myriadrf/LimePSB-RPCM/README.md

# LimePSB RPCM

Lime Planar System Board + Raspberry Pi Compute Module
