myriadrf/LimePSB-RPCM/hardware/1v4/LimePSB-RPCM_1v4_ChangeList.txt

Changes:
LimePSB-RPCM_1v4(_DB)_DFMr2:
 - Schematic changes:
	> BOM version changed from 0 to 1
	> Changed L2, L3 part number (wrong tolerance)
	> R153, R154 NF (disconnected USB hub SMBus from RPI_I2C0)
	> J3 - added additional info parameter and its value
	> Fixed DC barrel J50 part fields
 - PCB changes:
	> GND thermal pad added under miniPCIe on top soldermask and silkscreen
	> LED light pipe mounting hole radius reduced from 1.3 mm to 1 mm
 - DFM:
	> Schematic pdf generated
	> Gerber files and Drill files generated
	> BOM renamed to r2, skipping r1 name to match database
	> BOM updated - L2, L3 position P/N and info, removed R153, R154, J3 - added additional info parameter and its value
	> Pick and place files generated

LimePSB-RPCM_1v4(_DB)_DFMr1:
 - schematic page 5 - mechanical spacers changed to parts with footprints
 - M.2 connector (J3) footprint changed to MiniPCIe_connector_XTRX_v2, which doesn't include mounting holes
 - DFM files refreshed: Top paste gerber layer, Assembly drawings PDF, Pick and Place files, schematic PDF

LimePSB-RPCM_1v4(_DB)_DFMr0:
 - Initial version as an update for LimePSB-RPCM_1v3

LimePSB-RPCM_1v3(_DB)_DFMr2:
 - Created from LimePSB-RPCM_1v3(_DB)_DFMr1;
 - HD01-19-RA-TH changed to 2007435-3
 - Cosmetic schematic changes
 - New DFM files generated;

LimePSB-RPCM_1v3(_DB)_DFMr1:
 - Created from LimePSB-RPCM_1v3(_DB)_DFMr0;
 - Rakon TCXO thermal case hole size increased from 0.9mm to 1.5mm
 - New DFM files generated;

LimePSB-RPCM_1v3(_DB)_DFMr0:
 - Created from LimePSB-RPCM_1v2(_DB)_DFMr0;
 - FPGA added;
 - Reference clock with crystal and configuration headers added;
 - GPS added;
 - USB2 header changed to USB3 header;
 - New DFM files generated;

LimePSB-RPCM_1v2(_DB)_DFMr0:
 - Project name changed from LimeKEY-RPCM to LimePSB-RPCM. Version and revision follow the previous name;
 - Added support for Raspberry Pi CM5 module along with the old CM4. Most changes are related to provide support for both CM4 and CM5;
 - TX PA SBB-5089 changed to TQP3M9018 due to EOL;
 - Dual USB2 connector changed to dual USB3 with;
 - ADC/DAC voltage reference configuration changed (topology is the same);
 - 4-bit switch added for reconfiguring board setup;
 - PCB updated;
 - New DFM files generated.
 
LimeKEY-RPCM_1v1(_DB)_DFMr2:
 - PCB silkscreen updated;
 - BOM comparison to version LimeKEY-RPCM_1v0 added;
 - 0R added at J48 (ISNK_COARSE);
 - C193, C195, C216, C220, C228 changed to GRM21BR61E106KA73K;
 - JMP1, JMP7 made FIT;
 - New DFM files generated;
 
LimeKEY-RPCM_1v1(_DB)_DFMr1:
 - J1 connector P and N signals in diff. pairs swapped pins 9<->11 and 10<->12;
 - IC16A RTC with TSSOP8 package added as an alternative (NF default);
 - R255 for XO VC DAC voltage divider added (NF default);
 - 11 page POE_VDDL net C200 capacitor package changed from 0402 to 0603;
 - PCB updated;
 - New DFM files generated;
 
LimeKEY-RPCM_1v1(_DB)_DFMr0:
 - Initial version
