myriadrf/LimePSB-RPCM/hardware/1v5/PCB/LimePSB-RPCM_1v5.PcbDoc.htm

Reporting Options

# File in Newer Format

Date | : | 2024-10-09
Time | : | 10:48:03
Filename | : | d:\LimePCBs\LimeKEY_RPCM\GIT\hardware\1v3\PCB\LimePSB-RPCM_1v3.PcbDoc

Version | Warning
Release 17.0 | CAUTION - Component parameters added.
Release 17.0 | CAUTION - Support of backdrilling
Release 17.1 | CAUTION - Support of waived violations
Release 17.1 | CAUTION - Support of object specific keepouts

This file was generated by a later version of the software
