myriadrf/LimePSB-RPCM/hardware/1v1/PCB/LimeKEY-RPCM_1v1.PcbDoc.htm

Reporting Options

# File in Newer Format

Date | : | 2023-03-09
Time | : | 14:15:56
Filename | : | E:\Saniok\Lime Micro\Lime PCBs\LimeKEY_RPCM_1v1\Altium Designer design files\PCB\LimeKEY-RPCM_1v1.PcbDoc

Version | Warning
Release 17.0 | CAUTION - Component parameters added.
Release 17.0 | CAUTION - Support of backdrilling
Release 17.1 | CAUTION - Support of waived violations
Release 17.1 | CAUTION - Support of object specific keepouts

This file was generated by a later version of the software
