myriadrf/LimePSB-RPCM/hardware/1v5/Project Outputs for LimePSB-RPCM_1v5/DRC/LimePSB-RPCM_1v5.html

Altium

# Design Rule Verification Report

Date: | | 2026-06-23
Time: | | 15:41:12
Elapsed Time: | | 00:00:39
Filename: | | d:\LimePCBs\LimeKEY_RPCM\GIT\hardware\1v5\PCB\LimePSB-RPCM_1v5.PcbDoc

Warnings: | | 4
Rule Violations: | | 0

## Summary

Warnings | Count
Unplated multi-layer pad(s) detected | 4
Total | 4

Rule Violations | Count
Clearance Constraint (Gap=0mm) (Keepout),(InComponent('J3') or (isvia)) | 0
Clearance Constraint (Gap=0.1mm) (All),(All) | 0
Short-Circuit Constraint (Allowed=No) (All),(All) | 0
Un-Routed Net Constraint ( (All) ) | 0
Modified Polygon (Allow modified: No), (Allow shelved: No) | 0
Width Constraint (Min=0.1mm) (Max=5mm) (Preferred=0.2mm) (All) | 0
Width Constraint (Min=0.1mm) (Max=7mm) (Preferred=0.2mm) (All) | 0
Routing Layers(All) | 0
Routing Via (MinHoleWidth=0.2mm) (MaxHoleWidth=4.5mm) (PreferredHoleWidth=0.2mm) (MinWidth=0.31mm) (MaxWidth=5mm) (PreferedWidth=0.4mm) (All) | 0
Differential Pairs Uncoupled Length using the Gap Constraints (Min=0.1mm) (Max=0.3mm) (Prefered=0.1mm) and Width Constraints (Min=0.1mm) (Max=1mm) (Prefered=0.2mm) (All) | 0
Differential Pairs Uncoupled Length using the Gap Constraints (Min=0.1mm) (Max=0.3mm) (Prefered=0.14mm) and Width Constraints (Min=0.1mm) (Max=1mm) (Prefered=0.2mm) (InNetClass('ETH')) | 0
Power Plane Connect Rule(Relief Connect )(Expansion=0.508mm) (Conductor Width=0.254mm) (Air Gap=0.254mm) (Entries=4) (All) | 0
Hole Size Constraint (Min=0.2mm) (Max=10mm) (All) | 0
Pads and Vias to follow the Drill pairs settings | 0
Hole To Hole Clearance (Gap=0.15mm) (All),(All) | 0
Minimum Solder Mask Sliver (Gap=0.099mm) (All),(All) | 0
Net Antennae (Tolerance=0mm) (All) | 0
Matched Lengths(Tolerance=1.6mm) (InNetClass('HDMI0')) | 0
Matched Lengths(Tolerance=1.6mm) (InNetClass('DSI1')) | 0
Matched Lengths(Tolerance=1.6mm) (InNetClass('uSD_CARD')) | 0
Matched Lengths(Tolerance=1.6mm) (InNetClass('ETH')) | 0
Matched Lengths(Tolerance=1.6mm) (InNetClass('HDMI1')) | 0
Component Clearance Constraint ( Horizontal Gap = -10mm, Vertical Gap = Infinite ) (HasFootprint('MINIPCIE_CONNECTOR_XTRX_v2') or isfree or (((ObjectKind = '3D Body') And (Layer = 'Mechanical13') And (ModelType = 'Generic Model') And (Identifier = '622162x5')) or ((ObjectKind = '3D Body') And (Layer = 'Mechanical13') And (ModelType = 'Generic Model') And (Identifier = 'CM5R5-3dsteps')) or HasFootprint('9774015243R_SMT_M2_STANDOFF_SPACER') )),(HasFootprint('9774015243R_SMT_M2_STANDOFF_SPACER')) | 0
Component Clearance Constraint ( Horizontal Gap = -1mm, Vertical Gap = Infinite ) (HasFootprint('RF_SHIELD_COVER_16Px916P9_2118715-2')),(HasFootprint('RF_SHIELD_FRAME_16P5x16P5_2118716-2_v1')) | 0
Component Clearance Constraint ( Horizontal Gap = -1mm, Vertical Gap = Infinite ) (InComponent('IC8')),(InComponent('IC9')) | 0
Component Clearance Constraint ( Horizontal Gap = -1mm, Vertical Gap = Infinite ) (InComponent('IC10')),(InComponent('IC11')) | 0
Component Clearance Constraint ( Horizontal Gap = -10mm, Vertical Gap = Infinite ) (HasFootprint('LIGHT_PIPE_RIGHT_ANGLE_SLP3-200-100-F')),(((ObjectKind = '3D Body') And (Layer = 'Mechanical13') And (ModelType = 'Generic Model') And (Identifier = 'BIVAR__INC_SLP3-150-100-F'))) | 0
Component Clearance Constraint ( Horizontal Gap = -1mm, Vertical Gap = Infinite ) (InComponent('R62') or InComponent('R69') or InComponent('R70') or InComponent('R248')),(InComponent('R62') or InComponent('R69') or InComponent('R70') or InComponent('R248')) | 0
Component Clearance Constraint ( Horizontal Gap = -10mm, Vertical Gap = Infinite ) (HasFootprint('Header5x2_TH')),(((ObjectKind = '3D Body') And (Layer = 'Mechanical13') And (ModelType = 'Generic Model') And (Identifier = 'TSW-105-07-G-D-009'))) | 0
Component Clearance Constraint ( Horizontal Gap = -10mm, Vertical Gap = Infinite ) (HasFootprint('FP-DF40C-100DS-0.4V(51)') or ((ObjectKind = '3D Body') And (Layer = 'Mechanical13') And (ModelType = 'Generic Model') And (Identifier = '622162x5')) or ((ObjectKind = '3D Body') And (Layer = 'Mechanical13') And (ModelType = 'Generic Model') And (Identifier = 'CM5R5-3dsteps')) or ((ObjectKind = '3D Body') And (Layer = 'Mechanical13') And (ModelType = 'Generic Model') And (Identifier = 'CM5R5-3dsteps'))),(HasFootprint('9774015243R_SMT_M2_STANDOFF_SPACER')) | 0
Component Clearance Constraint ( Horizontal Gap = -1mm, Vertical Gap = Infinite ) (InComponent('R52') or InComponent('R55')),(InComponent('R52') or InComponent('R55')) | 0
Component Clearance Constraint ( Horizontal Gap = -1mm, Vertical Gap = Infinite ) (InComponent('R181') or InComponent('R184') or InComponent('R189')),(InComponent('R181') or InComponent('R184') or InComponent('R189')) | 0
Component Clearance Constraint ( Horizontal Gap = -10mm, Vertical Gap = Infinite ) (HasFootprint('Header10x2_TH_2MM')),(((ObjectKind = '3D Body') And (Layer = 'Mechanical13') And (ModelType = 'Generic Model') And (Identifier = 'g823j201xx0bhr'))) | 0
Component Clearance Constraint ( Horizontal Gap = -1mm, Vertical Gap = 0.254mm ) (HasFootprint('MINIPCIE_CONNECTOR_XTRX_v2')),(All) | 0
Component Clearance Constraint ( Horizontal Gap = 0.01mm, Vertical Gap = 0.254mm ) (All),(All) | 0
Component Clearance Constraint ( Horizontal Gap = -1mm, Vertical Gap = Infinite ) (InComponent('R226') or InComponent('R217')),(InComponent('R226') or InComponent('R217')) | 0

Component Clearance Constraint ( Horizontal Gap = -10mm, Vertical Gap = Infinite ) (HasFootprint('FP-DF40C-100DS-0.4V(51)') or ((ObjectKind = '3D Body') And (ModelType = 'Generic Model') And (Identifier = 'CM4')) or ((ObjectKind = '3D Body') And (Layer = 'Mechanical13') And (ModelType = 'Generic Model') And (Identifier = '9774015243')) or HasFootprint('9774015243R_SMT_M2_STANDOFF_SPACER') or ((ObjectKind = '3D Body') And (Layer = 'Mechanical13') And (ModelType = 'Generic Model') And (Identifier = 'CM5R5-3dsteps'))),(((ObjectKind = '3D Body') And (Layer = 'Mechanical13') And (ModelType = 'Generic Model') And (Identifier = '622162x5')) or ((ObjectKind = '3D Body') And (Layer = 'Mechanical13') And (ModelType = 'Generic Model') And (Identifier = 'CM5R5-3dsteps')) or HasFootprint('9774015243R_SMT_M2_STANDOFF_SPACER'))

0
Component Clearance Constraint ( Horizontal Gap = -10mm, Vertical Gap = Infinite ) (HasFootprint('SW_TACTILE_RIGHT_EDGE')),(((ObjectKind = '3D Body') And (Layer = 'Mechanical13') And (ModelType = 'Generic Model') And (Identifier = 'c-1-1825027-6-g1-3d'))) | 0
Height Constraint (Min=0mm) (Max=40mm) (Prefered=12.7mm) (All) | 0
Total | 0

## Warnings

Unplated multi-layer pad(s) detected

Pad MECH6-MH1(56.125mm,72.475mm) on MultiLayer on Net GND

Pad MECH8-MH1(89.125mm,72.475mm) on MultiLayer on Net GND

Pad MECH10-MH1(89.125mm,24.475mm) on MultiLayer on Net GND

Pad MECH12-MH1(56.125mm,24.475mm) on MultiLayer on Net GND

Back to top
