myriadrf/LimePSB-RPCM/hardware/1v2/LimePSB-RPCM_1v2_DB_DFMr0/DRC/LimePSB-RPCM_1v2.html

Altium

# Design Rule Verification Report

Date: | | 2024-04-18
Time: | | 15:44:20
Elapsed Time: | | 00:00:47
Filename: | | d:\LimePCBs\LimeKEY_RPCM\GIT\hardware\1v2\PCB\LimePSB-RPCM_1v2.PcbDoc

Warnings: | | 4
Rule Violations: | | 0

## Summary

Warnings | Count
Unplated multi-layer pad(s) detected | 4
Total | 4

Rule Violations | Count
Clearance Constraint (Gap=0mm) (Keepout),(InComponent('J3') or (isvia)) | 0
Clearance Constraint (Gap=0.1mm) (All),(All) | 0
Short-Circuit Constraint (Allowed=No) (All),(All) | 0
Un-Routed Net Constraint ( (All) ) | 0
Modified Polygon (Allow modified: No), (Allow shelved: No) | 0
Width Constraint (Min=0.1mm) (Max=5mm) (Preferred=0.2mm) (All) | 0
Width Constraint (Min=0.1mm) (Max=7mm) (Preferred=0.2mm) (All) | 0
Routing Layers(All) | 0
Routing Via (MinHoleWidth=0.2mm) (MaxHoleWidth=4.5mm) (PreferredHoleWidth=0.2mm) (MinWidth=0.31mm) (MaxWidth=5mm) (PreferedWidth=0.4mm) (All) | 0
Differential Pairs Uncoupled Length using the Gap Constraints (Min=0.1mm) (Max=0.3mm) (Prefered=0.14mm) and Width Constraints (Min=0.1mm) (Max=1mm) (Prefered=0.2mm) (InNetClass('ETH')) | 0
Differential Pairs Uncoupled Length using the Gap Constraints (Min=0.1mm) (Max=0.3mm) (Prefered=0.1mm) and Width Constraints (Min=0.1mm) (Max=1mm) (Prefered=0.2mm) (All) | 0
Power Plane Connect Rule(Relief Connect )(Expansion=0.508mm) (Conductor Width=0.254mm) (Air Gap=0.254mm) (Entries=4) (All) | 0
Hole Size Constraint (Min=0.2mm) (Max=10mm) (All) | 0
Pads and Vias to follow the Drill pairs settings | 0
Hole To Hole Clearance (Gap=0.15mm) (All),(All) | 0
Minimum Solder Mask Sliver (Gap=0.099mm) (All),(All) | 0
Net Antennae (Tolerance=0mm) (All) | 0
Matched Lengths(Tolerance=1.6mm) (InNetClass('DSI1')) | 0
Matched Lengths(Tolerance=1.6mm) (InNetClass('HDMI0')) | 0
Matched Lengths(Tolerance=1.6mm) (InNetClass('ETH')) | 0
Matched Lengths(Tolerance=1.6mm) (InNetClass('uSD_CARD')) | 0
Matched Lengths(Tolerance=1.6mm) (InNetClass('HDMI1')) | 0
Component Clearance Constraint ( Horizontal Gap = -10mm, Vertical Gap = Infinite ) (HasFootprint('Header5x2_TH')),(((ObjectKind = '3D Body') And (Layer = 'Mechanical13') And (ModelType = 'Generic Model') And (Identifier = 'TSW-105-07-G-D-009'))) | 0
Component Clearance Constraint ( Horizontal Gap = -1mm, Vertical Gap = Infinite ) (InComponent('R151') or InComponent('R155') or InComponent('R158')),(InComponent('R151') or InComponent('R155') or InComponent('R158')) | 0
Component Clearance Constraint ( Horizontal Gap = -1mm, Vertical Gap = Infinite ) (InComponent('IC13')),(InComponent('IC14')) | 0
Component Clearance Constraint ( Horizontal Gap = -1mm, Vertical Gap = Infinite ) (InComponent('IC10')),(InComponent('IC11')) | 0
Component Clearance Constraint ( Horizontal Gap = -1mm, Vertical Gap = Infinite ) (InComponent('R52') or InComponent('R53')),(InComponent('R52') or InComponent('R53')) | 0
Component Clearance Constraint ( Horizontal Gap = -10mm, Vertical Gap = Infinite ) (HasFootprint('FP-DF40C-100DS-0.4V(51)')),(IsFree) | 0
Component Clearance Constraint ( Horizontal Gap = 0.01mm, Vertical Gap = 0.254mm ) (All),(All) | 0
Component Clearance Constraint ( Horizontal Gap = -1mm, Vertical Gap = Infinite ) (HasFootprint('RF_SHIELD_COVER_16Px916P9_2118715-2')),(HasFootprint('RF_SHIELD_FRAME_16P5x16P5_2118716-2_v1')) | 0
Component Clearance Constraint ( Horizontal Gap = -10mm, Vertical Gap = Infinite ) (HasFootprint('FP-DF40C-100DS-0.4V(51)') or ((ObjectKind = '3D Body') And (ModelType = 'Generic Model') And (Identifier = 'CM4')) or ((ObjectKind = '3D Body') And (Layer = 'Mechanical13') And (ModelType = 'Generic Model') And (Identifier = '9774015243'))),(((ObjectKind = '3D Body') And (Layer = 'Mechanical13') And (ModelType = 'Generic Model') And (Identifier = '622162x5')) or ((ObjectKind = '3D Body') And (Layer = 'Mechanical13') And (ModelType = 'Generic Model') And (Identifier = '9774015243'))) | 0
Component Clearance Constraint ( Horizontal Gap = -1mm, Vertical Gap = 0.254mm ) (HasFootprint('MINIPCIE_CONNECTOR_XTRX')),(All) | 0
Height Constraint (Min=0mm) (Max=40mm) (Prefered=12.7mm) (All) | 0
Total | 0

## Warnings

Unplated multi-layer pad(s) detected

Pad Free-1(56.125mm,24.475mm) on MultiLayer on Net GND

Pad Free-1(89.125mm,72.475mm) on MultiLayer on Net GND

Pad Free-1(56.125mm,72.475mm) on MultiLayer on Net GND

Pad Free-1(89.125mm,24.475mm) on MultiLayer on Net GND

Back to top
