myriadrf/LimePSB-RPCM/hardware/1v2/LimePSB-RPCM_1v2_DB_DFMr0/ERC/LimePSB-RPCM_1v2.html

Altium

# Electrical Rule Check Report

Date: | | 2024-04-18
Time: | | 15:45:10
Filename: | | d:\LimePCBs\LimeKEY_RPCM\GIT\hardware\1v2\Project Outputs for LimePSB-RPCM_1v2\ERC\LimePSB-RPCM_1v2.html

Class | Document | Message
Warning | 07_Misc_2.SchDoc | Net ADC_USR_DIV has no driving source (Pin C37-1,Pin IC8-8,Pin R47-2,Pin R51-1)
Warning | 10_Clock.SchDoc | Net ADF_MUXOUT has no driving source (Pin IC34-15,Pin J1-56,Pin R174-1)
Warning | 06_Misc_1.SchDoc | Net BUZZER has no driving source (Pin J1-34,Pin R28-1,Pin R31-1,Pin VT1-G)
Warning | 06_Misc_1.SchDoc | Net CAM1_CLK_N has no driving source (Pin J2-27,Pin J16-8)
Warning | 06_Misc_1.SchDoc | Net CAM1_CLK_P has no driving source (Pin J2-29,Pin J16-9)
Warning | 06_Misc_1.SchDoc | Net CAM1_D0_N has no driving source (Pin J2-15,Pin J16-2)
Warning | 06_Misc_1.SchDoc | Net CAM1_D0_P has no driving source (Pin J2-17,Pin J16-3)
Warning | 06_Misc_1.SchDoc | Net CAM1_D1_N has no driving source (Pin J2-21,Pin J16-5)
Warning | 06_Misc_1.SchDoc | Net CAM1_D1_P has no driving source (Pin J2-23,Pin J16-6)
Warning | 06_Misc_1.SchDoc | Net CAM1_GPIO0 has no driving source (Pin J1-97,Pin J16-11)
Warning | 06_Misc_1.SchDoc | Net DSI1_CLK_N has no driving source (Pin J2-87,Pin J15-5)
Warning | 06_Misc_1.SchDoc | Net DSI1_CLK_P has no driving source (Pin J2-89,Pin J15-6)
Warning | 06_Misc_1.SchDoc | Net DSI1_D0_N has no driving source (Pin J2-75,Pin J15-8)
Warning | 06_Misc_1.SchDoc | Net DSI1_D0_P has no driving source (Pin J2-77,Pin J15-9)
Warning | 06_Misc_1.SchDoc | Net DSI1_D1_N has no driving source (Pin J2-81,Pin J15-2)
Warning | 06_Misc_1.SchDoc | Net DSI1_D1_P has no driving source (Pin J2-83,Pin J15-3)
Warning | 09_USB_HDMI.SchDoc | Net EN_CM5_USB3 has no driving source (Pin IC1-6,Pin IC26-10,Pin IC27-10,Pin IC29-6,Pin IC30-6,Pin R131-1,Pin R132-1,Pin SW1-4)
Warning | 06_Misc_1.SchDoc | Net ETH_LED_G has no driving source (Pin J1-17,Pin R29-2)
Warning | 06_Misc_1.SchDoc | Net ETH_LED_Y has no driving source (Pin J1-15,Pin R30-2)
Warning | 06_Misc_1.SchDoc | Net ETH_TRD0_N has no driving source (Pin J1-10,Pin J9-2,Pin VD2-A)
Warning | 06_Misc_1.SchDoc | Net ETH_TRD0_P has no driving source (Pin J1-12,Pin J9-1,Pin VD1-A)
Warning | 06_Misc_1.SchDoc | Net ETH_TRD1_N has no driving source (Pin J1-6,Pin J9-6,Pin VD4-A)
Warning | 06_Misc_1.SchDoc | Net ETH_TRD1_P has no driving source (Pin J1-4,Pin J9-3,Pin VD3-A)
Warning | 06_Misc_1.SchDoc | Net ETH_TRD2_N has no driving source (Pin J1-9,Pin J9-8,Pin VD6-A)
Warning | 06_Misc_1.SchDoc | Net ETH_TRD2_P has no driving source (Pin J1-11,Pin J9-7,Pin VD5-A)
Warning | 05_RPi_mPCIe.SchDoc | Net ETH_TRD3_N has no driving source (Pin J1-5,Pin J9-10,Pin VD8-A)
Warning | 05_RPi_mPCIe.SchDoc | Net ETH_TRD3_P has no driving source (Pin J1-3,Pin J9-9,Pin VD7-A)
Warning | 09_USB_HDMI.SchDoc | Net HDMI0_HPD has no driving source (Pin ESD13-1,Pin J2-53,Pin J30-19)
Warning | 09_USB_HDMI.SchDoc | Net HDMI1_HPD has no driving source (Pin ESD25-1,Pin J2-43,Pin J31-19)
Warning | 07_Misc_2.SchDoc | Net NetC34_2 has no driving source (Pin C34-2,Pin C35-1,Pin IC8-15,Pin R45-1,Pin R48-2,Pin R49-1)
Warning | 07_Misc_2.SchDoc | Net NetC54_2 has no driving source (Pin C54-2,Pin IC19-2,Pin R91-1)
Warning | 08_USB_hub.SchDoc | Net NetC60_2 has no driving source (Pin C60-2,Pin IC20-61,Pin R107-1,Pin XT2-1)
Warning | 10_Clock.SchDoc | Net NetC111_2 has no driving source (Pin C111-2,Pin XO4-7)
Warning | 10_Clock.SchDoc | Net NetC118_2 has no driving source (Pin C118-2,Pin C120-2,Pin IC32-1,Pin IC32-3,Pin R157-2,Pin R159-2)
Warning | 11_RFFE.SchDoc | Net NetC160_1 has no driving source (Pin C160-1,Pin IC39-2)
Warning | 11_RFFE.SchDoc | Net NetC162_1 has no driving source (Pin C162-1,Pin IC40-2)
Warning | 12_PoE_USB_PD.SchDoc | Net NetC219_2 has no driving source (Pin C219-2,Pin IC49-20)
Warning | 13_Power.SchDoc | Net NetC251_2 has no driving source (Pin C251-2,Pin FR14-2,Pin IC54-5,Pin IC54-8)
Warning | 08_USB_hub.SchDoc | Net NetIC20_44 has no driving source (Pin IC20-44,Pin R101-2)
Warning | 08_USB_hub.SchDoc | Net NetIC20_63 has no driving source (Pin IC20-63,Pin R105-1)
Warning | 08_USB_hub.SchDoc | Net NetIC21_10 has no driving source (Pin IC21-10,Pin R115-1,Pin R119-2,Pin R120-1)
Warning | 08_USB_hub.SchDoc | Net NetIC24_3 has no driving source (Pin IC24-3,Pin R126-1,Pin R127-1)
Warning | 09_USB_HDMI.SchDoc | Net NetIC25_3 has no driving source (Pin IC25-3,Pin R134-1,Pin R135-1,Pin R137-1)
Warning | 09_USB_HDMI.SchDoc | Net NetIC28_3 has no driving source (Pin IC28-3,Pin R141-1)
Warning | 12_PoE_USB_PD.SchDoc | Net NetIC49_2 has no driving source (Pin IC49-2,Pin R213-2)
Warning | 12_PoE_USB_PD.SchDoc | Net NetIC49_3 has no driving source (Pin IC49-3,Pin R221-1,Pin R222-1,Pin R225-1)
Warning | 12_PoE_USB_PD.SchDoc | Net NetIC49_4 has no driving source (Pin IC49-4,Pin R216-2)
Warning | 12_PoE_USB_PD.SchDoc | Net NetIC49_5 has no driving source (Pin IC49-5,Pin R219-1)
Warning | 12_PoE_USB_PD.SchDoc | Net NetIC49_11 has no driving source (Pin IC49-11,Pin R230-2)
Warning | 12_PoE_USB_PD.SchDoc | Net NetIC49_12 has no driving source (Pin IC49-12,Pin R229-2)
Warning | 05_RPi_mPCIe.SchDoc | Net PCIE_LED_WLAN has no driving source (Pin J1-41,Pin J3-44)
Warning | 05_RPi_mPCIe.SchDoc | Net PCIE_LED_WPAN has no driving source (Pin J1-24,Pin J3-46)
Warning | 05_RPi_mPCIe.SchDoc | Net PCIE_LED_WWAN has no driving source (Pin J1-29,Pin J3-42)
Warning | 06_Misc_1.SchDoc | Net RPI_AIP0 has no driving source (Pin J1-96,Pin J12-5)
Warning | 06_Misc_1.SchDoc | Net RPI_AIP1 has no driving source (Pin J1-94,Pin J12-6)
Warning | 05_RPi_mPCIe.SchDoc | Net RPI_BT_nDISABLE has no driving source (Pin J1-91,Pin J6-3)
Warning | 06_Misc_1.SchDoc | Net RPI_BTN1 has no driving source (Pin BTN1-1,Pin C25-1,Pin J1-45,Pin R27-2)
Warning | 06_Misc_1.SchDoc | Net RPI_BTN2 has no driving source (Pin C12-1,Pin J1-47,Pin J8-5,Pin R13-2)
Warning | 06_Misc_1.SchDoc | Net RPI_EEPROM_nWP has no driving source (Pin J1-20,Pin J12-4,Pin R32-2)
Warning | 07_Misc_2.SchDoc | Net RPI_GLOBAL_EN has no driving source (Pin J1-99,Pin J5-1,Pin J12-14,Pin R93-1)
Warning | 06_Misc_1.SchDoc | Net RPI_GPIO2 has no driving source (Pin J1-58,Pin J10-15)
Warning | 06_Misc_1.SchDoc | Net RPI_GPIO4 has no driving source (Pin J1-54,Pin J10-16)
Warning | 06_Misc_1.SchDoc | Net RPI_GPIO22 has no driving source (Pin J1-46,Pin J10-3)
Warning | 06_Misc_1.SchDoc | Net RPI_GPIO27 has no driving source (Pin J1-48,Pin J10-5)
Warning | 06_Misc_1.SchDoc | Net RPI_ID_SC has no driving source (Pin J1-35,Pin J8-3,Pin J10-18,Pin R18-1)
Warning | 06_Misc_1.SchDoc | Net RPI_ID_SD has no driving source (Pin J1-36,Pin J8-4,Pin J10-17,Pin R14-1)
Warning | 06_Misc_1.SchDoc | Net RPI_LED_nPWR has no driving source (Pin IC3-2,Pin J1-95,Pin R12-2,Pin R15-2)
Warning | 08_USB_hub.SchDoc | Net RPI_nEXTRST has no driving source (Pin J1-100,Pin R104-2)
Warning | 06_Misc_1.SchDoc | Net RPI_nRPIBOOT has no driving source (Pin J1-93,Pin J12-2,Pin SW1-1)
Warning | 05_RPi_mPCIe.SchDoc | Net RPI_PCIE_CLK_N has no driving source (Pin C1-2,Pin J2-12)
Warning | 05_RPi_mPCIe.SchDoc | Net RPI_PCIE_CLK_nREQ has no driving source (Pin J2-2,Pin J3-7)
Warning | 05_RPi_mPCIe.SchDoc | Net RPI_PCIE_CLK_P has no driving source (Pin C2-2,Pin J2-10)
Warning | 05_RPi_mPCIe.SchDoc | Net RPI_PCIE_DET_nWAKE has no driving source (Pin J2-6,Pin R1-1)
Warning | 05_RPi_mPCIe.SchDoc | Net RPI_PCIE_nRST has no driving source (Pin J2-9,Pin J3-22)
Warning | 05_RPi_mPCIe.SchDoc | Net RPI_PCIE_RX_N has no driving source (Pin J2-18,Pin J3-23)
Warning | 05_RPi_mPCIe.SchDoc | Net RPI_PCIE_RX_P has no driving source (Pin J2-16,Pin J3-25)
Warning | 05_RPi_mPCIe.SchDoc | Net RPI_PCIE_TX_N has no driving source (Pin J2-24,Pin R5-2)
Warning | 05_RPi_mPCIe.SchDoc | Net RPI_PCIE_TX_P has no driving source (Pin J2-22,Pin R7-2)
Warning | 05_RPi_mPCIe.SchDoc | Net RPI_PIN11 has no driving source (Pin IC1-4,Pin J2-11,Pin J12-11)
Warning | 10_Clock.SchDoc | Net RPI_PIN16 has no driving source (Pin IC35-2,Pin J1-16,Pin R173-2)
Warning | 10_Clock.SchDoc | Net RPI_PIN18 has no driving source (Pin IC35-1,Pin J1-18,Pin R171-2)
Warning | 06_Misc_1.SchDoc | Net RPI_PWM0 has no driving source (Pin IC7-3,Pin J1-31)
Warning | 06_Misc_1.SchDoc | Net RPI_PWM1 has no driving source (Pin IC7-1,Pin J1-28)
Warning | 07_Misc_2.SchDoc | Net RPI_RF_SW_TDD has no driving source (Pin J1-30,Pin R40-2)
Warning | 06_Misc_1.SchDoc | Net RPI_RUN_PG has no driving source (Pin IC5-2,Pin J1-92,Pin J5-3,Pin J12-10,Pin R21-2)
Warning | 06_Misc_1.SchDoc | Net RPI_SD_CLK has no driving source (Pin J1-57,Pin J7-5)
Warning | 06_Misc_1.SchDoc | Net RPI_SD_CMD has no driving source (Pin J1-62,Pin J7-3)
Warning | 06_Misc_1.SchDoc | Net RPI_SD_D0 has no driving source (Pin J1-63,Pin J7-7)
Warning | 06_Misc_1.SchDoc | Net RPI_SD_D1 has no driving source (Pin J1-67,Pin J7-8)
Warning | 06_Misc_1.SchDoc | Net RPI_SD_D2 has no driving source (Pin J1-69,Pin J7-1)
Warning | 06_Misc_1.SchDoc | Net RPI_SD_D3 has no driving source (Pin J1-61,Pin J7-2)
Warning | 06_Misc_1.SchDoc | Net RPI_SD_PWR_ON has no driving source (Pin IC6-3,Pin J1-75,Pin R22-1)
Warning | 06_Misc_1.SchDoc | Net RPI_SPI0_MISO has no driving source (Pin J1-40,Pin J10-11)
Warning | 10_Clock.SchDoc | Net RPI_SPI0_MOSI_R has no driving source (Pin IC33-7,Pin IC36-3,Pin R186-1)
Warning | 10_Clock.SchDoc | Net RPI_SPI0_MOSI has no driving source (Pin J1-44,Pin J10-9,Pin R180-1,Pin R186-2)
Warning | 10_Clock.SchDoc | Net RPI_SPI0_SCLK_R has no driving source (Pin IC33-6,Pin IC36-2,Pin R185-1)
Warning | 10_Clock.SchDoc | Net RPI_SPI0_SCLK has no driving source (Pin J1-38,Pin J10-13,Pin R178-1,Pin R185-2)
Warning | 10_Clock.SchDoc | Net RPI_SPI0_SS0_R has no driving source (Pin IC33-5,Pin IC36-1,Pin R184-1)
Warning | 10_Clock.SchDoc | Net RPI_SPI0_SS0 has no driving source (Pin J1-39,Pin R184-2)
Warning | 10_Clock.SchDoc | Net RPI_SPI0_SS1 has no driving source (Pin J1-37,Pin R181-1)
Warning | 07_Misc_2.SchDoc | Net RPI_SPI1_MOSI has no driving source (Pin IC8-11,Pin IC15-14,Pin J1-27)
Warning | 07_Misc_2.SchDoc | Net RPI_SPI1_SCLK has no driving source (Pin IC8-13,Pin IC15-11,Pin IC17-11,Pin J1-25)
Warning | 07_Misc_2.SchDoc | Net RPI_SPI1_SS0 has no driving source (Pin IC8-10,Pin J1-49)
Warning | 07_Misc_2.SchDoc | Net RPI_SPI1_SS1 has no driving source (Pin IC15-12,Pin IC17-12,Pin J1-50)
Warning | 07_Misc_2.SchDoc | Net RPI_STATUS_LED_R has no driving source (Pin J1-21,Pin R89-1)
Warning | 06_Misc_1.SchDoc | Net RPI_UART0_RX has no driving source (Pin J1-51,Pin J10-10,Pin J11-3)
Warning | 06_Misc_1.SchDoc | Net RPI_UART0_TX has no driving source (Pin J1-55,Pin J10-8,Pin J11-2)
Warning | 09_USB_HDMI.SchDoc | Net RPI_USB3_D0_N has no driving source (Pin IC26-7,Pin J2-36)
Warning | 09_USB_HDMI.SchDoc | Net RPI_USB3_D0_P has no driving source (Pin IC26-6,Pin J2-34)
Warning | 09_USB_HDMI.SchDoc | Net RPI_USB3_D1_N has no driving source (Pin IC27-7,Pin J2-65)
Warning | 09_USB_HDMI.SchDoc | Net RPI_USB3_D1_P has no driving source (Pin IC27-6,Pin J2-63)
Warning | 08_USB_hub.SchDoc | Net RPI_USB_D_N has no driving source (Pin IC21-2,Pin J2-3,Pin R122-2)
Warning | 08_USB_hub.SchDoc | Net RPI_USB_D_P has no driving source (Pin IC21-1,Pin J2-5,Pin R121-2)
Warning | 08_USB_hub.SchDoc | Net RPI_USB_OTG_ID has no driving source (Pin J2-1,Pin R108-1,Pin R115-2)
Warning | 07_Misc_2.SchDoc | Net RPI_VBAT has no driving source (Pin J1-76,Pin R78-1)
Warning | 05_RPi_mPCIe.SchDoc | Net RPI_WL_nDISABLE has no driving source (Pin J1-89,Pin J6-1)
Warning | 07_Misc_2.SchDoc | Net RTC_nINT has no driving source (Pin C54-1,Pin IC16-3,Pin IC18-3,Pin R90-1)
Warning | 07_Misc_2.SchDoc | Net RTC_OSCI has no driving source (Pin IC16-1,Pin IC18-1,Pin XT1-1)
Warning | 07_Misc_2.SchDoc | Net RTC_OSCO contains multiple Output Pins (Pin IC18-2)
Warning | 07_Misc_2.SchDoc | Net SCAP_TEMP has no driving source (Pin C36-1,Pin IC8-7,Pin J52-4,Pin J53-4,Pin R46-2,Pin R50-1)
Warning | 07_Misc_2.SchDoc | Net SR_OE has no driving source (Pin IC15-13,Pin IC17-13,Pin R92-2,Pin R94-1,Pin R96-1)
Warning | 10_Clock.SchDoc | Net TCXO_DAC_VREF has no driving source (Pin C139-2,Pin C140-1,Pin IC33-2,Pin R165-1,Pin R166-1,Pin R172-1)
Warning | 05_RPi_mPCIe.SchDoc | Net UIM_CLK has no driving source (Pin J3-12,Pin J4-C3)
Warning | 05_RPi_mPCIe.SchDoc | Net UIM_RESET has no driving source (Pin J3-14,Pin J4-C2)
Warning | 08_USB_hub.SchDoc | Net USB_HUB_CFG_SEL2 has no driving source (Pin IC20-13,Pin R111-1,Pin R116-2)
Warning | 08_USB_hub.SchDoc | Net USB_HUB_RST has no driving source (Pin C56-2,Pin IC20-43,Pin R103-1,Pin R104-1)
Warning | 12_PoE_USB_PD.SchDoc | Net USB_PD_HPI_SLC has no driving source (Pin IC51-13,Pin R249-1,Pin R251-1)
Warning | 05_RPi_mPCIe.SchDoc | Net VCC1P8_RPI has no driving source (Pin C6-2,Pin J1-88,Pin J1-90)
Warning | 05_RPi_mPCIe.SchDoc | Net VCC3P3_RPI has no driving source (Pin C7-2,Pin J1-84,Pin J1-86,Pin R6-1)
Warning | 11_RFFE.SchDoc | Net VCC5P0_RFA has no driving source (Pin C158-1,Pin C179-1,Pin C188-1,Pin C189-1,Pin C196-2,Pin C197-2,Pin C198-2,Pin C200-1,Pin FR9-2,Pin IC38-1,Pin IC42-1,Pin IC47-1,Pin IC48-1,Pin R189-2,Pin R190-2,Pin R193-1,Pin R194-1,Pin R207-1,Pin R208-1)
Warning | 11_RFFE.SchDoc | Net VCC5P0_RFB has no driving source (Pin C156-1,Pin C178-1,Pin C186-1,Pin C187-1,Pin C194-2,Pin C195-2,Pin C199-2,Pin C201-1,Pin FR10-2,Pin IC37-1,Pin IC41-1,Pin IC45-1,Pin IC46-1,Pin R187-2,Pin R188-2,Pin R191-1,Pin R192-1,Pin R205-1,Pin R206-1)
Warning | 07_Misc_2.SchDoc | Net VCC12P0_POE_DIV has no driving source (Pin C43-1,Pin IC8-3,Pin R56-2,Pin R62-2)
Warning | 07_Misc_2.SchDoc | Net VCC_BARREL_DIV has no driving source (Pin C41-1,Pin IC8-1,Pin R54-2,Pin R60-2)
Warning | 07_Misc_2.SchDoc | Net VCC_EXT_DIV has no driving source (Pin C44-1,Pin IC8-4,Pin R57-2,Pin R63-2)
Warning | 07_Misc_2.SchDoc | Net VCC_INT_DIV has no driving source (Pin C45-1,Pin IC8-5,Pin R58-2,Pin R64-2)
Warning | 07_Misc_2.SchDoc | Net VCC_SCAP_DIV has no driving source (Pin C46-1,Pin IC8-6,Pin R59-2,Pin R65-2)
Warning | 07_Misc_2.SchDoc | Net VCC_USB_PD_DIV has no driving source (Pin C42-1,Pin IC8-2,Pin R55-2,Pin R61-2)
Warning | 10_Clock.SchDoc | Net XO_VC has no driving source (Pin R162-1,Pin R167-2,Pin XO1-1,Pin XO2-1,Pin XO3-1,Pin XO4-1,Pin XO5-1)

Back to top
