myriadrf/LimePSB-RPCM/hardware/1v1/Project Outputs for LimeKEY-RPCM_1v1/DRC/LimeKEY-RPCM_1v1.html

Altium

# Design Rule Verification Report

Date: | | 2023-03-10
Time: | | 11:05:46
Elapsed Time: | | 00:01:14
Filename: | | E:\Saniok\Lime Micro\Lime PCBs\LimeKEY_RPCM_1v1\Altium Designer design files\PCB\LimeKEY-RPCM_1v1.PcbDoc

Warnings: | | 0
Rule Violations: | | 0

## Summary

Warnings | Count
Total | 0

Rule Violations | Count
Clearance Constraint (Gap=0mm) (Keepout),(InComponent('J3') or (isvia)) | 0
Clearance Constraint (Gap=0.1mm) (All),(All) | 0
Short-Circuit Constraint (Allowed=No) (All),(All) | 0
Un-Routed Net Constraint ( (All) ) | 0
Modified Polygon (Allow modified: No), (Allow shelved: No) | 0
Width Constraint (Min=0.1mm) (Max=5mm) (Preferred=0.2mm) (All) | 0
Width Constraint (Min=0.1mm) (Max=7mm) (Preferred=0.2mm) (All) | 0
Routing Layers(All) | 0
Routing Via (MinHoleWidth=0.2mm) (MaxHoleWidth=4.5mm) (PreferredHoleWidth=0.2mm) (MinWidth=0.31mm) (MaxWidth=5mm) (PreferedWidth=0.4mm) (All) | 0
Differential Pairs Uncoupled Length using the Gap Constraints (Min=0.1mm) (Max=0.3mm) (Prefered=0.14mm) and Width Constraints (Min=0.1mm) (Max=1mm) (Prefered=0.2mm) (InNetClass('ETH')) | 0
Differential Pairs Uncoupled Length using the Gap Constraints (Min=0.1mm) (Max=0.3mm) (Prefered=0.1mm) and Width Constraints (Min=0.1mm) (Max=1mm) (Prefered=0.2mm) (All) | 0
Power Plane Connect Rule(Relief Connect )(Expansion=0.508mm) (Conductor Width=0.254mm) (Air Gap=0.254mm) (Entries=4) (All) | 0
Hole Size Constraint (Min=0.2mm) (Max=10mm) (All) | 0
Pads and Vias to follow the Drill pairs settings | 0
Hole To Hole Clearance (Gap=0.15mm) (All),(All) | 0
Minimum Solder Mask Sliver (Gap=0.099mm) (All),(All) | 0
Net Antennae (Tolerance=0mm) (All) | 0
Matched Lengths(Tolerance=1.6mm) (InNetClass('DSI1')) | 0
Matched Lengths(Tolerance=1.6mm) (InNetClass('HDMI0')) | 0
Matched Lengths(Tolerance=1.6mm) (InNetClass('ETH')) | 0
Matched Lengths(Tolerance=1.6mm) (InNetClass('uSD_CARD')) | 0
Matched Lengths(Tolerance=1.6mm) (InNetClass('HDMI1')) | 0
Component Clearance Constraint ( Horizontal Gap = -10mm, Vertical Gap = Infinite ) (HasFootprint('Header5x2_TH')),(((ObjectKind = '3D Body') And (Layer = 'Mechanical13') And (ModelType = 'Generic Model') And (Identifier = 'TSW-105-07-G-D-009'))) | 0
Component Clearance Constraint ( Horizontal Gap = -1mm, Vertical Gap = Infinite ) (InComponent('R142') or InComponent('R145') or InComponent('R138')),(InComponent('R142') or InComponent('R145') or InComponent('R138')) | 0
Component Clearance Constraint ( Horizontal Gap = -1mm, Vertical Gap = Infinite ) (InComponent('IC13')),(InComponent('IC14')) | 0
Component Clearance Constraint ( Horizontal Gap = -1mm, Vertical Gap = Infinite ) (InComponent('IC10')),(InComponent('IC11')) | 0
Component Clearance Constraint ( Horizontal Gap = -1mm, Vertical Gap = Infinite ) (InComponent('R53') or InComponent('R54')),(InComponent('R53') or InComponent('R54')) | 0
Component Clearance Constraint ( Horizontal Gap = -10mm, Vertical Gap = Infinite ) (HasFootprint('FP-DF40C-100DS-0.4V(51)')),(IsFree) | 0
Component Clearance Constraint ( Horizontal Gap = 0.01mm, Vertical Gap = 0.254mm ) (All),(All) | 0
Component Clearance Constraint ( Horizontal Gap = -1mm, Vertical Gap = Infinite ) (HasFootprint('RF_SHIELD_COVER_16Px916P9_2118715-2')),(HasFootprint('RF_SHIELD_FRAME_16P5x16P5_2118716-2_v1')) | 0
Component Clearance Constraint ( Horizontal Gap = -10mm, Vertical Gap = Infinite ) (HasFootprint('FP-DF40C-100DS-0.4V(51)') or ((ObjectKind = '3D Body') And (ModelType = 'Generic Model') And (Identifier = 'CM4')) or ((ObjectKind = '3D Body') And (Layer = 'Mechanical13') And (ModelType = 'Generic Model') And (Identifier = '9774015243'))),(((ObjectKind = '3D Body') And (Layer = 'Mechanical13') And (ModelType = 'Generic Model') And (Identifier = '622162x5')) or ((ObjectKind = '3D Body') And (Layer = 'Mechanical13') And (ModelType = 'Generic Model') And (Identifier = '9774015243'))) | 0
Component Clearance Constraint ( Horizontal Gap = -1mm, Vertical Gap = 0.254mm ) (HasFootprint('MINIPCIE_CONNECTOR_XTRX')),(All) | 0
Height Constraint (Min=0mm) (Max=40mm) (Prefered=12.7mm) (All) | 0
Total | 0
