myriadrf/LimePSB-RPCM/hardware/1v1/Project Outputs for LimeKEY-RPCM_1v1/ERC/LimeKEY-RPCM_1v1.html

Altium

# Electrical Rule Check Report

Date: | | 2023-03-10
Time: | | 11:07:11
Filename: | | E:\Saniok\Lime Micro\Lime PCBs\LimeKEY_RPCM_1v1\Altium Designer design files\Project Outputs for LimeKEY-RPCM_1v1\ERC\LimeKEY-RPCM_1v1.html

Class | Document | Message
Warning | 07_Misc_2.SchDoc | Net ADC_USR_DIV has no driving source (Pin C38-1,Pin IC8-8,Pin R48-2,Pin R52-1)
Warning | 09_Clock.SchDoc | Net ADF_MUXOUT has no driving source (Pin IC27-15,Pin J1-56,Pin R159-1)
Warning | 07_Misc_2.SchDoc | Net BUZZER has no driving source (Pin J1-34,Pin R82-1,Pin R85-1,Pin VT2-G)
Warning | 06_Misc_1.SchDoc | Net CAM1_CLK_N has no driving source (Pin J2-27,Pin J18-8)
Warning | 06_Misc_1.SchDoc | Net CAM1_CLK_P has no driving source (Pin J2-29,Pin J18-9)
Warning | 06_Misc_1.SchDoc | Net CAM1_D0_N has no driving source (Pin J2-15,Pin J18-2)
Warning | 06_Misc_1.SchDoc | Net CAM1_D0_P has no driving source (Pin J2-17,Pin J18-3)
Warning | 06_Misc_1.SchDoc | Net CAM1_D1_N has no driving source (Pin J2-21,Pin J18-5)
Warning | 06_Misc_1.SchDoc | Net CAM1_D1_P has no driving source (Pin J2-23,Pin J18-6)
Warning | 06_Misc_1.SchDoc | Net CAM1_GPIO0 has no driving source (Pin J1-97,Pin J18-11)
Warning | 06_Misc_1.SchDoc | Net DSI1_CLK_N has no driving source (Pin J2-87,Pin J17-5)
Warning | 06_Misc_1.SchDoc | Net DSI1_CLK_P has no driving source (Pin J2-89,Pin J17-6)
Warning | 06_Misc_1.SchDoc | Net DSI1_D0_N has no driving source (Pin J2-75,Pin J17-8)
Warning | 06_Misc_1.SchDoc | Net DSI1_D0_P has no driving source (Pin J2-77,Pin J17-9)
Warning | 06_Misc_1.SchDoc | Net DSI1_D1_N has no driving source (Pin J2-81,Pin J17-2)
Warning | 06_Misc_1.SchDoc | Net DSI1_D1_P has no driving source (Pin J2-83,Pin J17-3)
Warning | 06_Misc_1.SchDoc | Net ETH_LED_G has no driving source (Pin J1-17,Pin R26-2)
Warning | 06_Misc_1.SchDoc | Net ETH_LED_Y has no driving source (Pin J1-15,Pin R27-2)
Warning | 06_Misc_1.SchDoc | Net ETH_TRD0_N has no driving source (Pin J1-12,Pin J9-2,Pin VD2-A)
Warning | 06_Misc_1.SchDoc | Net ETH_TRD0_P has no driving source (Pin J1-10,Pin J9-1,Pin VD1-A)
Warning | 06_Misc_1.SchDoc | Net ETH_TRD1_N has no driving source (Pin J1-6,Pin J9-6,Pin VD4-A)
Warning | 06_Misc_1.SchDoc | Net ETH_TRD1_P has no driving source (Pin J1-4,Pin J9-3,Pin VD3-A)
Warning | 06_Misc_1.SchDoc | Net ETH_TRD2_N has no driving source (Pin J1-11,Pin J9-8,Pin VD6-A)
Warning | 06_Misc_1.SchDoc | Net ETH_TRD2_P has no driving source (Pin J1-9,Pin J9-7,Pin VD5-A)
Warning | 05_RPi_mPCIe.SchDoc | Net ETH_TRD3_N has no driving source (Pin J1-5,Pin J9-10,Pin VD8-A)
Warning | 05_RPi_mPCIe.SchDoc | Net ETH_TRD3_P has no driving source (Pin J1-3,Pin J9-9,Pin VD7-A)
Warning | 06_Misc_1.SchDoc | Net HDMI0_HOTPLUG has no driving source (Pin J2-53,Pin J12-19)
Warning | 06_Misc_1.SchDoc | Net HDMI1_HOTPLUG has no driving source (Pin J2-43,Pin J13-19)
Warning | 07_Misc_2.SchDoc | Net NetC35_2 has no driving source (Pin C35-2,Pin C36-1,Pin IC8-15,Pin R46-1,Pin R49-2,Pin R50-1)
Warning | 07_Misc_2.SchDoc | Net NetC54_2 has no driving source (Pin C54-2,Pin IC17-2,Pin R89-1)
Warning | 08_USB.SchDoc | Net NetC60_2 has no driving source (Pin C60-2,Pin IC18-61,Pin R102-1,Pin XT2-1)
Warning | 09_Clock.SchDoc | Net NetC98_2 has no driving source (Pin C98-2,Pin XO4-7)
Warning | 09_Clock.SchDoc | Net NetC105_2 has no driving source (Pin C105-2,Pin C107-2,Pin IC25-1,Pin IC25-3,Pin R144-2,Pin R146-2)
Warning | 11_PoE_USB_PD.SchDoc | Net NetC205_2 has no driving source (Pin C205-2,Pin IC41-20)
Warning | 12_Power.SchDoc | Net NetC237_2 has no driving source (Pin C237-2,Pin FR14-2,Pin IC46-5,Pin IC46-8)
Warning | 06_Misc_1.SchDoc | Net NetIC7_3 has no driving source (Pin IC7-3,Pin R36-1)
Warning | 07_Misc_2.SchDoc | Net NetIC16_1 has no driving source (Pin IC16-1,Pin XT1-1)
Warning | 08_USB.SchDoc | Net NetIC18_44 has no driving source (Pin IC18-44,Pin R96-2)
Warning | 08_USB.SchDoc | Net NetIC18_63 has no driving source (Pin IC18-63,Pin R100-1)
Warning | 08_USB.SchDoc | Net NetIC19_10 has no driving source (Pin IC19-10,Pin R110-1,Pin R114-2,Pin R115-1)
Warning | 08_USB.SchDoc | Net NetIC22_3 has no driving source (Pin IC22-3,Pin R121-1,Pin R122-1)
Warning | 08_USB.SchDoc | Net NetIC23_3 has no driving source (Pin IC23-3,Pin R127-1,Pin R128-1)
Warning | 11_PoE_USB_PD.SchDoc | Net NetIC41_2 has no driving source (Pin IC41-2,Pin R196-2)
Warning | 11_PoE_USB_PD.SchDoc | Net NetIC41_3 has no driving source (Pin IC41-3,Pin R204-1,Pin R205-1,Pin R208-1)
Warning | 11_PoE_USB_PD.SchDoc | Net NetIC41_4 has no driving source (Pin IC41-4,Pin R199-2)
Warning | 11_PoE_USB_PD.SchDoc | Net NetIC41_5 has no driving source (Pin IC41-5,Pin R202-1)
Warning | 11_PoE_USB_PD.SchDoc | Net NetIC41_11 has no driving source (Pin IC41-11,Pin R213-2)
Warning | 11_PoE_USB_PD.SchDoc | Net NetIC41_12 has no driving source (Pin IC41-12,Pin R212-2)
Warning | 05_RPi_mPCIe.SchDoc | Net PCIE_LED_WLAN has no driving source (Pin J1-41,Pin J3-44)
Warning | 05_RPi_mPCIe.SchDoc | Net PCIE_LED_WPAN has no driving source (Pin J1-24,Pin J3-46)
Warning | 05_RPi_mPCIe.SchDoc | Net PCIE_LED_WWAN has no driving source (Pin J1-29,Pin J3-42)
Warning | 06_Misc_1.SchDoc | Net RPI_AIP0 has no driving source (Pin J1-96,Pin J14-5)
Warning | 06_Misc_1.SchDoc | Net RPI_AIP1 has no driving source (Pin J1-94,Pin J14-6)
Warning | 05_RPi_mPCIe.SchDoc | Net RPI_BT_nDISABLE has no driving source (Pin J1-91,Pin J6-3)
Warning | 07_Misc_2.SchDoc | Net RPI_BTN1 has no driving source (Pin BTN1-1,Pin C52-1,Pin J1-45,Pin R81-2)
Warning | 06_Misc_1.SchDoc | Net RPI_BTN2 has no driving source (Pin C9-1,Pin J1-47,Pin J8-5,Pin R12-2)
Warning | 06_Misc_1.SchDoc | Net RPI_EEPROM_nWP has no driving source (Pin J1-20,Pin J14-4,Pin R28-2)
Warning | 06_Misc_1.SchDoc | Net RPI_GPIO2 has no driving source (Pin J1-58,Pin J10-15)
Warning | 06_Misc_1.SchDoc | Net RPI_GPIO4 has no driving source (Pin J1-54,Pin J10-16)
Warning | 06_Misc_1.SchDoc | Net RPI_GPIO22 has no driving source (Pin J1-46,Pin J10-3)
Warning | 06_Misc_1.SchDoc | Net RPI_GPIO27 has no driving source (Pin J1-48,Pin J10-5)
Warning | 06_Misc_1.SchDoc | Net RPI_ID_SC has no driving source (Pin J1-35,Pin J8-3,Pin J10-18,Pin R17-1)
Warning | 06_Misc_1.SchDoc | Net RPI_ID_SD has no driving source (Pin J1-36,Pin J8-4,Pin J10-17,Pin R13-1)
Warning | 06_Misc_1.SchDoc | Net RPI_LED_nPWR has no driving source (Pin IC2-2,Pin J1-95,Pin R11-2,Pin R14-2)
Warning | 08_USB.SchDoc | Net RPI_nEXTRST has no driving source (Pin J1-100,Pin R99-2)
Warning | 06_Misc_1.SchDoc | Net RPI_nRPIBOOT has no driving source (Pin J1-93,Pin J14-2)
Warning | 05_RPi_mPCIe.SchDoc | Net RPI_PCIE_CLK_N has no driving source (Pin J2-12,Pin J3-11)
Warning | 05_RPi_mPCIe.SchDoc | Net RPI_PCIE_CLK_nREQ has no driving source (Pin J2-2,Pin J3-7)
Warning | 05_RPi_mPCIe.SchDoc | Net RPI_PCIE_CLK_P has no driving source (Pin J2-10,Pin J3-13)
Warning | 05_RPi_mPCIe.SchDoc | Net RPI_PCIE_nRST has no driving source (Pin J2-9,Pin J3-22)
Warning | 05_RPi_mPCIe.SchDoc | Net RPI_PCIE_RX_N has no driving source (Pin J2-18,Pin J3-23)
Warning | 05_RPi_mPCIe.SchDoc | Net RPI_PCIE_RX_P has no driving source (Pin J2-16,Pin J3-25)
Warning | 05_RPi_mPCIe.SchDoc | Net RPI_PCIE_TX_N has no driving source (Pin J2-24,Pin R4-2)
Warning | 05_RPi_mPCIe.SchDoc | Net RPI_PCIE_TX_P has no driving source (Pin J2-22,Pin R5-2)
Warning | 06_Misc_1.SchDoc | Net RPI_PWM0 has no driving source (Pin IC6-3,Pin J1-31)
Warning | 06_Misc_1.SchDoc | Net RPI_PWM1 has no driving source (Pin IC6-1,Pin J1-28)
Warning | 07_Misc_2.SchDoc | Net RPI_RF_SW_TDD has no driving source (Pin J1-30,Pin R41-2)
Warning | 06_Misc_1.SchDoc | Net RPI_RUN_PG has no driving source (Pin IC4-2,Pin J1-92,Pin J5-3,Pin R20-2)
Warning | 06_Misc_1.SchDoc | Net RPI_SD_CLK has no driving source (Pin J1-57,Pin J7-5)
Warning | 06_Misc_1.SchDoc | Net RPI_SD_CMD has no driving source (Pin J1-62,Pin J7-3)
Warning | 06_Misc_1.SchDoc | Net RPI_SD_D0 has no driving source (Pin J1-63,Pin J7-7)
Warning | 06_Misc_1.SchDoc | Net RPI_SD_D1 has no driving source (Pin J1-67,Pin J7-8)
Warning | 06_Misc_1.SchDoc | Net RPI_SD_D2 has no driving source (Pin J1-69,Pin J7-1)
Warning | 06_Misc_1.SchDoc | Net RPI_SD_D3 has no driving source (Pin J1-61,Pin J7-2)
Warning | 06_Misc_1.SchDoc | Net RPI_SD_PWR_ON has no driving source (Pin IC5-3,Pin J1-75,Pin R21-1)
Warning | 06_Misc_1.SchDoc | Net RPI_SPI0_MISO has no driving source (Pin J1-40,Pin J10-11)
Warning | 09_Clock.SchDoc | Net RPI_SPI0_MOSI_R has no driving source (Pin IC26-7,Pin IC28-3,Pin R169-1)
Warning | 09_Clock.SchDoc | Net RPI_SPI0_MOSI has no driving source (Pin J1-44,Pin J10-9,Pin R164-1,Pin R169-2)
Warning | 09_Clock.SchDoc | Net RPI_SPI0_SCLK_R has no driving source (Pin IC26-6,Pin IC28-2,Pin R168-1)
Warning | 09_Clock.SchDoc | Net RPI_SPI0_SCLK has no driving source (Pin J1-38,Pin J10-13,Pin R162-1,Pin R168-2)
Warning | 09_Clock.SchDoc | Net RPI_SPI0_SS0_R has no driving source (Pin IC26-5,Pin IC28-1,Pin R167-1)
Warning | 09_Clock.SchDoc | Net RPI_SPI0_SS0 has no driving source (Pin J1-39,Pin R167-2)
Warning | 09_Clock.SchDoc | Net RPI_SPI0_SS1 has no driving source (Pin J1-37,Pin R165-1)
Warning | 07_Misc_2.SchDoc | Net RPI_SPI1_MOSI has no driving source (Pin IC8-11,Pin IC12-14,Pin J1-27)
Warning | 07_Misc_2.SchDoc | Net RPI_SPI1_SCLK has no driving source (Pin IC8-13,Pin IC12-11,Pin IC15-11,Pin J1-25)
Warning | 07_Misc_2.SchDoc | Net RPI_SPI1_SS0 has no driving source (Pin IC8-10,Pin J1-49)
Warning | 07_Misc_2.SchDoc | Net RPI_SPI1_SS1 has no driving source (Pin IC12-12,Pin IC15-12,Pin J1-50)
Warning | 07_Misc_2.SchDoc | Net RPI_STATUS_LED_R has no driving source (Pin J1-21,Pin R87-1)
Warning | 06_Misc_1.SchDoc | Net RPI_TVDAC has no driving source (Pin J2-11,Pin J14-11,Pin J16-1,Pin J19-4)
Warning | 06_Misc_1.SchDoc | Net RPI_UART0_RX has no driving source (Pin J1-51,Pin J10-10,Pin J11-3)
Warning | 06_Misc_1.SchDoc | Net RPI_UART0_TX has no driving source (Pin J1-55,Pin J10-8,Pin J11-2)
Warning | 08_USB.SchDoc | Net RPI_USB_D_N has no driving source (Pin IC19-2,Pin J2-3,Pin R117-2)
Warning | 08_USB.SchDoc | Net RPI_USB_D_P has no driving source (Pin IC19-1,Pin J2-5,Pin R116-2)
Warning | 08_USB.SchDoc | Net RPI_USB_OTG_ID has no driving source (Pin J2-1,Pin R103-1,Pin R110-2)
Warning | 05_RPi_mPCIe.SchDoc | Net RPI_WL_nDISABLE has no driving source (Pin J1-89,Pin J6-1)
Warning | 07_Misc_2.SchDoc | Net RTC_nINT has no driving source (Pin C54-1,Pin IC16-3,Pin R88-1)
Warning | 07_Misc_2.SchDoc | Net SCAP_TEMP has no driving source (Pin C37-1,Pin IC8-7,Pin J52-4,Pin J53-4,Pin R47-2,Pin R51-1)
Warning | 07_Misc_2.SchDoc | Net SR_OE has no driving source (Pin IC12-13,Pin IC15-13,Pin R90-2,Pin R91-1,Pin R93-1)
Warning | 09_Clock.SchDoc | Net TCXO_DAC_VREF has no driving source (Pin C126-2,Pin C127-1,Pin IC26-2,Pin R152-1,Pin R153-1,Pin R158-1)
Warning | 05_RPi_mPCIe.SchDoc | Net UIM_CLK has no driving source (Pin J3-12,Pin J4-C3)
Warning | 05_RPi_mPCIe.SchDoc | Net UIM_RESET has no driving source (Pin J3-14,Pin J4-C2)
Warning | 08_USB.SchDoc | Net USB_HUB_CFG_SEL2 has no driving source (Pin IC18-13,Pin R106-1,Pin R111-2)
Warning | 08_USB.SchDoc | Net USB_HUB_RST has no driving source (Pin C56-2,Pin IC18-43,Pin R98-1,Pin R99-1)
Warning | 11_PoE_USB_PD.SchDoc | Net USB_PD_HPI_SLC has no driving source (Pin IC43-13,Pin R231-1,Pin R233-1)
Warning | 05_RPi_mPCIe.SchDoc | Net VCC3P3_RPI has no driving source (Pin C6-2,Pin J1-84,Pin J1-86,Pin R7-1)
Warning | 10_RFFE.SchDoc | Net VCC5P0_RFA has no driving source (Pin C144-1,Pin C165-1,Pin C174-1,Pin C175-1,Pin C182-2,Pin C183-2,Pin C184-2,Pin C186-1,Pin FR9-2,Pin IC30-1,Pin IC34-1,Pin IC39-1,Pin IC40-1,Pin R172-2,Pin R173-2,Pin R176-1,Pin R177-1,Pin R190-1,Pin R191-1)
Warning | 10_RFFE.SchDoc | Net VCC5P0_RFB has no driving source (Pin C142-1,Pin C164-1,Pin C172-1,Pin C173-1,Pin C180-2,Pin C181-2,Pin C185-2,Pin C187-1,Pin FR10-2,Pin IC29-1,Pin IC33-1,Pin IC37-1,Pin IC38-1,Pin R170-2,Pin R171-2,Pin R174-1,Pin R175-1,Pin R188-1,Pin R189-1)
Warning | 07_Misc_2.SchDoc | Net VCC12P0_POE_DIV has no driving source (Pin C44-1,Pin IC8-3,Pin R57-2,Pin R63-2)
Warning | 07_Misc_2.SchDoc | Net VCC_BARREL_DIV has no driving source (Pin C42-1,Pin IC8-1,Pin R55-2,Pin R61-2)
Warning | 07_Misc_2.SchDoc | Net VCC_EXT_DIV has no driving source (Pin C45-1,Pin IC8-4,Pin R58-2,Pin R64-2)
Warning | 07_Misc_2.SchDoc | Net VCC_INT_DIV has no driving source (Pin C46-1,Pin IC8-5,Pin R59-2,Pin R65-2)
Warning | 07_Misc_2.SchDoc | Net VCC_SCAP_DIV has no driving source (Pin C47-1,Pin IC8-6,Pin R60-2,Pin R66-2)
Warning | 07_Misc_2.SchDoc | Net VCC_USB_PD_DIV has no driving source (Pin C43-1,Pin IC8-2,Pin R56-2,Pin R62-2)
Warning | 09_Clock.SchDoc | Net XO_VC has no driving source (Pin R149-1,Pin R157-2,Pin XO1-1,Pin XO2-1,Pin XO3-1,Pin XO4-1,Pin XO5-1)

Back to top
