myriadrf/LimePSB-RPCM/hardware/1v0/Project Outputs for LimeKEY-RPCM_1v0/DRC/LimeKEY-RPCM_1v0.html

Altium

# Design Rule Verification Report

Date: | | 2022-10-11
Time: | | 15:06:20
Elapsed Time: | | 00:00:55
Filename: | | E:\Saniok\Lime Micro\Lime PCBs\LimeKEY_RPCM_1v0\Aletium Designer design files\PCB\LimeKEY-RPCM_1v0.PcbDoc

Warnings: | | 0
Rule Violations: | | 0

## Summary

Warnings | Count
Total | 0

Rule Violations | Count
Clearance Constraint (Gap=0mm) (Keepout),(InComponent('J3')) | 0
Clearance Constraint (Gap=0.1mm) (All),(All) | 0
Short-Circuit Constraint (Allowed=No) (All),(All) | 0
Un-Routed Net Constraint ( (All) ) | 0
Modified Polygon (Allow modified: No), (Allow shelved: No) | 0
Width Constraint (Min=0.1mm) (Max=7mm) (Preferred=0.2mm) (All) | 0
Width Constraint (Min=0.1mm) (Max=5mm) (Preferred=0.2mm) (All) | 0
Routing Layers(All) | 0
Routing Via (MinHoleWidth=0.2mm) (MaxHoleWidth=4.5mm) (PreferredHoleWidth=0.2mm) (MinWidth=0.31mm) (MaxWidth=5mm) (PreferedWidth=0.4mm) (All) | 0
Differential Pairs Uncoupled Length using the Gap Constraints (Min=0.1mm) (Max=0.3mm) (Prefered=0.14mm) and Width Constraints (Min=0.1mm) (Max=1mm) (Prefered=0.2mm) (InNetClass('ETH')) | 0
Differential Pairs Uncoupled Length using the Gap Constraints (Min=0.1mm) (Max=0.3mm) (Prefered=0.1mm) and Width Constraints (Min=0.1mm) (Max=1mm) (Prefered=0.2mm) (All) | 0
Power Plane Connect Rule(Relief Connect )(Expansion=0.508mm) (Conductor Width=0.254mm) (Air Gap=0.254mm) (Entries=4) (All) | 0
Hole Size Constraint (Min=0.2mm) (Max=10mm) (All) | 0
Pads and Vias to follow the Drill pairs settings | 0
Hole To Hole Clearance (Gap=0.15mm) (All),(All) | 0
Minimum Solder Mask Sliver (Gap=0.099mm) (All),(All) | 0
Net Antennae (Tolerance=0mm) (All) | 0
Matched Lengths(Tolerance=1.6mm) (InNetClass('DSI1')) | 0
Matched Lengths(Tolerance=1.6mm) (InNetClass('HDMI0')) | 0
Matched Lengths(Tolerance=1.6mm) (InNetClass('ETH')) | 0
Matched Lengths(Tolerance=1.6mm) (InNetClass('HDMI1')) | 0
Matched Lengths(Tolerance=1.6mm) (InNetClass('uSD_CARD')) | 0
Component Clearance Constraint ( Horizontal Gap = -1mm, Vertical Gap = Infinite ) (InComponent('IC12')),(InComponent('IC13')) | 0
Component Clearance Constraint ( Horizontal Gap = -1mm, Vertical Gap = Infinite ) (InComponent('IC10')),(InComponent('IC11')) | 0
Component Clearance Constraint ( Horizontal Gap = -1mm, Vertical Gap = Infinite ) (InComponent('R142') or InComponent('R146') or InComponent('R149')),(InComponent('R142') or InComponent('R146') or InComponent('R149')) | 0
Component Clearance Constraint ( Horizontal Gap = 0.01mm, Vertical Gap = 0.254mm ) (All),(All) | 0
Component Clearance Constraint ( Horizontal Gap = -1mm, Vertical Gap = Infinite ) (InComponent('R51') or InComponent('R52')),(InComponent('R51') or InComponent('R52')) | 0
Component Clearance Constraint ( Horizontal Gap = -1mm, Vertical Gap = Infinite ) (HasFootprint('RF_SHIELD_COVER_16Px916P9_2118715-2')),(HasFootprint('RF_SHIELD_FRAME_16P5x16P5_2118716-2_v1')) | 0
Height Constraint (Min=0mm) (Max=40mm) (Prefered=12.7mm) (All) | 0
Total | 0
