myriadrf/LimePSB-RPCM/hardware/1v5/Project Outputs for LimePSB-RPCM_1v5/BOM/LimePSB-RPCM_1v5_BOMr0_(Default).xlsx

Item # | Comment | Quantity | Designator | Footprint | Manufacturer | Manufacturer Part Number 1 | Supplier 1 | Supplier Part Number 1 | Part Description | Additional Info
1 | CR1220 Battery Holder | 1 | BATT1 | CR1220_SMD_holder | MPD (Memory Protection Devices) | BC501SM | Digi-Key | BC501SM-ND | HOLDER COIN CELL FOR CR1220 SMD
2 | KMB210S | 2 | BR1, BR2 | KMB210S_RECTIFIER_BRIDGE | SMC Diode Solutions | KMB210S | Digi-Key | 1655-KMB210SCT-ND | Bridge Rectifier Single Phase Schottky 100 V Surface Mount MBS
3 | Switch tactile right edge | 1 | BTN1 | SW_TACTILE_RIGHT_EDGE | CIT Relay & Switch | CT1102V6.85F160 | Digikey | 2449-CT1102V6.85F160-ND | Tactile Switch SPST-NO Side Actuated Through Hole, Right Angle
4 | WST-1203UX | 1 | BZ1 | BUZZER_WST-1203UX | Soberton Inc. | WST-1203UX | Digi-Key | 433-1047-ND | Buzzers Indicator, Internally Driven Magnetic 3V 30mA 2.3kHz 82dB @ 3V, 10cm Through Hole PC Pins
5 | 100nF, 16V | 115 | C1, C2, C9, C10, C11, C13, C14, C15, C17, C19, C20, C21, C23, C24, C27, C28, C32, C33, C35, C36, C37, C38, C39, C40, C41, C42, C43, C44, C45, C46, C47, C48, C49, C50, C51, C52, C53, C54, C56, C58, C60, C62, C65, C67, C69, C72, C73, C77, C79, C80, C81, C82, C83, C84, C86, C87, C90, C95, C99, C100, C101, C103, C104, C105, C106, C107, C108, C109, C110, C111, C114, C115, C116, C117, C121, C128, C133, C138, C139, C145, C151, C153, C164, C167, C168, C169, C170, C171, C175, C181, C182, C184, C193, C202, C203, C204, C205, C215, C217, C233, C235, C246, C253, C254, C255, C256, C263, C264, C265, C277, C285, C286, C327, C332, C333 | CAP0402 | Murata Electronics | GRM155R71C104KA88D | Mouser | 81-GRM155R71C104KA88 | 0.10µF ±10% 16V Ceramic Capacitor X7R 0402 (1005 Metric), 0.10µF ±10% 16V X7R Ceramic Capacitor -55°C ~ 125°C Surface Mount, MLCC 0402 (1005 Metric) 0.039" L x 0.020" W (1.00mm x 0.50mm)
6 | 1uF, 10V | 42 | C3, C16, C26, C34, C70, C71, C76, C78, C85, C89, C94, C98, C120, C127, C144, C174, C183, C197, C213, C214, C231, C232, C245, C249, C250, C251, C252, C261, C262, C273, C282, C304, C306, C307, C308, C314, C315, C316, C317, C325, C330, C331 | CAP0402 | Yageo | CC0402MRX5R6BB105 | Digi-Key | 311-1732-1-ND | 1µF 10V Ceramic Capacitor X5R 0402 (1005 Metric) 0.039" L x 0.020" W (1.00mm x 0.50mm)
7 | 47uF, 10V | 8 | C4, C5, C22, C25, C88, C91, C93, C96 | CAP1206 | TDK Corporation | C3216X6S1A476M160AC | Digi-Key | 445-6010-1-ND | 47µF ±20% 10V Ceramic Capacitor X6S 1206 (3216 Metric)
8 | 10uF, 16V | 3 | C12, C112, C165 | CAP0603 | Yageo | GRM188R61C106MA73D | Digi-Key | 490-7201-2-ND | 10µF ±20% 16V Ceramic Capacitor X5R 0603 (1608 Metric)
9 | 4.7uF, 6.3V | 17 | C29, C55, C57, C59, C61, C64, C66, C68, C287, C288, C290, C291, C292, C294, C295, C296, C297 | CAP0402 | Murata Electronics North America | GRM155R60J475ME87D | Digi-Key | 490-5408-1-ND | 4.7µF ±20% 6.3V X5R Ceramic Capacitor -55°C ~ 85°C Surface Mount, MLCC 0402 (1005 Metric) 0.039" L x 0.020" W (1.00mm x 0.50mm)
10 | 22pF, 50V | 7 | C74, C75, C158, C159, C160, C162, C196 | CAP0402 | Yageo | CC0402JRNPO9BN220 | Digi-Key | 311-1018-2-ND | 22pF ±5% 50V C0G, NP0 Ceramic Capacitor -55°C ~ 125°C Surface Mount, MLCC 0402 (1005 Metric) 0.039" L x 0.020" W (1.00mm x 0.50mm)
11 | 100pF, 50V | 42 | C113, C122, C123, C129, C130, C131, C132, C140, C141, C142, C143, C146, C148, C149, C150, C166, C176, C177, C185, C186, C187, C188, C199, C206, C216, C218, C219, C220, C221, C222, C223, C224, C227, C228, C234, C236, C237, C238, C239, C240, C241, C242 | CAP0402 | Yageo | CC0402JRNPO9BN101 | Digi-Key | 311-1024-1-ND | 100pF ±5% 50V C0G, NP0 Ceramic Capacitor -55°C ~ 125°C Surface Mount, MLCC 0402 (1005 Metric) 0.039" L x 0.020" W (1.00mm x 0.50mm)
12 | 1nF, 50V | 7 | C152, C154, C155, C299, C300, C311, C312 | CAP0402 | Murata Electronics North America | GCM155R71H102KA37D | Digi-Key | 490-4761-1-ND | 1000pF ±10% 50V Ceramic Capacitor X7R 0402 (1005 Metric)
13 | 220pF, 50V | 1 | C161 | CAP0402 | Yageo | CC0402KRX7R9BB221 | Digi-Key | 311-1035-2-ND | 220pF ±10% 50V X7R Ceramic Capacitor -55°C ~ 125°C Surface Mount, MLCC 0402 (1005 Metric) 0.039" L x 0.020" W (1.00mm x 0.50mm)
14 | 10uF, 6.3V | 1 | C198 | CAP0603 | Yageo | CC0603MRX5R5BB106 | Digi-Key | 311-1448-2-ND | 10µF ±20% 6.3V X5R Ceramic Capacitor -55°C ~ 85°C Surface Mount, MLCC 0603 (1608 Metric) 0.063" L x 0.031" W (1.60mm x 0.80mm)
15 | 470nF, 16V | 4 | C209, C210, C229, C230 | CAP0805_FEEDTHROUGH | Murata | NFM21PC474R1C3D | Digi-Key | 490-2537-1-ND | 0.47µF Feed Through Capacitor 16V 2A 30mOhm 0805 (2012 Metric), 3 PC Pad
16 | 10nF, 50V | 6 | C225, C226, C243, C244, C310, C324 | CAP0402 | Murata Electronics North America, Yageo | GRM155R71H103KA88D, [NoValue] | Digi-Key | 490-4516-2-ND, 311-1349-2-ND | 10000pF ±10% 50V Ceramic Capacitor X7R 0402 (1005 Metric), 10000pF ±10% 50V X7R Ceramic Capacitor -55°C ~ 125°C Surface Mount, MLCC 0402 (1005 Metric) 0.039" L x 0.020" W (1.00mm x 0.50mm)
17 | 10uF, 25V | 5 | C266, C270, C278, C319, C321 | CAP0805 | Murata | GRM21BR61E106KA73K | Digi-Key | 490-16824-1-ND | CAP CER 10UF 25V X5R 0805
18 | 47uF, 6.3V | 3 | C267, C268, C279 | CAP1206 | Samsung Electro-Mechanics | CL31A476MQHNNNE | Digi-Key | 1276-1167-1-ND | 47µF ±20% 6.3V Ceramic Capacitor X5R 1206 (3216 Metric)
19 | 22nF, 50V | 5 | C271, C272, C276, C318, C320 | CAP0402 | Kemet | C0402C223K5RACTU | Digi-Key | 399-7780-1-ND | 0.022µF ±10% 50V X7R Ceramic Capacitor -55°C ~ 125°C Surface Mount, MLCC 0402 (1005 Metric) 0.039" L x 0.020" W (1.00mm x 0.50mm)
20 | 4.7pF, 50V | 1 | C274 | CAP0402 | Murata Electronics North America | GRM1555C1H4R7CA01D | Farnell | 2434644 | 4.7pF ±0.25pF 50V C0G, NP0 Ceramic Capacitor -55°C ~ 125°C Surface Mount, MLCC 0402 (1005 Metric) 0.039" L x 0.020" W (1.00mm x 0.50mm)
21 | 1200pF, 50V | 2 | C275, C284 | CAP0402 | Kemet | C0402C122J5GACTU | Digi-Key | 399-7334-1-ND | 1200pF ±5% 50V C0G, NP0 Ceramic Capacitor -55°C ~ 125°C Surface Mount, MLCC 0402 (1005 Metric) 0.039" L x 0.020" W (1.00mm x 0.50mm), 1200pF ±5% 50V Ceramic Capacitor C0G, NP0 0402 (1005 Metric)
22 | 2.2pF, 50V | 1 | C283 | CAP0402 | Samsung Electro-Mechanics America, Inc. | CL05C2R2CB5NNNC | Digi-Key | 1276-1271-1-ND | 2.2pF ±0.25pF 50V Ceramic Capacitor C0G, NP0 0402 (1005 Metric)
23 | 1000pF, 2kV | 2 | C301, C309 | CAP1812 | KEMET | C1812C102KGRACTU | Digi-Key | 399-3447-1-ND | 1000pF ±10% 2000V (2kV) Ceramic Capacitor X7R 1812 (4532 Metric)
24 | 1.5pF, 50V | 2 | C302, C313 | CAP0402 | Murata | GRM1555C1H1R5BA01D | Digikey | 490-6212-1-ND
25 | 100nF, 100V | 1 | C303 | CAP0603 | Murata Electronics North America | GRM188R72A104KA35D | Digi-Key | 490-3285-1-ND | 0.1µF ±10% 100V Ceramic Capacitor X7R 0603 (1608 Metric)
26 | 1nF, 100V | 1 | C305 | CAP0603 | KEMET | C0603C102K1RACTU | Digi-Key | 399-7831-2-ND | 1000pF ±10% 100V Ceramic Capacitor X7R 0603 (1608 Metric)
27 | 220uF, 16V | 2 | C322, C323 | CAP_POL_SIZE_F_v2 | Kyocera AVX | APA0609221M016R | Digikey | 478-APA0609221M016RCT-ND | 220 µF 16 V Aluminum - Polymer Capacitors Radial, Can - SMD 30mOhm 5000 Hrs @ 105°C
28 | 1uF, 25V | 3 | C326, C328, C329 | CAP0603 | Samsung Electro-Mechanics | CL10A105KA8NNNC | Digi-Key | 1276-1102-1-ND | 1µF ±10% 25V Ceramic Capacitor X5R 0603 (1608 Metric)
29 | 390pF, 50V | 2 | C334, C335 | CAP0402 | Samsung | CL05B391KB5NNNC | Digi-Key | 1276-1560-1-ND | 390 pF ±10% 50V Ceramic Capacitor X7R 0402 (1005 Metric)
30 | BAT54C | 1 | D1 | BAT54C_SOT23-3 | Comchip | BAT54C-G | Digi-Key | 641-1320-1-ND | Diode Array 1 Pair Common Cathode Schottky 30 V 200mA (DC) Surface Mount TO-236-3, SC-59, SOT-23-3
31 | BAS316 | 1 | D2 | BAS316_DIODE_SOD323 | Nexperia | BAS316,115 | Digi-Key | 1727-4309-1-ND | DIODE GEN PURP 100V 250MA SOD323
32 | NZH10C-115 | 1 | D3 | NZH10C,115_shottky_diode_SOD123 | Nexperia | NZH10C,115 | Digi-Key | 1727-5057-1-ND | DIODE ZENER 10V 500MW SOD123F
33 | 4 bit switch | 1 | DSW1 | SW_4WAY_SMD_1P27 | Omron Electronics Inc-EMC Div | A6H-4101 | Digi-Key | SW1080-ND | Dip Switch SPST 4 Position Surface Mount Slide (Standard) Actuator 25mA 24VDC
34 | ESD8472 | 38 | ESD1, ESD2, ESD3, ESD4, ESD5, ESD6, ESD7, ESD8, ESD9, ESD10, ESD11, ESD12, ESD13, ESD14, ESD15, ESD16, ESD17, ESD18, ESD19, ESD20, ESD21, ESD22, ESD23, ESD24, ESD25, ESD26, ESD27, ESD28, ESD29, ESD30, ESD31, ESD32, ESD33, ESD34, ESD36, ESD37, ESD38, ESD39 | ESD8472_X3DFN2 | ON Semiconductor | ESD8472MUT5G | Digi-Key | ESD8472MUT5GOSCT-ND | TVS DIODE 5.3VWM 14VC X3DFN2
35 | Fiducial | 8 | F1, F2, F3, F4, F5, F6, F7, F8 | Fiducial
36 | 0R | 3 | F9, F10, R297 | RES0805 | Vishay Dale | CRCW08050000Z0EA | Digi-Key | 541-0.0ATR-ND | RES SMD 0.0 OHM JUMPER 1/8W 0805
37 | 12V DC FAN | 1 | FAN1 | FAN_80mm_V1 | Sunon Fans | MF80151V2-1000U-A99 | TME | MF80151V2-A99-A | Fan Tubeaxial 12VDC Square - 80mm L x 80mm H Vapo-Bearing™ 33.6 CFM (0.941m³/min) 2 Wire Leads
38 | Fiducial | 4 | FL1, FL2, FL3, FL4 | Fiducial_local
39 | 600R, 2A | 9 | FR1, FR4, FR9, FR13, FR14, FR16, FR18, FR20, FR22 | RES0805 | TDK Corporation | MPZ2012S601AT000 | Digi-Key | 445-2206-2-ND | FERRITE BEAD 600 OHM 0805 1LN
40 | 600R, 0.5A | 12 | FR2, FR3, FR5, FR6, FR7, FR8, FR10, FR11, FR12, FR21, FR23, FR24 | RES0402 | Murata | BLM15AX601SN1D | Digi-Key | 490-5441-1-ND | - Ferrite Bead 0402 (1005 Metric) 500mA 340mOhm
41 | 74LVC1G3157FZ4 | 8 | IC1, IC33, IC35, IC40, IC41, IC42, IC43, IC45 | 74LVC1G3157FZ4_SPDT_SW_DFN1410-6 | Diodes | 74LVC1G3157FZ4-7 | Digi-Key | 74LVC1G3157FZ4-7DICT-ND | 1 Circuit IC Switch 2:1 10Ohm X2-DFN1410-6
42 | 74LVC1G34QSE-7 | 3 | IC2, IC3, IC17 | 74AHCT1G126SE-7_BUFFER_SOT353 | Diodes | 74LVC1G34QSE-7 | Mouser | 621-74LVC1G34QSE-7 | Buffers & Line Drivers Logic LVC 1 Gate SOT353 T&R 3K
43 | MIC2039 | 8 | IC4, IC24, IC25, IC28, IC60, IC61, IC62, IC63 | SOT23-6 | Microchip | MIC2039EYM6-TR | Digi-Key | 576-4193-1-ND | Power Switch/Driver 1:1 P-Channel 2.5A SOT-23-6
44 | NC7WZ16P6X | 1 | IC5 | SC-70_NC7WZ16P6X | Nexperia | 74LVC2G34GW,125 | Digi-Key | 1727-4219-1-ND | Buffer, Non-Inverting 2 Element 1 Bit per Element Push-Pull Output 6-TSSOP
45 | MCP3208 | 1 | IC6 | MCP3208-CI/SL_SOIC16 | Microchip | MCP3208T-CI/SL | Digi-Key | MCP3208T-CI/SLCT-ND | 12 Bit Analog to Digital Converter 4, 8 Input 1 SAR 16-SOIC
46 | LM75 | 1 | IC7 | HWSON8_LM75 | NXP Semiconductors | LM75BTP,147 | Digi-Key | 568-9815-2-ND | SENSOR TEMPERATURE I2C 8HWSON
47 | CAT24C128WI-GT3 | 1 | IC8 | SOIC127P600-8DL_v2 | ON Semiconductor | CAT24C128WI-GT3 | Digi-Key | CAT24C128WI-GT3CT-ND | EEPROM Memory IC 128Kb (16K x 8) I²C 1MHz 400ns 8-SOIC
48 | ATECC508A | 1 | IC11 | ATECC508A_UDFN8 | Microchip | ATECC508A-MAHDA-S | Digi-Key | ATECC508A-MAHDA-SDKR-ND | Authentication Chip IC Networking and Communications 8-UDFN (2x3)
49 | MCP23017-E/ML | 2 | IC12, IC15 | MCP23017-E/ML_QFN28 | Microchip | MCP23017-E/ML | Digi-Key | MCP23017-E/ML-ND | I/O Expander 16 I²C 1.7 MHz 28-QFN (6x6)
50 | EMC2301-1-ACZL-TR | 1 | IC13 | EMC2301-1-ACZL-TR_MOTOR_DRIVER_TSSOP8 | Microchip | EMC2301-1-ACZL-TR | Digikey | EMC2301-1-ACZL-CT-ND | IC MOTOR DRIVER 3V-3.6V 8MSOP
51 | PCF85063AT | 1 | IC14 | PCF85063AT_RTC_SOIC-8 | NXP Semiconductors | PCF85063AT/AY | Digi-Key | 568-12403-1-ND | IC RTC CLOCK/CALENDAR I2C 8SO
52 | ICE5LP4K-SG48ITR | 1 | IC18 | ICE5LP4K-SG48ITR_Lattice_FPGA_QFN48 | Lattice Semiconductor | ICE5LP4K-SG48ITR | Digikey | 220-2234-1-ND | iCE40 Ultra™ Field Programmable Gate Array (FPGA) IC 39 81920 3520 48-VFQFN Exposed Pad
53 | USB2517 | 1 | IC20 | USB2517-JZX-TR_USB_HUB_QFN64 | Microchip | USB2517-JZX-TR | Digi-Key | USB2517-JZX-CT-ND | USB Hub Controller USB 2.0 USB Interface 64-QFN (9x9)
54 | NX3DV42GU | 4 | IC21, IC26, IC27, IC47 | FSUSB42UMX | NXP Semiconductors | NX3DV42GU,115 | Digikey | 568-12388-1-ND | USB Switch IC 1 Channel 10-UMLP (1.8x1.4)
55 | FUSB340TMX | 2 | IC29, IC30 | FUSB340TMX_USB_switch_18-XFQFN | ON Semiconductor / Fairchild | FUSB340TMX | Digikey | FUSB340TMXCT-ND | USB Switch USB 3.1 USB Interface 18-TMLP (2x2.8)
56 | LMK00105 | 2 | IC31, IC39 | LMK00105SQ | Texas Instruments | LMK00105SQ/NOPB | Digi-Key | LMK00105SQ/NOPBCT-ND | IC CLK BUFFER 2:5 200MHZ 24WQFN
57 | TMUX1204DGSR | 1 | IC32 | TMUX1204DGSR_ANALOG_SWITCH_10-TSSOP | Texas Instruments | TMUX1204DGSR | Digikey | 296-TMUX1204DGSRCT-ND | 1 Circuit IC Switch 4:1 5Ohm (Typ) 10-VSSOP
58 | AD5662 | 1 | IC36 | AD5662_SOT23-8 | Analog Devices Inc. | AD5662BRJZ-2REEL7 | Digi-Key | AD5662BRJZ-2REEL7CT-ND | IC DAC 16BIT BUFF V-OUT SOT23-8
59 | ADF4002 | 1 | IC37 | ADF4002 | Analog Devices Inc | ADF4002BCPZ-RL7 | Digi-Key | ADF4002BCPZ-RL7CT-ND | IC PLL FREQUENCY SYNTH 20-LFCSP
60 | NEO-M8Q | 1 | IC48 | NEO-7M/8M | U-blox | NEO-M8Q-0 | Digi-Key | 672-1009-1-ND | IC RECEIVER GPS/GNSS 24LCC
61 | BGS12WN6 | 4 | IC50, IC51, IC56, IC57 | BGS12WN6E6327XTSA1_TSNP6-10 | Infineon | BGS12WN6E6327XTSA1 | DigiKey | 448-BGS12WN6E6327XTSA1CT-ND | RF Switch IC WLAN SPDT 50Ohm PG-TSNP-6-10
62 | TQP3M9018 | 2 | IC52, IC54 | TQP3M9018_PA_QFN16 | Qorvo | TQP3M9019 | Mouser | 772-TQP3M9019 | RF Amplifier .05-4GHz P1dB= 22dB Gain 26.4dB 5Volts
63 | HHM22152A2 | 2 | IC53, IC55 | HHM22152A2_DIRECTIONAL_COUPLER | TDK | HHM22152A2 | Digikey | 445-175379-1-ND | RF Directional Coupler General Purpose 3W 0603 (1608 Metric), 6 PC Pad
64 | SPF5043Z | 2 | IC58, IC59 | SPF5043Z_SOT-343 | Qorvo | SPF5043Z | Mouser | 772-SPF5043Z | RF Amplifier .05-4GHz SSG 12.9dB NF .8dB GaAs
65 | ADP2386 | 2 | IC64, IC65 | ADP2386 | Analog Devices Inc. | ADP2386ACPZN-R7 | Digi-Key | ADP2386ACPZN-R7DKR-ND | IC REG BUCK ADJ 6A SYNC 24LFCSP, Buck Switching Regulator IC Positive Adjustable 0.6V 1 Output 6A 24-WFQFN Exposed Pad, CSP
66 | AP7361-FGE | 4 | IC66, IC67, IC70, IC71 | AP7361 | Diodes Incorporated | AP7361-FGE-7 | Digi-Key | AP7361-FGE-7DICT-ND | IC REG LDO ADJ 1A 8DFN
67 | AS431 | 1 | IC69 | SOT23-3_v2 | Diodes | AS431ANTR-G1 | Digi-Key | AS431ANTR-G1DICT-ND | Shunt Voltage Reference IC Adjustable 2.5V 36 VV ±0.5% 100 mA SOT-23-3
68 | LTC5587 | 2 | IC72, IC73 | LTC5587_DFN12 | Linear Technology/Analog Devices | LTC5587IDD#TRPBF | Digi-Key | LTC5587IDD#TRPBFTR-ND | RF Detector IC CDMA, GSM, EDGE, W-CDMA 10MHz ~ 6GHz -34dBm ~ 6dBm ±1dB 12-WFDFN Exposed Pad
69 | AG5712-LPB | 1 | IC74 | AG5712-LPB_PoE_PD_module | Silvertel | AG5712-LPB | Digikey | 5061-AG5712-LPB-ND | Isolated PoE Module DC DC Converter 1 Output 12V 2.5A 40V - 57V Input
70 | IRF9358TRPBF | 1 | IC75 | IRF9358TRPBF_DUAL_NMOS_SOIC8 | International Rectifier | IRF9358TRPBF | Digi-Key | IRF9358TRPBFDKR-ND | Mosfet Array 2 P-Channel (Dual) 30V 9.2A 2W Surface Mount 8-SO
71 | CYPD3177-24LQXQT | 1 | IC76 | USB_POWER_DISTR_CYPD3177_QFN24 | Cypress | CYPD3177-24LQXQT | Digi-Key | 428-CYPD3177-24LQXQTCT-ND | 428-CYPD3177-24LQXQTCT-ND
72 | DF40C-100DS-0.4V(51) | 2 | J1, J2 | FP-DF40C-100DS-0.4V(51) | Amphenol ICC / FCI | 10164227-1001A1RLF | Mouser | 649-01642271001A1RLF | 100 Position Connector Receptacle, Center Strip Contacts Surface Mount Gold
73 | 1775862-2 | 1 | J3 | MiniPCIe_connector_XTRX_v2 | JAE Electronics | MM60-52B1-G1-R850 | Digi-Key | 670-2516-1-ND | 52 Position Female Connector PCI Express Mini Card Gold 0.031" (0.80mm) | Additionally a required number of thermal pads (P/N 40016010) per batch of boards, rounding this number to whole pad pieces, have to be ordered (included in BOM Additional Info column). The thermal pad with a size of 100 mm x 100 mm is to be cut in 20 mm x 20 mm pieces (resulting in a possible total of 25 pcs. from a single whole pad). A single assembled PCB requires 1 pcs. of 20 mm x 20 mm pad per 1 board. Calculate the number of whole thermal pad (P/N 40016010) pieces based on the assembled board batch size, rounding this number to whole pad pieces. Example: 5 pcs. PCB batch requires 1 pcs. of thermal pad (P/N 40016010) with leftovers. 300 pcs. PCB batch requires 12 pcs. of thermal pads (P/N 40016010) without leftovers.
74 | nano SIM (push-push) | 1 | J4 | nano_SIM_SIM8066-6-1-14-01-A | Global Connector Technology | SIM8066-6-1-14-01-A | Farnell | 3772948 | 7 (6 + 1) Position Card Connector NANO SIM Surface Mount, Right Angle Gold
75 | Micro SD card holder | 1 | J7 | MICRO_SD_CARD_114-00841-68_v2 | Amphenol Commercial Products | 114-00841-68 | Digi-Key | 114-00841-68-1-ND | 10 (8 + 2) Position Card Connector Secure Digital - microSD™ Surface Mount, Right Angle Gold
76 | Header 5X1 | 1 | J8 | Header1x5_TH_LOCKING | Molex | 22112052 | Digi-Key | WM2703-ND | Connector Header Through Hole 5 position 0.100" (2.54mm)
77 | Ethernet with magnetics | 1 | J9 | RJ45_ETHERNET_MAG_A70-112-331N126 | Link-PP | LPJG0926HENL | Link-PP | LPJG0926HENL | A70-112-331N126 Tab Down Ethernet Magnetic RJ45 Connector LPJG0926HENL With POE +
78 | Header 10X2 | 1 | J10 | HEADER10X2_TH_LOCK | On-Shore Technology | 302-S201 | Digi-Key | ED10524-ND | Connector Header Through Hole 20 position 0.100" (2.54mm)
79 | Header 7X2 | 1 | J12 | Header7x2_TH | Adam Equipment | PH2-14-UA | Digi-Key | 2057-PH2-14-UA-ND | Connector Header Through Hole 14 position 0.100" (2.54mm)
80 | A/V, 3.5mm | 1 | J14 | Audio_jack_3.5mm | CUI Inc. | SJ-43515TS | Digi-Key | CP-43515TS-ND | CONN JACK 4COND 3.5MM R/A
81 | FPC 15-pin | 2 | J15, J16 | FPC_CONNECTOR_15pin_1-1734248-5 | TE Connectivity | 1-1734248-5 | Digi-Key | A101418DKR-ND | 15 Position FPC Connector Contacts, Vertical, 1 Sided 0.039" (1.00mm) Surface Mount
82 | SMA panel mount | 8 | J21, J24, J36, J38, J42, J43, J46, J47 | SMA_connector_side | Linx | CONSMA002-L-G | Digi-Key | CONSMA002-L-G-ND | SMA Connector Receptacle, Female Socket 50Ohm Panel Mount, Through Hole, Right Angle Solder
83 | U.FL/MMCX | 7 | J22, J37, J39, J44, J45, J48, J49 | MMCX_UFL_conn_u | Molex, LLC | 734120110 | Digi-Key | WM5587CT-ND | CONN UMC RCPT STR 50 OHM SMD
84 | 4 pin FAN header | 1 | J26 | Header1x4_TH_LOCKING_v2 | Molex | 47053-1000 | Digi-Key | WM4330-ND | Connector Header Through Hole 4 position 0.100" (2.54mm)
85 | Header 2X1 | 3 | J27, J51, J52 | Header1x2_TH_LOCKING | Molex | 22-11-2026 | Digi-Key | WM19460-ND | Connector Header Through Hole 2 position 0.100" (2.54mm)
86 | USB type C connector | 1 | J29 | DUAL_USB-C_632723100011 | Wurth Electronics | 632723100011 | Digi-Key | 732-9617-1-ND | USB - C (Type - C) USB 3.1 (USB 3.1 Gen 2, Superspeed+) Receptacle Connector 24 Position Surface Mount, Right Angle; Through Hole
87 | Header 10X2 | 1 | J31 | Header10x2_TH_2MM | Amphenol | G823J201240BHR | Digikey | 664-G823J201240BHR-ND | Connector Header Through Hole 19 position 0.079" (2.00mm)
88 | 48406-0003 | 1 | J33 | Dual_USB_48406-0003_Molex | Molex | 484060003 | Mouser | 538-48406-0003 | USB Connectors USB 3.0 F/A STD RA REC STACKED 15u'
89 | Micro HDMI | 2 | J34, J35 | MICRO_HDMI_Wurth_685119248123 | Wurth Electronics | 685119248123 | RSComponents | 1621823 | HDMI - Micro - Receptacle Connector 19 Position Surface Mount, Right Angle; Through Hole
90 | CONN_PWR_JACK_2.1x5.5mm | 1 | J50 | CONN_PWR_JACK_v2 | CUI Devices | PJ002A | Digikey | CP-002A-ND | Power Barrel Connector Jack 2.00mm ID (0.079"), 5.50mm OD (0.217") Through Hole, Right Angle
91 | Scap | 1 | J53 | 874370443_1P5_SMD_HEADER | Molex | 874370443 | Digi-Key | WM7664CT-ND | Connector Header Surface Mount 4 position 0.059" (1.50mm)
92 | Header 2X1 | 1 | J55 | HDR_1x2 | 3M | 961102-6404-AR | Digi-Key | 3M9447-ND | 2 Positions Header, Unshrouded Connector 0.100" (2.54mm) Through Hole Gold
93 | 1 pcs. | 1 | JMP2 |  | Sullins | SPC02SYAN | Digi-Key | S9001-ND | 2 (1 x 2) Position Shunt Connector Black Closed Top 0.100" (2.54mm) Gold
94 | 47nH | 1 | L1 | RES0402 | COILCRAFT | 0402HP-47NXJLU | Farnell | 2285856 | INDUCTOR, RF, 47NH, 5%, 2.4GHZ, SMD; Product Range:0402HP Series; Inductance:47nH; Inductance Tolerance:± 5%; High Frequency Inductor Case:0402 [1005 Metric]; Self Resonant Frequency Min:2.4GHz; DC Resistance Max:0.58ohm; DC Current Rating:420mA
95 | 220nH, 2% | 2 | L2, L3 | RES0603 | Murata | LQW18ANR22G80D | Digikey | 490-16902-1-ND | 220 nH Unshielded Drum Core, Wirewound Inductor 280 mA 2.08Ohm Max 0603 (1608 Metric)
96 | 22nH, 2% | 4 | L4, L5, L6, L7 | RES0603 | Murata | LQW18AN22NG00D | Digi-Key | 490-6874-1-ND | Fixed Inductors 22 NH 2%
97 | 1uH, 3.2A | 2 | L8, L13 | NRS4018T3R3MDGJ_inductor | Taiyo Yuden | NRS4018T1R0NDGJ | Digi-Key | 587-2888-1-ND | 1 µH Shielded Drum Core, Wirewound Inductor 3.2 A 32.4mOhm Max Nonstandard
98 | 2.2µH | 1 | L9 | FDVE1040_TOKO_INDUCTOR | Vishay Dale | IHLP4040DZER2R2M01 | Digi-Key | 541-1299-1-ND | 2.2µH Shielded Molded Inductor 12A 9 mOhm Max Nonstandard
99 | 3.3µH | 1 | L10 | FDVE1040_TOKO_INDUCTOR | Vishay Dale | IHLP4040DZER3R3M01 | Digi-Key | 541-1298-1-ND | 3.3µH Shielded Molded Inductor 10A 14.4 mOhm Max Nonstandard
100 | 0R | 47 | L11, L12, R3, R6, R8, R20, R43, R89, R98, R102, R103, R105, R106, R111, R112, R113, R115, R118, R119, R127, R130, R132, R136, R138, R140, R145, R157, R160, R165, R169, R176, R177, R178, R194, R199, R218, R219, R228, R242, R247, R249, R252, R257, R260, R311, R348, R349 | RES0402 | Yageo | RC0402JR-070RL | Digi-Key | 311-0.0JRTR-ND | RES SMD 0.0OHM JUMPER 1/16W 0402
101 | LED_RG_SMD | 7 | LED1, LED2, LED3, LED4, LED5, LED6, LED7 | LED-2x0603 | Avago Technologies US Inc. | HSMF-C165 | Digi-Key | 516-1419-1-ND | LED GREEN/RED DIFFUSED 0603 SMD
102 | Screw (M2, 5mm) | 6 | MECH1, MECH3, MECH5, MECH7, MECH9, MECH11 |  | B&F Fastener | MPMS0020005PH | Digi-Key | H738-ND | M2x0.4 Pan Head Machine Screw Phillips Drive
103 | SMD spacer (M2, 1.5mm) | 6 | MECH2, MECH4, MECH6, MECH8, MECH10, MECH12 | 9774015243R_SMT_M2_STANDOFF_SPACER | Wurth Electronics | 9774015243R | Digi-Key | 732-7069-1-ND | RND STANDOFF M2X0.4 STEEL 1.5MM
104 | Light pipe | 6 | MECH13, MECH14, MECH15, MECH16, MECH17, MECH18 | LIGHT_PIPE_RIGHT_ANGLE_SLP3-200-100-F | Bivar | SLP3-150-100-F | Digikey | 492-1510-ND | Light Pipe Single Clear Rigid Board Mount, Press Fit, Right Angle
105 | # pcs. | 4 | MECH19, MECH20, MECH21, MECH22 | PCB_standoff | FIX&FASTEN | FIX-MAE-5TV | TME | FIX-MAE-5TV | PCB distance; polyamide; L:5mm; Colour: natural; Øcutout:3mm
106 | 2-pin header | 1 | MECH23 |  | Molex | 22-01-2027 | Newark | 47T5763 | 2 Rectangular Connectors - Housings Receptacle White 0.100" (2.54mm)
107 | Crimp | 2 | MECH24, MECH25 |  | Molex | 08-50-0032 | Mouser | 538-08-50-0032 | Non-Gendered Contact Tin 22-30 AWG Crimp
108 | Screw (M3, 20 mm) | 3 | MECH26, MECH27, MECH28 |  | TR Fastenings | M3 20 KRSTMC Z100 | Farnell | 1420401 | Machine Screw, M3, 20 mm, Steel, Bright Zinc, Flat / Countersunk Head Pozidriv, Pack of 100 | Buy packs of 100 pcs. by dividing the required amount by 100 and rounding the resulting number to whole packs.
109 | Spacer (M3, 12mm) | 3 | MECH29, MECH30, MECH31 |  | ETTINGER | 005.03.123 | Farnell | 1466772 | Standoff, Brass, M3, Hex Female, 12 mm, 12 mm
110 | Screw (M3, 6 mm) | 3 | MECH32, MECH33, MECH34 |  | TR Fastenings | M3 6 PRSTMC Z100 | Farnell | 1419986 | Machine Screw, M3, 6 mm, Steel 4.8, Bright Zinc, Pan Head Pozidriv | Buy packs of 100 pcs. by dividing the required amount by 100 and rounding the resulting number to whole packs.
111 | RF SHIELD FRAME | 4 | MECH35, MECH36, MECH37, MECH38 | RF_SHIELD_FRAME_16P5x16P5_2118716-2_v1 | TE Connectivity | 2118716-2 | Digi-Key | A126152CT-ND | RF Shield Frame 0.650" (16.50mm) X 0.650" (16.50mm) Surface Mount
112 | RF SHIELD COVER | 4 | MECH39, MECH40, MECH41, MECH42 | RF_SHIELD_COVER_16Px916P9_2118715-2 | TE Connectivity | 2118715-2 | Digi-Key | A126120-ND | RF Shield Cover 0.665" (16.90mm) X 0.665" (16.90mm) Vented Surface Mount
113 | 0R | 8 | R2, R29, R50, R55, R69, R175, R197, R217 | RES0402_v2 | Yageo | RC0402JR-070RL | Digi-Key | 311-0.0JRTR-ND | RES SMD 0.0OHM JUMPER 1/16W 0402
114 | 100k, 1% | 8 | R14, R90, R285, R286, R287, R288, R300, R307 | RES0402 | Vishay | CRCW0402100KFKEDC | Digi-Key | 541-3960-6-ND | 100 kOhms ±1% 0.063W, 1/16W Chip Resistor 0402 (1005 Metric) Thick Film
115 | 10k, 1% | 39 | R15, R23, R25, R28, R42, R49, R56, R57, R58, R59, R60, R61, R73, R82, R94, R109, R120, R121, R128, R129, R131, R134, R141, R143, R147, R162, R171, R173, R205, R206, R254, R289, R290, R291, R292, R298, R331, R346, R350 | RES0402 | Yageo | RC0402FR-0710KL | Digi-Key | 311-10.0KLRTR-ND | RES SMD 10K OHM 1% 1/16W 0402
116 | 2k2, 1% | 10 | R16, R19, R37, R39, R45, R46, R149, R150, R250, R339 | RES0402 | Stackpole Electronics Inc | RMCF0402FT2K20 | Digi-Key | RMCF0402FT2K20CT-ND | RES SMD 2.2K OHM 1% 1/16W 0402
117 | 470R, 1% | 11 | R26, R31, R32, R159, R168, R174, R201, R293, R294, R295, R296 | RES0402 | Yageo | RC0402FR-07470RL | Digi-Key | 311-470LRCT-ND | 470 Ohms ±1% 0.063W, 1/16W Chip Resistor 0402 (1005 Metric) Moisture Resistant Thick Film
118 | 1k, 1% | 9 | R33, R44, R74, R78, R193, R200, R319, R332, R338 | RES0402 | Stackpole Electronics Inc | RMCF0402FT1K00 | Digi-Key | RMCF0402FT1K00TR-ND | RES SMD 1K OHM 1% 1/16W 0402
119 | 220R, 1% | 2 | R35, R40 | RES0402 | Yageo | RC0402FR-07220RL | Digi-Key | 311-220LRCT-ND | 220 Ohms ±1% 0.063W, 1/16W Chip Resistor 0402 (1005 Metric) Moisture Resistant Thick Film
120 | 100R, 1% | 3 | R36, R38, R328 | RES0402 | Stackpole Electronics Inc. | RMCF0402FT100R | Digi-Key | RMCF0402FT100RDKR-ND | RES SMD 100 OHM 1% 1/16W 0402
121 | 22k, 1% | 2 | R48, R303 | RES0402 | Yageo | RC0402FR-0722KL | Digi-Key | 311-22.0KLRCT-ND | RES SMD 22K OHM 1% 1/16W 0402
122 | 1.6k, 1% | 8 | R63, R64, R65, R66, R67, R68, R312, R320 | RES0402 | Yageo | RC0402FR-071K6L | Digi-Key | YAG3045CT-ND | 1.6 kOhms ±1% 0.063W, 1/16W Chip Resistor 0402 (1005 Metric) Moisture Resistant Thick Film
123 | 330R, 1% | 16 | R71, R72, R75, R77, R79, R81, R85, R88, R91, R95, R99, R104, R107, R110, R207, R310 | RES0402 | Yageo | RC0402FR-07330RL | Digi-Key | 311-330LRCT-ND | 330 Ohms ±1% 0.063W, 1/16W Chip Resistor 0402 (1005 Metric) Moisture Resistant Thick Film
124 | 12k, 1% | 2 | R80, R133 | RES0402 | Samsung Electro-Mechanics | RC1005F123CS | Digi-Key | 1276-4122-1-ND | 12 kOhms ±1% 0.063W, 1/16W Chip Resistor 0402 (1005 Metric) Moisture Resistant Thick Film
125 | 470k, 1% | 2 | R100, R101 | RES0402 | TE Connectivity | CRGCQ0402F470K | Digi-Key | A129659CT-ND | 470 kOhms ±1% 0.063W, 1/16W Chip Resistor 0402 (1005 Metric) Automotive AEC-Q200, Moisture Resistant Thick Film
126 | 100R, 1% | 1 | R123 | RES0603 | Stackpole Electronics Inc. | RMCF0402FT100R | Digi-Key | RMCF0402FT100RDKR-ND | RES SMD 100 OHM 1% 1/16W 0402
127 | 1M, 1% | 1 | R135 | RES0402 | Yageo | RC0402FR-071ML | Digi-Key | 311-1.00MLRCT-ND | 1 MOhms ±1% 0.063W, 1/16W Chip Resistor 0402 (1005 Metric) Moisture Resistant Thick Film
128 | 49.9R, 1% | 12 | R179, R195, R203, R209, R211, R212, R214, R215, R216, R220, R265, R266 | RES0402 | Samsung Electro-Mechanics America, Inc. | RC1005F49R9CS | Digi-Key | 1276-3469-6-ND | RES SMD 49.9 OHM 1% 1/16W 0402
129 | 10R, 1% | 2 | R196, R243 | RES0402 | Stackpole Electronics | RMCF0402FT10R0 | Digi-Key | RMCF0402FT10R0CT-ND | 10 Ohms ±1% 0.063W, 1/16W Chip Resistor 0402 (1005 Metric) Automotive AEC-Q200 Thick Film
130 | 2.21k, 1% | 1 | R301 | RES0402 | Stackpole Electronics Inc. | RMCF0402FT2K21 | Digi-Key | RMCF0402FT2K21CT-ND | RES SMD 2.21K OHM 1% 1/16W 0402
131 | 44.2k, 1% | 3 | R302, R309, R333 | RES0402 | Panasonic Electronic Components | ERJ-2RKF4422X | Digi-Key | P44.2KLCT-ND | RES SMD 44.2K OHM 1% 1/10W 0402
132 | 100R, 1% | 1 | R306 | RES0805 | Yageo | RC0805FR-07100RL | Digi-Key | 311-100CRCT-ND | 100 Ohms ±1% 0.125W, 1/8W Chip Resistor 0805 (2012 Metric) Moisture Resistant Thick Film
133 | 3k, 1% | 1 | R308 | RES0402 | Vishay Dale | CRCW04023K00FKED | Digi-Key | 541-3.00KLCT-ND | RES SMD 3K OHM 1% 1/16W 0402
134 | 1.2k, 1% | 2 | R313, R321 | RES0402 | Yageo | RC0402FR-071K2L | Digi-Key | 311-1.20KLRCT-ND | 1.2 kOhms ±1% 0.063W, 1/16W Chip Resistor 0402 (1005 Metric) Moisture Resistant Thick Film
135 | 510R, 1% | 2 | R316, R322 | RES0402 | Yageo | RC0402FR-07510RL | Digi-Key | 311-510LRCT-ND | 510 Ohms ±1% 0.063W, 1/16W Chip Resistor 0402 (1005 Metric) Moisture Resistant Thick Film
136 | 2.4k, 1% | 4 | R318, R340, R341, R342 | RES0402 | Yageo | RC0402FR-072K4L | Digi-Key | 311-2.40KLRCT-ND | 2.4 kOhms ±1% 0.063W, 1/16W Chip Resistor 0402 (1005 Metric) Moisture Resistant Thick Film
137 | 68R, 1% | 2 | R323, R324 | RES0402 | Yageo | RC0402FR-0768RL | Digi-Key | 311-68.0LRCT-ND | 68 Ohms ±1% 0.063W, 1/16W Chip Resistor 0402 (1005 Metric) Moisture Resistant Thick Film
138 | 5.1k, 5% | 4 | R334, R335, R336, R337 | RES0402 | Yageo | RC0402JR-075K1L | Digi-Key | 311-5.1KJRCT-ND | RES 5.1K OHM 5% 1/16W 0402
139 | TESTPOINT_THT_MINI | 4 | TP5, TP6, TP7, TP8 | TP-SMD-LOW_PROFILE | Harwin Inc | S1751-46R | Digi-Key | 952-1478-2-ND | Natural PC Test Point 0.128" x 0.065" x 0.079" (3.25mm x 1.65mm x 2.00mm) Brass, Tin Plating Surface Mount Mounting Type
140 | TVS | 16 | VD1, VD2, VD3, VD4, VD5, VD6, VD7, VD8, VD10, VD11, VD12, VD13, VD14, VD15, VD16, VD17 | SOD323 | Sangdest Microelectronics | SD03LCC | Digi-Key | 1655-SD03LCCCT-ND | 19V Clamp 20A (8/20µs) Ipp Tvs Diode Surface Mount SOD-323
141 | SK36A | 4 | VD18, VD19, VD20, VD22 | SK32A-L_DIODE_DO-214AC | Micro Commercial Co | SK36A-LTP | Digi-Key | SK36A-LTPMSCT-ND | DIODE SCHOTTKY 60V 3A DO214AC
142 | SMAJ58A | 1 | VD23 | SMAJ58A_shottky_diode | Diodes Incorporated | SMAJ58A-13-F | Digi-Key | SMAJ58A-13-FDICT-ND | TVS DIODE 58V 93.6V SMA
143 | IRLML6244 | 2 | VT1, VT2 | SOT23-3 | Infineon Technologies | IRLML6244TRPBF | Digi-Key | IRLML6244TRPBFTR-ND | N-Channel 20V 6.3A (Ta) 1.3W (Ta) Surface Mount Micro3™/SOT-23
144 | U7475LF 30.72MHz | 1 | XO1 | AOCJYR-10.000MHz | Rakon | U7475LF 30.72MHz | Rakon | U7475LF | ROM9070SA 30.72MHz MERC+ 9x7 HOT RC2.5 3.3V PULL
145 | U8073LF 10.0MHz | 1 | XO6 | AOCJYR-10.000MHz | Rakon | U8073LF | Rakon | U8073LF | ROM9070PA 10.0MHz MERC+ 9x7 HOT CMOS 3.3V PULL
146 | 32.768kHz | 1 | XT1 | CRYSTAL_2PIN_RTC_RT3215 | Raltron Electronics | RT3215-32.768-12.5-TR-10PPM | Digi-Key | 2151-RT3215-32.768-12.5-TR-10PPMTR-ND | 32.768 kHz ±10ppm Crystal 12.5pF 70 kOhms 2-SMD, No Lead
147 | 24MHz | 1 | XT2 | CRYSTAL_4-LCC | Abracon | ABM8-24.000MHZ-D1G-T | Digi-Key | 535-14395-1-ND | 24 MHz ±10ppm Crystal 18pF 50 Ohms 4-SMD, No Lead
