myriadrf/LimePSB-RPCM/hardware/1v3/LimePSB-RPCM_1v3_DB_DFMr2/BOM/LimePSB-RPCM_1v3_BOMr2.xls

Item # | Comment | Quantity | Designator | Footprint | Manufacturer | Manufacturer Part Number 1 | Supplier 1 | Supplier Part Number 1 | Part Description | Assembly Info | Number of NF parts in row | Number of fitted parts in row | Fitted parts in row with NF parts
1 | PS2801-1-A | 1 | AT1 | TCMT1107CT_optoisolator | Renesas | PS2801-1-A | Mouser | 968-PS2801-1-A | Transistor Output Optocouplers OPTOCOUPLER 4-PIN SSOP |  |  | 1
2 | CR1220 Battery Holder | 1 | BATT1 | CR1220_SMD_holder | MPD (Memory Protection Devices) | BC501SM | Digi-Key | BC501SM-ND | HOLDER COIN CELL FOR CR1220 SMD |  |  | 1
3 | CR1220 Battery | 1 | BATT2 |  | Panasonic - BSG | CR1220 | Digi-Key | P033-ND | Lithium Battery Non-Rechargeable (Primary) 3V Coin, 12.5mm | NF(BATT2) | 1 | 0
4 | KMB210S | 2 | BR1, BR2 | KMB210S_RECTIFIER_BRIDGE | SMC Diode Solutions | KMB210S | Digi-Key | 1655-KMB210SCT-ND | Bridge Rectifier Single Phase Schottky 100 V Surface Mount MBS |  |  | 2
5 | Switch tactile right edge | 1 | BTN1 | SW_TACTILE_RIGHT_EDGE | TE Connectivity ALCOSWITCH Switches | 1825027-5 | Digi-Key | 450-1662-ND | Tactile Switch SPST-NO Side Actuated Through Hole, Right Angle |  |  | 1
6 | WST-1203UX | 1 | BZ1 | BUZZER_WST-1203UX | Soberton Inc. | WST-1203UX | Digi-Key | 433-1047-ND | Buzzers Indicator, Internally Driven Magnetic 3V 30mA 2.3kHz 82dB @ 3V, 10cm Through Hole PC Pins |  |  | 1
7 | 100nF, 16V | 129 | C1, C2, C9, C10, C11, C13, C14, C15, C17, C18, C19, C20, C21, C23, C24, C27, C29, C31, C32, C33, C35, C36, C37, C38, C39, C40, C41, C42, C43, C44, C45, C46, C47, C48, C49, C50, C51, C52, C54, C56, C58, C60, C61, C63, C65, C67, C70, C71, C75, C77, C78, C79, C80, C81, C82, C84, C85, C88, C90, C93, C95, C97, C98, C99, C100, C101, C102, C103, C104, C105, C106, C107, C108, C109, C112, C113, C114, C115, C118, C122, C125, C130, C131, C134, C135, C141, C143, C147, C149, C153, C159, C160, C163, C164, C165, C166, C169, C173, C176, C181, C182, C185, C186, C191, C192, C193, C194, C195, C196, C202, C204, C224, C226, C240, C241, C242, C243, C244, C245, C246, C247, C250, C251, C275, C276, C279, C291, C299, C300 | CAP0402 | Murata Electronics | GRM155R71C104KA88D | Mouser | 81-GRM155R71C104KA88 | 0.10µF ±10% 16V Ceramic Capacitor X7R 0402 (1005 Metric), 0.10µF ±10% 16V Ceramic Capacitor X7R 0402 (1005 Metric), 0.10µF ±10% 16V Ceramic Capacitor X7R 0402 (1005 Metric), 0.10µF ±10% 16V Ceramic Capacitor X7R 0402 (1005 Metric), 0.10µF ±10% 16V Ceramic Capacitor X7R 0402 (1005 Metric), 0.10µF ±10% 16V Ceramic Capacitor X7R 0402 (1005 Metric), 0.10µF ±10% 16V Ceramic Capacitor X7R 0402 (1005 Metric), 0.10µF ±10% 16V Ceramic Capacitor X7R 0402 (1005 Metric), 0.10µF ±10% 16V Ceramic Capacitor X7R 0402 (1005 Metric), 0.10µF ±10% 16V Ceramic Capacitor X7R 0402 (1005 Metric), 0.10µF ±10% 16V Ceramic Capacitor X7R 0402 (1005 Metric), 0.10µF ±10% 16V Ceramic Capacitor X7R 0402 (1005 Metric), 0.10µF ±10% 16V Ceramic Capacitor X7R 0402 (1005 Metric), 0.10µF ±10% 16V Ceramic Capacitor X7R 0402 (1005 Metric), 0.10µF ±10% 16V Ceramic Capacitor X7R 0402 (1005 Metric), 0.10µF ±10% 16V Ceramic Capacitor X7R 0402 (1005 Metric), 0.10µF ±10% 16V Ceramic Capacitor X7R 0402 (1005 Metric), 0.10µF ±10% 16V Ceramic Capacitor X7R 0402 (1005 Metric), 0.10µF ±10% 16V Ceramic Capacitor X7R 0402 (1005 Metric), 0.10µF ±10% 16V Ceramic Capacitor X7R 0402 (1005 Metric), 0.10µF ±10% 16V Ceramic Capacitor X7R 0402 (1005 Metric), 0.10µF ±10% 16V Ceramic Capacitor X7R 0402 (1005 Metric), 0.10µF ±10% 16V Ceramic Capacitor X7R 0402 (1005 Metric), 0.10µF ±10% 16V Ceramic Capacitor X7R 0402 (1005 Metric), 0.10µF ±10% 16V Ceramic Capacitor X7R 0402 (1005 Metric), 0.10µF ±10% 16V Ceramic Capacitor X7R 0402 (1005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 | NF(C18 C29 C31 C90 C95 C100 C115 C122 C130 C131 C143 C153 C159 C166 C173 C181 C182 C185 C186 C191 C193 C244 C245 C246 C247 C300) | 26 | 103 | C1 C2 C9 C10 C11 C13 C14 C15 C17 C19 C20 C21 C23 C24 C27 C32 C33 C35 C36 C37 C38 C39 C40 C41 C42 C43 C44 C45 C46 C47 C48 C49 C50 C51 C52 C54 C56 C58 C60 C61 C63 C65 C67 C70 C71 C75 C77 C78 C79 C80 C81 C82 C84 C85 C88 C93 C97 C98 C99 C101 C102 C103 C104 C105 C106 C107 C108 C109 C112 C113 C114 C118 C125 C134 C135 C141 C147 C149 C160 C163 C164 C165 C169 C176 C192 C194 C195 C196 C202 C204 C224 C226 C240 C241 C242 C243 C250 C251 C275 C276 C279 C291 C299
8 | 1uF, 10V | 42 | C3, C16, C26, C30, C34, C68, C69, C74, C76, C83, C87, C92, C96, C116, C117, C121, C124, C132, C133, C140, C152, C167, C168, C172, C175, C183, C184, C188, C200, C201, C220, C221, C236, C237, C238, C239, C248, C249, C273, C274, C287, C296 | CAP0402 | Yageo | CC0402MRX5R6BB105 | Digi-Key | 311-1732-1-ND | 1µF 10V Ceramic Capacitor X5R 0402 (1005 Metric) 0.039" L x 0.020" W (1.00mm x 0.50mm) | NF(C30 C116 C121 C132 C133 C152 C167 C172 C183 C184) | 10 | 32 | C3 C16 C26 C34 C68 C69 C74 C76 C83 C87 C92 C96 C117 C124 C140 C168 C175 C188 C200 C201 C220 C221 C236 C237 C238 C239 C248 C249 C273 C274 C287 C296
9 | 47uF, 10V | 10 | C4, C5, C6, C7, C22, C25, C86, C89, C91, C94 | CAP1206 | TDK Corporation | C3216X6S1A476M160AC | Digi-Key | 445-6010-1-ND | 47µF ±20% 10V Ceramic Capacitor X6S 1206 (3216 Metric) | NF(C6 C7) | 2 | 8 | C4 C5 C22 C25 C86 C89 C91 C94
10 | 22pF, 50V | 8 | C8, C72, C73, C154, C155, C156, C158, C187 | CAP0402 | Yageo | CC0402JRNPO9BN220 | Digi-Key | 311-1018-2-ND | 22pF ±5% 50V C0G, NP0 Ceramic Capacitor -55°C ~ 125°C Surface Mount, MLCC 0402 (1005 Metric) 0.039" L x 0.020" W (1.00mm x 0.50mm) | NF(C8) | 1 | 7 | C72 C73 C154 C155 C156 C158 C187
11 | 10uF, 16V | 3 | C12, C110, C161 | CAP0603 | Yageo | GRM188R61C106MA73D | Digi-Key | 490-7201-2-ND | 10µF ±20% 16V Ceramic Capacitor X5R 0603 (1608 Metric) |  |  | 3
12 | 4.7uF, 6.3V | 20 | C28, C53, C55, C57, C59, C62, C64, C66, C301, C302, C303, C304, C305, C306, C307, C308, C309, C310, C311, C312 | CAP0402 | Murata Electronics North America | GRM155R60J475ME87D | Digi-Key | 490-5408-1-ND | 4.7µF ±20% 6.3V X5R Ceramic Capacitor -55°C ~ 85°C Surface Mount, MLCC 0402 (1005 Metric) 0.039" L x 0.020" W (1.00mm x 0.50mm) | NF(C303 C312) | 2 | 18 | C28 C53 C55 C57 C59 C62 C64 C66 C301 C302 C304 C305 C306 C307 C308 C309 C310 C311
13 | 100pF, 50V | 46 | C111, C119, C120, C126, C127, C128, C129, C136, C137, C138, C139, C142, C144, C145, C146, C162, C170, C171, C177, C178, C179, C180, C190, C197, C203, C205, C206, C208, C210, C211, C212, C213, C214, C215, C216, C217, C225, C227, C228, C229, C230, C231, C232, C233, C234, C235 | CAP0402 | Yageo | CC0402JRNPO9BN101 | Digi-Key | 311-1024-1-ND | 100pF ±5% 50V C0G, NP0 Ceramic Capacitor -55°C ~ 125°C Surface Mount, MLCC 0402 (1005 Metric) 0.039" L x 0.020" W (1.00mm x 0.50mm) |  |  | 46
14 | 18nF, 16V | 2 | C123, C174 | CAP0402 | Yageo | CC0402KRX7R7BB183 | Digi-Key | 311-1706-1-ND | 0.018µF ±10% 16V Ceramic Capacitor X7R 0402 (1005 Metric) | NF(C123 C174) | 2 | 0
15 | 1nF, 50V | 3 | C148, C150, C151 | CAP0402 | Murata Electronics North America | GCM155R71H102KA37D | Digi-Key | 490-4761-1-ND | 1000pF ±10% 50V Ceramic Capacitor X7R 0402 (1005 Metric) |  |  | 3
16 | 220pF, 10% | 1 | C157 | CAP0402 | Yageo | CC0402KRX7R9BB221 | Digi-Key | 311-1035-2-ND | 220pF ±10% 50V X7R Ceramic Capacitor -55°C ~ 125°C Surface Mount, MLCC 0402 (1005 Metric) 0.039" L x 0.020" W (1.00mm x 0.50mm) |  |  | 1
17 | 10uF, 6.3V | 1 | C189 | CAP0603 | Yageo | CC0603MRX5R5BB106 | Digi-Key | 311-1448-2-ND | 10µF ±20% 6.3V X5R Ceramic Capacitor -55°C ~ 85°C Surface Mount, MLCC 0603 (1608 Metric) 0.063" L x 0.031" W (1.60mm x 0.80mm) |  |  | 1
18 | 470nF, 16V | 4 | C198, C199, C218, C219 | CAP0805_FEEDTHROUGH | Murata | NFM21PC474R1C3D | Digi-Key | 490-2537-1-ND | 0.47µF Feed Through Capacitor 16V 2A 30mOhm 0805 (2012 Metric), 3 PC Pad |  |  | 4
19 | 10nF, 50V | 5 | C207, C209, C222, C223, C265 | CAP0402 | Murata Electronics North America | GRM155R71H103KA88D | Digi-Key | 490-4516-2-ND | 10000pF ±10% 50V Ceramic Capacitor X7R 0402 (1005 Metric) |  |  | 5
20 | 100nF, 100V | 2 | C252, C254 | CAP0603 | Murata Electronics North America | GRM188R72A104KA35D | Digi-Key | 490-3285-1-ND | 0.1µF ±10% 100V Ceramic Capacitor X7R 0603 (1608 Metric) |  |  | 2
21 | 100uF, 63V | 1 | C253 | CAP_POL_D10_H10 | KEMET | EEV107M063A9PAA | Digi-Key | 399-6702-1-ND | 100 µF 63 V Aluminum Electrolytic Capacitors Radial, Can - SMD 2000 Hrs @ 105°C |  |  | 1
22 | 1nF, 100V | 1 | C255 | CAP0603 | KEMET | C0603C102K1RACTU | Digi-Key | 399-7831-2-ND | 1000pF ±10% 100V Ceramic Capacitor X7R 0603 (1608 Metric) |  |  | 1
23 | 2.2uF, 100V | 1 | C256 | CAP1206 | TDK Corporation | C3216X7S2A225K160AE | Digi-Key | 445-8900-1-ND | 2.2µF ±10% 100V Ceramic Capacitor X7S 1206 (3216 Metric) |  |  | 1
24 | 10uF, 25V | 5 | C257, C259, C280, C284, C292 | CAP0805 | Murata | GRM21BR61E106KA73K | Digi-Key | 490-16824-1-ND | CAP CER 10UF 25V X5R 0805 | NF(C257) | 1 | 4 | C259 C280 C284 C292
25 | 22nF, 50V | 5 | C258, C260, C285, C286, C290 | CAP0402 | Kemet | C0402C223K5RACTU | Digi-Key | 399-7780-1-ND | 0.022µF ±10% 50V X7R Ceramic Capacitor -55°C ~ 125°C Surface Mount, MLCC 0402 (1005 Metric) 0.039" L x 0.020" W (1.00mm x 0.50mm) |  |  | 5
26 | 100uF, 16V | 2 | C261, C262 | CAP_POL_SIZE_F_v2 | Wurth Electronics | 875105344010 | Digi-Key | 732-6425-1-ND | 100 µF 16 V Aluminum - Polymer Capacitors Radial, Can - SMD 20mOhm 2000 Hrs @ 105°C | NF(C262) | 1 | 1 | C261
27 | 470pF, 200V | 1 | C263 | CAP0603 | Walsin Technologies | 0603B471K201CT | Mouser | 791-0603B471K201CT | Multilayer Ceramic Capacitors MLCC - SMD/SMT 470pF, +-10%, 200V |  |  | 1
28 | 470nF, 50V | 1 | C264 | CAP0603 | Taiyo Yuden | UMK107ABJ474KA-T | Digi-Key | 587-3171-1-ND | 0.47 µF ±10% 50V Ceramic Capacitor X5R 0603 (1608 Metric) |  |  | 1
29 | 100pF, 200V | 1 | C266 | CAP0603 | Yageo | CC0603JRNPOABN101 | Digi-Key | 311-3979-1-ND | CAP CER 100PF 200V C0G/NPO 0603 |  |  | 1
30 | 1000pF, 2kV | 1 | C267 | CAP1812 | KEMET | C1812C102KGRACTU | Digi-Key | 399-3447-1-ND | 1000pF ±10% 2000V (2kV) Ceramic Capacitor X7R 1812 (4532 Metric) |  |  | 1
31 | 47nF, 50V | 2 | C268, C269 | CAP0603 | Yageo | CC0603KRX7R9BB473 | Digi-Key | 311-1427-1-ND | 0.047µF ±10% 50V Ceramic Capacitor X7R 0603 (1608 Metric) |  |  | 2
32 | 1uF, 25V | 3 | C270, C271, C272 | CAP0603 | Samsung Electro-Mechanics | CL10A105KA8NNNC | Digi-Key | 1276-1102-1-ND | 1µF ±10% 25V Ceramic Capacitor X5R 0603 (1608 Metric) |  |  | 3
33 | 390pF, 50V | 2 | C277, C278 | CAP0402 | Samsung | CL05B391KB5NNNC | Digi-Key | 1276-1560-1-ND | 390 pF ±10% 50V Ceramic Capacitor X7R 0402 (1005 Metric) |  |  | 2
34 | 47uF, 6.3V | 4 | C281, C282, C293, C294 | CAP1206 | Samsung Electro-Mechanics | CL31A476MQHNNNE | Digi-Key | 1276-1167-1-ND | 47µF ±20% 6.3V Ceramic Capacitor X5R 1206 (3216 Metric) | NF(C294) | 1 | 3 | C281 C282 C293
35 | 100uF, 6.3V | 2 | C283, C295 | CAP1206 | MURATA | GRM31CR60J107ME39L. | Farnell | 1735535 | SMD Multilayer Ceramic Capacitor, 1206 [3216 Metric], 100 µF, 6.3 V, ± 20%, X5R, GRM Series | NF(C283 C295) | 2 | 0
36 | 4.7pF, 50V | 1 | C288 | CAP0402 | Murata Electronics North America | GRM1555C1H4R7CA01D | Farnell | 2434644 | 4.7pF ±0.25pF 50V C0G, NP0 Ceramic Capacitor -55°C ~ 125°C Surface Mount, MLCC 0402 (1005 Metric) 0.039" L x 0.020" W (1.00mm x 0.50mm) |  |  | 1
37 | 1200pF, 50V | 2 | C289, C298 | CAP0402 | Kemet | C0402C122J5GACTU | Digi-Key | 399-7334-1-ND | 1200pF ±5% 50V C0G, NP0 Ceramic Capacitor -55°C ~ 125°C Surface Mount, MLCC 0402 (1005 Metric) 0.039" L x 0.020" W (1.00mm x 0.50mm), 1200pF ±5% 50V Ceramic Capacitor C0G, NP0 0402 (1005 Metric) |  |  | 2
38 | 2.2pF, 50V | 1 | C297 | CAP0402 | Samsung Electro-Mechanics America, Inc. | CL05C2R2CB5NNNC | Digi-Key | 1276-1271-1-ND | 2.2pF ±0.25pF 50V Ceramic Capacitor C0G, NP0 0402 (1005 Metric) |  |  | 1
39 | BAT54C | 1 | D1 | BAT54C_SOT23-3 | Comchip | BAT54C-G | Digi-Key | 641-1320-1-ND | Diode Array 1 Pair Common Cathode Schottky 30 V 200mA (DC) Surface Mount TO-236-3, SC-59, SOT-23-3 |  |  | 1
40 | BAS316 | 3 | D2, D6, D7 | BAS316_DIODE_SOD323 | Nexperia | BAS316,115 | Digi-Key | 1727-4309-1-ND | DIODE GEN PURP 100V 250MA SOD323 |  |  | 3
41 | SMBJ100A | 1 | D3 | SMBJ100A_DIODE_DO-214AA | Littelfuse | SMBJ100A | Digi-Key | SMBJ100ALFCT-ND | ESD Suppressors / TVS Diodes 600W 100V 5% Uni-Directional |  |  | 1
42 | ER2D-LTP | 2 | D4, D8 | ER2D-LTP_DIODE_DO-214AA | MCC | ER2D-LTP | Digi-Key | 353-ER2D-LTPCT-ND | DIODE GEN PURP 200V 2A DO214AA |  |  | 2
43 | 12CWQ06FN | 1 | D5 | 12CWQ06FN_diode_array_DPAK | Sangdest Microelectronics | 12CWQ06FN | Digi-Key | 1655-12CWQ06FNCT-ND | Diode Array 1 Pair Common Cathode Schottky 60 V Surface Mount TO-252-3, DPak (2 Leads + Tab), SC-63 |  |  | 1
44 | NCP431AVSNT1G | 1 | D9 | SOT23-6 | ON Semiconductor | NCP431AVSNT1G | Digi-Key | NCP431AVSNT1GOSCT-ND | Shunt Voltage Reference IC Adjustable 2.5V 36 VV ±1% 100 mA SOT-23-3 (TO-236) |  |  | 1
45 | NZH10C-115 | 1 | D10 | NZH10C,115_shottky_diode_SOD123 | Nexperia | NZH10C,115 | Digi-Key | 1727-5057-1-ND | DIODE ZENER 10V 500MW SOD123F |  |  | 1
46 | ESD8472 | 38 | ESD1, ESD2, ESD3, ESD4, ESD5, ESD6, ESD7, ESD8, ESD9, ESD10, ESD11, ESD12, ESD13, ESD14, ESD15, ESD16, ESD17, ESD18, ESD19, ESD20, ESD21, ESD22, ESD23, ESD24, ESD25, ESD26, ESD27, ESD28, ESD29, ESD30, ESD31, ESD32, ESD33, ESD34, ESD35, ESD36, ESD37, ESD38 | ESD8472_X3DFN2 | ON Semiconductor | ESD8472MUT5G | Digi-Key | ESD8472MUT5GOSCT-ND | TVS DIODE 5.3VWM 14VC X3DFN2 | NF(ESD34) | 1 | 37 | ESD1 ESD2 ESD3 ESD4 ESD5 ESD6 ESD7 ESD8 ESD9 ESD10 ESD11 ESD12 ESD13 ESD14 ESD15 ESD16 ESD17 ESD18 ESD19 ESD20 ESD21 ESD22 ESD23 ESD24 ESD25 ESD26 ESD27 ESD28 ESD29 ESD30 ESD31 ESD32 ESD33 ESD35 ESD36 ESD37 ESD38
47 | Fiducial | 8 | F1, F2, F3, F4, F5, F6, F7, F8 | Fiducial |  |  |  |  |  |  |  | 8
48 | 0R | 6 | F9, F10, R6, R241, R242, R299 | RES0805 | Vishay Dale | CRCW08050000Z0EA | Digi-Key | 541-0.0ATR-ND | RES SMD 0.0 OHM JUMPER 1/8W 0805 | NF(R6 R241 R242) | 3 | 3 | F9 F10 R299
49 | 12V DC FAN | 1 | FAN1 | FAN_80mm_V1 | Sunon | ME80151V1-000U-A99 | Digi-Key | 259-1649-ND | Fan Tubeaxial 12VDC Square - 80mm L x 80mm H Vapo-Bearing™ 37.0 CFM (1.04m³/min) 2 Wire Leads |  |  | 1
50 | Fiducial | 4 | FL1, FL2, FL3, FL4 | Fiducial_local |  |  |  |  |  |  |  | 4
51 | 600R, 2A | 12 | FR1, FR4, FR9, FR13, FR14, FR15, FR16, FR17, FR18, FR19, FR20, FR21 | RES0805 | TDK Corporation | MPZ2012S601AT000 | Digi-Key | 445-2206-2-ND | FERRITE BEAD 600 OHM 0805 1LN | NF(FR17 FR19 FR21) | 3 | 9 | FR1 FR4 FR9 FR13 FR14 FR15 FR16 FR18 FR20
52 | 600R, 0.5A | 9 | FR2, FR3, FR5, FR6, FR7, FR8, FR10, FR11, FR12 | RES0402 | Murata | BLM15AX601SN1D | Digi-Key | 490-5441-1-ND | - Ferrite Bead 0402 (1005 Metric) 500mA 340mOhm |  |  | 9
53 | 74LVC1G3157FZ4 | 2 | IC1, IC32 | 74LVC1G3157FZ4_SPDT_SW_DFN1410-6 | Diodes | 74LVC1G3157FZ4-7 | Digi-Key | 74LVC1G3157FZ4-7DICT-ND | 1 Circuit IC Switch 2:1 10Ohm X2-DFN1410-6 |  |  | 2
54 | 74LVC1G34QSE-7 | 3 | IC2, IC3, IC16 | 74AHCT1G126SE-7_BUFFER_SOT353 | Diodes | 74LVC1G34QSE-7 | Mouser | 621-74LVC1G34QSE-7 | Buffers & Line Drivers Logic LVC 1 Gate SOT353 T&R 3K |  |  | 3
55 | MIC2039 | 8 | IC4, IC23, IC24, IC27, IC50, IC51, IC52, IC53 | SOT23-6 | Microchip | MIC2039EYM6-TR | Digi-Key | 576-4193-1-ND | Power Switch/Driver 1:1 P-Channel 2.5A SOT-23-6 |  |  | 8
56 | NC7WZ16P6X | 1 | IC5 | SC-70_NC7WZ16P6X | Nexperia | 74LVC2G34GW,125 | Digi-Key | 1727-4219-1-ND | Buffer, Non-Inverting 2 Element 1 Bit per Element Push-Pull Output 6-TSSOP |  |  | 1
57 | MCP3208 | 1 | IC6 | MCP3208-CI/SL_SOIC16 | Microchip | MCP3208T-CI/SL | Digi-Key | MCP3208T-CI/SLCT-ND | 12 Bit Analog to Digital Converter 4, 8 Input 1 SAR 16-SOIC |  |  | 1
58 | LM75 | 1 | IC7 | HWSON8_LM75 | NXP Semiconductors | LM75BTP,147 | Digi-Key | 568-9815-2-ND | SENSOR TEMPERATURE I2C 8HWSON |  |  | 1
59 | CAT24C128WI-GT3 | 1 | IC8 | SOIC127P600-8DL_v2 | ON Semiconductor | CAT24C128WI-GT3 | Digi-Key | CAT24C128WI-GT3CT-ND | EEPROM Memory IC 128Kb (16K x 8) I²C 1MHz 400ns 8-SOIC |  |  | 1
60 | M24128 | 1 | IC9 | M24128-DFMC6TG | STMicroelectronics | M24128-DFMC6TG | Digi-Key | 497-15739-1-ND | EEPROM Memory IC 128Kb (16K x 8) I²C 1MHz 450ns 8-UFDFPN (2x3) | NF(IC9) | 1 | 0
61 | EMC2301-1-ACZL-TR | 1 | IC10 | EMC2301-1-ACZL-TR_MOTOR_DRIVER_TSSOP8 | Microchip | EMC2301-1-ACZL-TR | Digikey | EMC2301-1-ACZL-CT-ND | IC MOTOR DRIVER 3V-3.6V 8MSOP |  |  | 1
62 | ATECC508A | 1 | IC11 | SOIC127P600-8DL_v2 | Microchip Technology | ATECC508A-SSHDA-T | Digi-Key | ATECC508A-SSHDA-TCT-ND | Authentication Chip IC Networking and Communications 8-SOIC | NF(IC11) | 1 | 0
63 | ATECC508A | 1 | IC12 | ATECC508A_UDFN8 | Microchip | ATECC508A-MAHDA-S | Digi-Key | ATECC508A-MAHDA-SDKR-ND | Authentication Chip IC Networking and Communications 8-UDFN (2x3) |  |  | 1
64 | MCP23017-E/ML | 1 | IC13 | MCP23017-E/ML_QFN28 | Microchip | MCP23017-E/ML | Digi-Key | MCP23017-E/ML-ND | I/O Expander 16 I²C 1.7 MHz 28-QFN (6x6) |  |  | 1
65 | PCF85063AT | 1 | IC14 | PCF85063AT_RTC_SOIC-8 | NXP Semiconductors | PCF85063AT/AY | Digi-Key | 568-12403-1-ND | IC RTC CLOCK/CALENDAR I2C 8SO |  |  | 1
66 | PCF85063AT | 1 | IC15 | PCF85063AT_RTC_TSSOP8 | NXP Semiconductors | PCF85063ATT/AJ | Digi-Key | 568-12404-1-ND | Real Time Clock (RTC) IC Clock/Calendar - I²C, 2-Wire Serial 8-SOIC (0.154", 3.90mm Width) | NF(IC15) | 1 | 0
67 | ICE5LP4K-SG48ITR | 1 | IC17 | ICE5LP4K-SG48ITR_Lattice_FPGA_QFN48 | Lattice Semiconductor | ICE5LP4K-SG48ITR | Digikey | 220-2234-1-ND | iCE40 Ultra™ Field Programmable Gate Array (FPGA) IC 39 81920 3520 48-VFQFN Exposed Pad |  |  | 1
68 | MX25U1632FM2I02 | 1 | IC18 | S25FL164K_WSON8_DFN6 | Macronix | MX25U1632FM2I02 | Digikey | 1092-MX25U1632FM2I02-ND | IC FLASH 16MBIT SPI/QUAD 8SOP |  |  | 1
69 | USB2517 | 1 | IC19 | USB2517-JZX-TR_USB_HUB_QFN64 | Microchip | USB2517-JZX-TR | Digi-Key | USB2517-JZX-CT-ND | USB Hub Controller USB 2.0 USB Interface 64-QFN (9x9) |  |  | 1
70 | NX3DV42GU | 4 | IC20, IC25, IC26, IC39 | FSUSB42UMX | NXP Semiconductors | NX3DV42GU,115 | Digikey | 568-12388-1-ND | USB Switch IC 1 Channel 10-UMLP (1.8x1.4) |  |  | 4
71 | M24C02 | 1 | IC21 | SOIC127P600-8DL_v2 | STMicroelectronics | M24C02-RMN6TP | Digi-Key | 497-8633-1-ND | IC EEPROM 2KBIT I2C 400KHZ 8SOIC | NF(IC21) | 1 | 0
72 | AT24C02 | 1 | IC22 | M24128-DFMC6TG | Microchip | AT24C02C-MAHM-E | Digi-Key | AT24C02C-MAHM-ECT-ND | IC EEPROM 2KBIT I2C 1MHZ 8UDFN | NF(IC22) | 1 | 0
73 | FUSB340TMX | 2 | IC28, IC29 | FUSB340TMX_USB_switch_18-XFQFN | ON Semiconductor / Fairchild | FUSB340TMX | Digikey | FUSB340TMXCT-ND | USB Switch USB 3.1 USB Interface 18-TMLP (2x2.8) |  |  | 2
74 | LMK00105 | 2 | IC30, IC36 | LMK00105SQ | Texas Instruments | LMK00105SQ/NOPB | Digi-Key | LMK00105SQ/NOPBCT-ND | IC CLK BUFFER 2:5 200MHZ 24WQFN |  |  | 2
75 | LP5907-3.0 | 2 | IC31, IC37 | SOT23-5 | Texas Instruments | LP5907QMFX-3.0Q1 | Digi-Key | 296-40364-1-ND | Linear Voltage Regulator IC Positive Fixed 1 Output 250mA SOT-23-5 | NF(IC31 IC37) | 2 | 0
76 | AD5662 | 1 | IC33 | AD5662_SOT23-8 | Analog Devices Inc. | AD5662BRJZ-2REEL7 | Digi-Key | AD5662BRJZ-2REEL7CT-ND | IC DAC 16BIT BUFF V-OUT SOT23-8 |  |  | 1
77 | ADF4002 | 1 | IC34 | ADF4002 | Analog Devices Inc | ADF4002BCPZ-RL7 | Digi-Key | ADF4002BCPZ-RL7CT-ND | IC PLL FREQUENCY SYNTH 20-LFCSP |  |  | 1
78 | AD5601BKSZ-REEL7 | 1 | IC35 | AD5601_SOT23-6 | Analog Devices | AD5601BKSZ-REEL7 | Digi-Key | AD5601BKSZ-REEL7TR-ND | IC DAC 8BIT BUFF V-OUT SC70-6 | NF(IC35) | 1 | 0
79 | SN74AVC1T45DBV | 2 | IC38, IC41 | SOT23-6 | Texas Instruments | SN74AXC1T45DBVR | Digi-Key | 296-47598-1-ND | Voltage Level Translator Bidirectional 1 Circuit 1 Channel 500Mbps SOT-23-6 | NF(IC38 IC41) | 2 | 0
80 | NEO-M8Q | 1 | IC40 | NEO-7M/8M | U-blox | NEO-M8Q-0 | Digi-Key | 672-1009-1-ND | IC RECEIVER GPS/GNSS 24LCC |  |  | 1
81 | SKY13286 | 4 | IC42, IC43, IC46, IC47 | SKY13286-359LF_RF_switch_QFN16 | Skyworks Solutions | SKY13286-359LF | Digi-Key | 863-1049-1-ND | RF Switch IC GSM, ISM, PCS, WCDMA SPDT 6 GHz 50Ohm 16-QFN (4x4) |  |  | 4
82 | TQP3M9018 | 2 | IC44, IC45 | TQP3M9018_PA_QFN16 | Qorvo | TQP3M9019 | Mouser | 772-TQP3M9019 | RF Amplifier .05-4GHz P1dB= 22dB Gain 26.4dB 5Volts |  |  | 2
83 | SPF5043Z | 2 | IC48, IC49 | SPF5043Z_SOT-343 | Qorvo | SPF5043Z | Mouser | 772-SPF5043Z | RF Amplifier .05-4GHz SSG 12.9dB NF .8dB GaAs |  |  | 2
84 | NCP1083 | 1 | IC54 | NCP1083_PoE_controller_TSSOP20 | ON Semiconductor | NCP1083DER2G | Digi-Key | NCP1083DER2GOSCT-ND | Power Over Ethernet Controller 1 Channel 802.3at (PoE+), 802.3af (PoE) 20-TSSOP-EP |  |  | 1
85 | IRF9358TRPBF | 1 | IC55 | IRF9358TRPBF_DUAL_NMOS_SOIC8 | International Rectifier | IRF9358TRPBF | Digi-Key | IRF9358TRPBFDKR-ND | Mosfet Array 2 P-Channel (Dual) 30V 9.2A 2W Surface Mount 8-SO |  |  | 1
86 | CYPD3177-24LQXQT | 1 | IC56 | USB_POWER_DISTR_CYPD3177_QFN24 | Cypress | CYPD3177-24LQXQT | Digi-Key | 428-CYPD3177-24LQXQTCT-ND | 428-CYPD3177-24LQXQTCT-ND |  |  | 1
87 | ADP2386 | 2 | IC57, IC58 | ADP2386 | Analog Devices Inc. | ADP2386ACPZN-R7 | Digi-Key | ADP2386ACPZN-R7DKR-ND | IC REG BUCK ADJ 6A SYNC 24LFCSP, Buck Switching Regulator IC Positive Adjustable 0.6V 1 Output 6A 24-WFQFN Exposed Pad, CSP |  |  | 2
88 | AP7361-FGE | 5 | IC59, IC60, IC61, IC63, IC64 | AP7361 | Diodes Incorporated | AP7361-FGE-7 | Digi-Key | AP7361-FGE-7DICT-ND | IC REG LDO ADJ 1A 8DFN |  |  | 5
89 | AS431 | 1 | IC62 | SOT23-3_v2 | Diodes | AS431ANTR-G1 | Digi-Key | AS431ANTR-G1DICT-ND | Shunt Voltage Reference IC Adjustable 2.5V 36 VV ±0.5% 100 mA SOT-23-3 |  |  | 1
90 | DF40C-100DS-0.4V(51) | 2 | J1, J2 | FP-DF40C-100DS-0.4V(51) | Amphenol ICC / FCI | 10164227-1001A1RLF | Mouser | 649-01642271001A1RLF | 100 Position Connector Receptacle, Center Strip Contacts Surface Mount Gold, [NoValue] |  |  | 2
91 | 1775862-2 | 1 | J3 | MiniPCIe_connector_XTRX | JAE Electronics | MM60-52B1-G1-R850 | Digi-Key | 670-2516-1-ND | 52 Position Female Connector PCI Express Mini Card Gold 0.031" (0.80mm) |  |  | 1
92 | nano SIM (push-push) | 1 | J4 | nano_SIM_SIM8066-6-1-14-01-A | Global Connector Technology | SIM8066-6-1-14-01-A | Farnell | 3772948 | 7 (6 + 1) Position Card Connector NANO SIM Surface Mount, Right Angle Gold |  |  | 1
93 | Header 3x1 pin | 8 | J5, J6, J25, J38, J39, J40, J41, J42 | HDR_1x3 | Wurth Electronics | 61300311121 | Digi-Key | 732-5316-ND | Connector Header Through Hole 3 position 0.100" (2.54mm) | NF(J5 J6 J25) | 3 | 5 | J38 J39 J40 J41 J42
94 | Micro SD card holder | 1 | J7 | MICRO_SD_CARD_114-00841-68_v2 | Amphenol Commercial Products | 114-00841-68 | Digi-Key | 114-00841-68-1-ND | 10 (8 + 2) Position Card Connector Secure Digital - microSD™ Surface Mount, Right Angle Gold |  |  | 1
95 | Header 5X1 | 1 | J8 | Header1x5_TH_LOCKING | Molex | 0022112052 | Digi-Key | WM2703-ND | Connector Header Through Hole 5 position 0.100" (2.54mm) |  |  | 1
96 | Ethernet with magnetics | 1 | J9 | RJ45_ETHERNET_MAG_A70-112-331N126 | Link-PP | LPJG0926HENL | Link-PP | LPJG0926HENL | A70-112-331N126 Tab Down Ethernet Magnetic RJ45 Connector LPJG0926HENL With POE + |  |  | 1
97 | Header 10X2 | 1 | J10 | HEADER10X2_TH_LOCK | On-Shore Technology | 302-S201 | Digi-Key | ED10524-ND | Connector Header Through Hole 20 position 0.100" (2.54mm) |  |  | 1
98 | Header 4x1 | 2 | J11, J17 | HEADER4X1_TH | Wurth Electronics Inc. | 61300411121 | Digi-Key | 732-5317-ND | 4 Positions Header Connector 0.100" (2.54mm) Through Hole Gold | NF(J11 J17) | 2 | 0
99 | Header 7X2 | 1 | J12 | Header7x2_TH | Adam Equipment | PH2-14-UA | Digi-Key | 2057-PH2-14-UA-ND | Connector Header Through Hole 14 position 0.100" (2.54mm) |  |  | 1
100 | Header 2X2 | 1 | J13 | Header2x2_TH | Adam Equipment | PH2-04-UA | Digi-Key | 2057-PH2-04-UA-ND | Connector Header Through Hole 4 position 0.100" (2.54mm) | NF(J13) | 1 | 0
101 | A/V, 3.5mm | 1 | J14 | Audio_jack_3.5mm | CUI Inc. | SJ-43515TS | Digi-Key | CP-43515TS-ND | CONN JACK 4COND 3.5MM R/A |  |  | 1
102 | FPC 15-pin | 2 | J15, J16 | FPC_CONNECTOR_15pin_1-1734248-5 | TE Connectivity | 1-1734248-5 | Digi-Key | A101418DKR-ND | 15 Position FPC Connector Contacts, Vertical, 1 Sided 0.039" (1.00mm) Surface Mount |  |  | 2
103 | Header 2X1 | 4 | J18, J19, J27, J53 | HDR_1x2 | 3M | 961102-6404-AR | Digi-Key | 3M9447-ND | 2 Positions Header, Unshrouded Connector 0.100" (2.54mm) Through Hole Gold | NF(J18 J19 J27) | 3 | 1 | J53
104 | Header 2X1 | 4 | J20, J24, J55, J56 | Header1x2_TH_LOCKING | Molex | 22-11-2026 | Digi-Key | WM19460-ND | Connector Header Through Hole 2 position 0.100" (2.54mm) | NF(J20) | 1 | 3 | J24 J55 J56
105 | SMA panel mount | 7 | J21, J34, J37, J47, J48, J51, J52 | SMA_connector_side | Linx | CONSMA002-L-G | Digi-Key | CONSMA002-L-G-ND | SMA Connector Receptacle, Female Socket 50Ohm Panel Mount, Through Hole, Right Angle Solder |  |  | 7
106 | U.FL/MMCX | 8 | J22, J33, J35, J44, J45, J46, J49, J50 | MMCX_UFL_conn_u | Molex, LLC | 0734120110 | Digi-Key | WM5587CT-ND | CONN UMC RCPT STR 50 OHM SMD |  |  | 8
107 | 4 pin FAN header | 1 | J23 | Header1x4_TH_LOCKING_v2 | Molex | 47053-1000 | Digi-Key | WM4330-ND | Connector Header Through Hole 4 position 0.100" (2.54mm) |  |  | 1
108 | USB type C connector | 1 | J26 | DUAL_USB-C_632723100011 | Wurth Electronics | 632723100011 | Digi-Key | 732-9617-1-ND | USB - C (Type - C) USB 3.1 (USB 3.1 Gen 2, Superspeed+) Receptacle Connector 24 Position Surface Mount, Right Angle; Through Hole |  |  | 1
109 | Header 10X2 | 1 | J28 | Header10x2_TH_2MM | Molex | 87831-5920 | Mouser | 538-87831-5920 | Connector Header Through Hole 20 position 0.079" (2.00mm). 19 pins loaded (pin 20 void) |  |  | 1
110 | USB | 1 | J29 | HEADER4X1_TH | Wurth Electronics Inc. | 61300411121 | Digi-Key | 732-5317-ND | 4 Positions Header Connector 0.100" (2.54mm) Through Hole Gold | NF(J29) | 1 | 0
111 | 48406-0003 | 1 | J30 | Dual_USB_48406-0003_Molex | Molex | 0484060003 | Mouser | 538-48406-0003 | USB Connectors USB 3.0 F/A STD RA REC STACKED 15u' |  |  | 1
112 | HDMI Type A socket (angle) | 2 | J31, J32 | HDMI_2007435-3 | TE Connectivity | 2007435-3 | Digi-Key | A118325-ND | CONN RCPT HDMI 19POS PCB R/A |  |  | 2
113 | Header 3X2 | 1 | J36 | Header3x2 | Adam Equipment | PH2-06-UA | Digi-Key | 2057-PH2-06-UA-ND | Connector Header Through Hole 6 position 0.100" (2.54mm) |  |  | 1
114 | Batt | 1 | J43 | HDR_1x2 | 3M | 961102-6404-AR | Digi-Key | 3M9447-ND | 2 Positions Header, Unshrouded Connector 0.100" (2.54mm) Through Hole Gold | NF(J43) | 1 | 0
115 | CONN_PWR_JACK_2.1x5.5mm | 1 | J54 | CONN_PWR_JACK_v2 | CUI | PJ-002A | Digi-Key | CP-002A-ND | Power Barrel Connector Jack 2.10mm ID (0.083"), 5.50mm OD (0.217") Through Hole, Right Angle |  |  | 1
116 | Scap | 1 | J57 | 874370443_1P5_SMD_HEADER | Molex | 0874370443 | Digi-Key | WM7664CT-ND | Connector Header Surface Mount 4 position 0.059" (1.50mm) |  |  | 1
117 | Scap | 1 | J58 | HEADER4X1_TH | Wurth Electronics Inc. | 61300411121 | Digi-Key | 732-5317-ND | 4 Positions Header Connector 0.100" (2.54mm) Through Hole Gold | NF(J58) | 1 | 0
118 | 1 pcs. | 8 | JMP1, JMP2, JMP3, JMP4, JMP5, JMP6, JMP7, JMP8 |  | Sullins | SPC02SYAN | Digi-Key | S9001-ND | 2 (1 x 2) Position Shunt Connector Black Closed Top 0.100" (2.54mm) Gold | NF(JMP1) | 1 | 7 | JMP2 JMP3 JMP4 JMP5 JMP6 JMP7 JMP8
119 | 47nH | 1 | L1 | RES0402 | COILCRAFT | 0402HP-47NXJLU | Farnell | 2285856 | INDUCTOR, RF, 47NH, 5%, 2.4GHZ, SMD; Product Range:0402HP Series; Inductance:47nH; Inductance Tolerance:± 5%; High Frequency Inductor Case:0402 [1005 Metric]; Self Resonant Frequency Min:2.4GHz; DC Resistance Max:0.58ohm; DC Current Rating:420mA |  |  | 1
120 | 220nH, 2% | 2 | L2, L3 | RES0603 | TDK | MLZ1608DR22DT000 | Digikey | 445-6387-1-ND | Fixed Inductors 220 NH 2% |  |  | 2
121 | 22nH, 2% | 4 | L4, L5, L6, L7 | RES0603 | Murata | LQW18AN22NG00D | Digi-Key | 490-6874-1-ND | Fixed Inductors 22 NH 2% |  |  | 4
122 | 1uH, 3.2A | 2 | L8, L9 | NRS4018T3R3MDGJ_inductor | Taiyo Yuden | NRS4018T1R0NDGJ | Digi-Key | 587-2888-1-ND | 1 µH Shielded Drum Core, Wirewound Inductor 3.2 A 32.4mOhm Max Nonstandard |  |  | 2
123 | 2.2µH | 1 | L10 | FDVE1040_TOKO_INDUCTOR | Vishay Dale | IHLP4040DZER2R2M01 | Digi-Key | 541-1299-1-ND | 2.2µH Shielded Molded Inductor 12A 9 mOhm Max Nonstandard |  |  | 1
124 | 3.3µH | 1 | L11 | FDVE1040_TOKO_INDUCTOR | Vishay Dale | IHLP4040DZER3R3M01 | Digi-Key | 541-1298-1-ND | 3.3µH Shielded Molded Inductor 10A 14.4 mOhm Max Nonstandard |  |  | 1
125 | LED_RG_SMD | 7 | LED1, LED2, LED3, LED4, LED5, LED6, LED7 | LED-2x0603 | Avago Technologies US Inc. | HSMF-C165 | Digi-Key | 516-1419-1-ND | LED GREEN/RED DIFFUSED 0603 SMD |  |  | 7
126 | LED_green | 1 | LED8 | LED-0603-GREEN | Avago Technologies US Inc. | HSMG-C190 | Digi-Key | 516-1425-2-ND | Green 572nm LED Indication - Discrete 2.2V 0603 (1608 Metric) | NF(LED8) | 1 | 0
127 | Green | 1 | LED9 | LED-0603-GREEN | Avago Technologies US Inc. | HSMG-C190 | Digi-Key | 516-1425-2-ND | Green 572nm LED Indication - Discrete 2.2V 0603 (1608 Metric) | NF(LED9) | 1 | 0
128 | Screw (M2, 5mm) | 6 | MECH1, MECH3, MECH5, MECH7, MECH9, MECH11 |  | B&F Fastener | MPMS0020005PH | Digi-Key | H738-ND | M2x0.4 Pan Head Machine Screw Phillips Drive |  |  | 6
129 | SMD spacer (M2, 1.5mm) | 6 | MECH2, MECH4, MECH6, MECH8, MECH10, MECH12 |  | Wurth Electronics | 9774015243R | Digi-Key | 732-7069-1-ND | RND STANDOFF M2X0.4 STEEL 1.5MM |  |  | 6
130 | Light pipe | 6 | MECH13, MECH14, MECH15, MECH16, MECH17, MECH18 | LIGHT_PIPE_RIGHT_ANGLE_SLP3-200-100-F | Bivar | SLP3-200-100-F | Digi-Key | 492-1865-ND | Light Pipe Single Clear Rigid Board Mount, Press Fit, Right Angle |  |  | 6
131 | # pcs. | 4 | MECH19, MECH20, MECH21, MECH22 | PCB_standoff | FIX&FASTEN | FIX-MAE-5TV | TME | FIX-MAE-5TV | PCB distance; polyamide; L:5mm; Colour: natural; Øcutout:3mm |  |  | 4
132 | 2-pin header | 1 | MECH23 |  | Molex | 22-01-2027 | Newark | 47T5763 | 2 Rectangular Connectors - Housings Receptacle White 0.100" (2.54mm) |  |  | 1
133 | Crimp | 2 | MECH24, MECH25 |  | Molex | 08-50-0032 | Mouser | 538-08-50-0032 | Non-Gendered Contact Tin 22-30 AWG Crimp |  |  | 2
134 | Screw (M3, 20 mm) | 3 | MECH26, MECH27, MECH28 |  | TR Fastenings | M3 20 KRSTMC Z100 | Farnell | 1420401 | Machine Screw, M3, 20 mm, Steel, Bright Zinc, Flat / Countersunk Head Pozidriv, Pack of 100 | Buy packs of 100 pcs. by dividing the required amount by 100 and rounding the resulting number to whole packs. |  | 3
135 | Spacer (M3, 12mm) | 3 | MECH29, MECH30, MECH31 |  | ETTINGER | 005.03.123 | Farnell | 1466772 | Standoff, Brass, M3, Hex Female, 12 mm, 12 mm |  |  | 3
136 | Screw (M3, 6 mm) | 3 | MECH32, MECH33, MECH34 |  | TR Fastenings | M3 6 PRSTMC Z100 | Farnell | 1419986 | Machine Screw, M3, 6 mm, Steel 4.8, Bright Zinc, Pan Head Pozidriv | Buy packs of 100 pcs. by dividing the required amount by 100 and rounding the resulting number to whole packs. |  | 3
137 | RF SHIELD FRAME | 4 | MECH35, MECH36, MECH37, MECH38 | RF_SHIELD_FRAME_16P5x16P5_2118716-2_v1 | TE Connectivity | 2118716-2 | Digi-Key | A126152CT-ND | RF Shield Frame 0.650" (16.50mm) X 0.650" (16.50mm) Surface Mount |  |  | 4
138 | RF SHIELD COVER | 4 | MECH39, MECH40, MECH41, MECH42 | RF_SHIELD_COVER_16Px916P9_2118715-2 | TE Connectivity | 2118715-2 | Digi-Key | A126120-ND | RF Shield Cover 0.665" (16.90mm) X 0.665" (16.90mm) Vented Surface Mount |  |  | 4
139 | 0R | 119 | R1, R2, R3, R4, R5, R7, R8, R9, R10, R11, R12, R13, R17, R18, R20, R21, R22, R24, R28, R32, R39, R75, R77, R79, R80, R82, R84, R86, R88, R90, R94, R96, R97, R98, R99, R100, R103, R104, R105, R106, R107, R108, R111, R114, R115, R116, R119, R121, R125, R127, R128, R129, R133, R134, R140, R141, R142, R143, R144, R145, R146, R147, R149, R150, R152, R153, R154, R155, R156, R158, R159, R161, R165, R166, R167, R169, R171, R172, R175, R177, R181, R186, R204, R205, R207, R208, R210, R211, R212, R215, R217, R218, R219, R221, R222, R223, R224, R225, R226, R228, R229, R230, R231, R232, R233, R234, R235, R236, R243, R244, R245, R246, R270, R291, R296, R297, R313, R317, R321 | RES0402 | Yageo | RC0402JR-070RL | Digi-Key | 311-0.0JRTR-ND | RES SMD 0.0OHM JUMPER 1/16W 0402 | NF(R1 R2 R4 R8 R9 R10 R11 R12 R13 R17 R18 R21 R22 R24 R28 R32 R75 R77 R79 R80 R84 R86 R88 R104 R106 R111 R114 R115 R128 R133 R140 R141 R144 R145 R147 R150 R152 R153 R155 R156 R159 R161 R169 R171 R172 R175 R177 R208 R210 R212 R215 R217 R218 R221 R222 R226 R228 R230 R231 R233 R234 R235 R236 R243 R244 R245 R246 R291 R317 R321) | 70 | 49 | R3 R5 R7 R20 R39 R82 R90 R94 R96 R97 R98 R99 R100 R103 R105 R107 R108 R116 R119 R121 R125 R127 R129 R134 R142 R143 R146 R149 R154 R158 R165 R166 R167 R181 R186 R204 R205 R207 R211 R219 R223 R224 R225 R229 R232 R270 R296 R297 R313
140 | 100k, 1% | 13 | R14, R83, R87, R237, R238, R239, R240, R247, R248, R249, R250, R302, R309 | RES0402 | Vishay | CRCW0402100KFKEDC | Digi-Key | 541-3960-6-ND | 100 kOhms ±1% 0.063W, 1/16W Chip Resistor 0402 (1005 Metric) Thick Film | NF(R87 R237 R238 R239 R240) | 5 | 8 | R14 R83 R247 R248 R249 R250 R302 R309
141 | 10k, 1% | 51 | R15, R23, R25, R27, R40, R46, R48, R49, R50, R53, R54, R55, R56, R57, R58, R66, R69, R74, R102, R109, R110, R113, R117, R118, R120, R123, R130, R131, R132, R135, R136, R137, R151, R160, R162, R190, R191, R192, R194, R199, R227, R251, R252, R253, R254, R279, R293, R294, R295, R298, R300 | RES0402 | Yageo | RC0402FR-0710KL | Digi-Key | 311-10.0KLRTR-ND | RES SMD 10K OHM 1% 1/16W 0402 | NF(R48 R49 R50 R66 R131 R135 R137 R190 R194 R199 R293 R295) | 12 | 39 | R15 R23 R25 R27 R40 R46 R53 R54 R55 R56 R57 R58 R69 R74 R102 R109 R110 R113 R117 R118 R120 R123 R130 R132 R136 R151 R160 R162 R191 R192 R227 R251 R252 R253 R254 R279 R294 R298 R300
142 | 2k2, 1% | 12 | R16, R19, R35, R37, R42, R43, R126, R138, R139, R278, R287, R292 | RES0402 | Stackpole Electronics Inc | RMCF0402FT2K20 | Digi-Key | RMCF0402FT2K20CT-ND | RES SMD 2.2K OHM 1% 1/16W 0402 | NF(R126 R278 R292) | 3 | 9 | R16 R19 R35 R37 R42 R43 R138 R139 R287
143 | 470R, 1% | 12 | R26, R29, R30, R148, R157, R163, R188, R255, R256, R257, R258, R319 | RES0402 | Yageo | RC0402FR-07470RL | Digi-Key | 311-470LRCT-ND | 470 Ohms ±1% 0.063W, 1/16W Chip Resistor 0402 (1005 Metric) Moisture Resistant Thick Film |  |  | 12
144 | 1k, 1% | 11 | R31, R41, R65, R71, R180, R187, R280, R286, R312, R316, R322 | RES0402 | Stackpole Electronics Inc | RMCF0402FT1K00 | Digi-Key | RMCF0402FT1K00TR-ND | RES SMD 1K OHM 1% 1/16W 0402 |  |  | 11
145 | 220R, 1% | 2 | R33, R38 | RES0402 | Yageo | RC0402FR-07220RL | Digi-Key | 311-220LRCT-ND | 220 Ohms ±1% 0.063W, 1/16W Chip Resistor 0402 (1005 Metric) Moisture Resistant Thick Film |  |  | 2
146 | 100R, 1% | 2 | R34, R36 | RES0402 | Stackpole Electronics Inc. | RMCF0402FT100R | Digi-Key | RMCF0402FT100RDKR-ND | RES SMD 100 OHM 1% 1/16W 0402 |  |  | 2
147 | 3k, 1% | 4 | R44, R185, R196, R310 | RES0402 | Vishay Dale | CRCW04023K00FKED | Digi-Key | 541-3.00KLCT-ND | RES SMD 3K OHM 1% 1/16W 0402 | NF(R44 R185 R196) | 3 | 1 | R310
148 | 22k, 1% | 3 | R45, R272, R305 | RES0402 | Yageo | RC0402FR-0722KL | Digi-Key | 311-22.0KLRCT-ND | RES SMD 22K OHM 1% 1/16W 0402 |  |  | 3
149 | 0R | 14 | R47, R51, R52, R164, R170, R173, R176, R178, R179, R184, R203, R209, R213, R216 | RES0402_v2 | Yageo | RC0402JR-070RL | Digi-Key | 311-0.0JRTR-ND | RES SMD 0.0OHM JUMPER 1/16W 0402 | NF(R51 R170 R173 R176 R178 R179 R209 R213 R216) | 9 | 5 | R47 R52 R164 R184 R203
150 | 1.6k, 1% | 8 | R59, R60, R61, R62, R63, R64, R314, R323 | RES0402 | Yageo | RC0402FR-071K6L | Digi-Key | YAG3045CT-ND | 1.6 kOhms ±1% 0.063W, 1/16W Chip Resistor 0402 (1005 Metric) Moisture Resistant Thick Film |  |  | 8
151 | 330R, 1% | 14 | R67, R68, R70, R73, R76, R78, R81, R85, R89, R91, R95, R101, R193, R326 | RES0402 | Yageo | RC0402FR-07330RL | Digi-Key | 311-330LRCT-ND | 330 Ohms ±1% 0.063W, 1/16W Chip Resistor 0402 (1005 Metric) Moisture Resistant Thick Film |  |  | 14
152 | 12k, 1% | 2 | R72, R122 | RES0402 | Samsung Electro-Mechanics | RC1005F123CS | Digi-Key | 1276-4122-1-ND | 12 kOhms ±1% 0.063W, 1/16W Chip Resistor 0402 (1005 Metric) Moisture Resistant Thick Film |  |  | 2
153 | 470k, 1% | 3 | R92, R93, R267 | RES0402 | TE Connectivity | CRGCQ0402F470K | Digi-Key | A129659CT-ND | 470 kOhms ±1% 0.063W, 1/16W Chip Resistor 0402 (1005 Metric) Automotive AEC-Q200, Moisture Resistant Thick Film | NF(R267) | 1 | 2 | R92 R93
154 | 100R, 1% | 1 | R112 | RES0603 | Stackpole Electronics Inc. | RMCF0402FT100R | Digi-Key | RMCF0402FT100RDKR-ND | RES SMD 100 OHM 1% 1/16W 0402 |  |  | 1
155 | 1M, 1% | 1 | R124 | RES0402 | Yageo | RC0402FR-071ML | Digi-Key | 311-1.00MLRCT-ND | 1 MOhms ±1% 0.063W, 1/16W Chip Resistor 0402 (1005 Metric) Moisture Resistant Thick Film |  |  | 1
156 | 49.9R, 1% | 10 | R168, R182, R189, R195, R197, R198, R200, R201, R202, R206 | RES0402 | Samsung Electro-Mechanics America, Inc. | RC1005F49R9CS | Digi-Key | 1276-3469-6-ND | RES SMD 49.9 OHM 1% 1/16W 0402 |  |  | 10
157 | 22R, 1% | 2 | R174, R214 | RES0402 | Yageo | RC0402FR-0722RL | Digi-Key | 311-22.0LRTR-ND | RES SMD 22 OHM 1% 1/16W 0402 | NF(R174 R214) | 2 | 0
158 | 10R, 1% | 2 | R183, R220 | RES0402 | Stackpole Electronics | RMCF0402FT10R0 | Digi-Key | RMCF0402FT10R0CT-ND | 10 Ohms ±1% 0.063W, 1/16W Chip Resistor 0402 (1005 Metric) Automotive AEC-Q200 Thick Film |  |  | 2
159 | 30.1R, 1% | 1 | R259 | RES0402 | Stackpole Electronics | RMCF0402FT30R1 | Digi-Key | RMCF0402FT30R1CT-ND | 30.1 Ohms ±1% 0.063W, 1/16W Chip Resistor 0402 (1005 Metric) Automotive AEC-Q200 Thick Film |  |  | 1
160 | 75R, 1% | 2 | R260, R261 | RES0402 | Cyntec | PFR05S-750-FNH | Digi-Key | 2037-PFR05S-750-FNHDKR-ND | RES SMD 75 OHM 1% 1/16W 0402 |  |  | 2
161 | 118k, 1% | 1 | R262 | RES0402 | Yageo | RC0402FR-07118KL | Digi-Key | YAG2369CT-ND | 118 kOhms ±1% 0.063W, 1/16W Chip Resistor 0402 (1005 Metric) Moisture Resistant Thick Film |  |  | 1
162 | 5.1k, 5% | 6 | R263, R275, R282, R283, R284, R285 | RES0402 | Yageo | RC0402JR-075K1L | Digi-Key | 311-5.1KJRCT-ND | RES 5.1K OHM 5% 1/16W 0402 |  |  | 6
163 | 680R, 1% | 1 | R264 | RES0402 | Yageo | RC0402FR-07680RL | Digi-Key | 311-680LRCT-ND | 680 Ohms ±1% 0.063W, 1/16W Chip Resistor 0402 (1005 Metric) Moisture Resistant Thick Film |  |  | 1
164 | 44.2k, 1% | 6 | R265, R281, R301, R304, R306, R311 | RES0402 | Panasonic Electronic Components | ERJ-2RKF4422X | Digi-Key | P44.2KLCT-ND | RES SMD 44.2K OHM 1% 1/10W 0402 | NF(R301 R306) | 2 | 4 | R265 R281 R304 R311
165 | 10R, 1% | 1 | R266 | RES0603 | Vishay | CRCW060310R0FKEAC | Digi-Key | 541-3952-1-ND | 10 Ohms ±1% 0.1W, 1/10W Chip Resistor 0603 (1608 Metric) Thick Film |  |  | 1
166 | 22.1k, 1% | 1 | R268 | RES0402 | Yageo | AC0402FR-0722K1L | Digi-Key | YAG3457CT-ND | RES SMD 22.1K OHM 1% 1/16W 0402 |  |  | 1
167 | 330R, 1% | 1 | R269 | RES2512 | TE Connectivity | CRGP2512F330R | Digi-Key | A130715CT-ND | RES 330 OHM 1% 2W 2512 |  |  | 1
168 | 768R, 1% | 1 | R271 | RES0402 | Yageo | RC0402FR-07768RL | Digi-Key | YAG3229CT-ND | RES 768 OHM 1% 1/16W 0402 |  |  | 1
169 | 15k, 1% | 1 | R273 | RES0402 | Yageo | AC0402FR-0715KL | Digi-Key | YAG3444CT-ND | Thick Film Resistors - SMD 15 kOhms 62.5 mW 0402 1% AEC-Q200 |  |  | 1
170 | 3.92k, 1% | 1 | R274 | RES0402 | Yageo | RC0402FR-073K92L | Digi-Key | 311-3.92KLRCT-ND | 3.92 kOhms ±1% 0.063W, 1/16W Chip Resistor 0402 (1005 Metric) Moisture Resistant Thick Film |  |  | 1
171 | 150k, 1% | 1 | R276 | RES0402 | Yageo | RC0402FR-07150KL | Digi-Key | 311-150KLRCT-ND | RES 150K OHM 1% 1/16W 0402 |  |  | 1
172 | 0.1R, 1% | 1 | R277 | RES2512 | TE Connectivity | TLRP3A30DR100FTE | Digi-Key | 1712-TLRP3A30DR100FTECT-ND | RES 0.1 OHM 1% 3W 2512 |  |  | 1
173 | 2.4k, 1% | 4 | R288, R289, R290, R320 | RES0402 | Yageo | RC0402FR-072K4L | Digi-Key | 311-2.40KLRCT-ND | 2.4 kOhms ±1% 0.063W, 1/16W Chip Resistor 0402 (1005 Metric) Moisture Resistant Thick Film |  |  | 4
174 | 2.21k, 1% | 1 | R303 | RES0402 | Stackpole Electronics Inc. | RMCF0402FT2K21 | Digi-Key | RMCF0402FT2K21CT-ND | RES SMD 2.21K OHM 1% 1/16W 0402 |  |  | 1
175 | 100R, 1% | 2 | R307, R308 | RES0805 | Yageo | RC0805FR-07100RL | Digi-Key | 311-100CRCT-ND | 100 Ohms ±1% 0.125W, 1/8W Chip Resistor 0805 (2012 Metric) Moisture Resistant Thick Film | NF(R307) | 1 | 1 | R308
176 | 1.2k, 1% | 2 | R315, R324 | RES0402 | Yageo | RC0402FR-071K2L | Digi-Key | 311-1.20KLRCT-ND | 1.2 kOhms ±1% 0.063W, 1/16W Chip Resistor 0402 (1005 Metric) Moisture Resistant Thick Film |  |  | 2
177 | 510R, 1% | 2 | R318, R325 | RES0402 | Yageo | RC0402FR-07510RL | Digi-Key | 311-510LRCT-ND | 510 Ohms ±1% 0.063W, 1/16W Chip Resistor 0402 (1005 Metric) Moisture Resistant Thick Film |  |  | 2
178 | 4 bit switch | 1 | SW1 | SW_4WAY_SMD_1P27 | Omron Electronics Inc-EMC Div | A6H-4101 | Digi-Key | SW1080-ND | Dip Switch SPST 4 Position Surface Mount Slide (Standard) Actuator 25mA 24VDC |  |  | 1
179 | POE300F-12LD | 1 | T1 | POE300F50LD_TRANSFORMER | Coilcraft | POE300F-12LD | Mouser | 994-POE300F-12LD | Audio Transformers / Signal Transformers POE300F Flyback PoE+ 30uH 12 V 2.5 A |  |  | 1
180 | TESTPOINT_THT_MINI | 4 | TP1, TP2, TP3, TP4 | TP-SMD-LOW_PROFILE | Harwin Inc | S1751-46R | Digi-Key | 952-1478-2-ND | Natural PC Test Point 0.128" x 0.065" x 0.079" (3.25mm x 1.65mm x 2.00mm) Brass, Tin Plating Surface Mount Mounting Type |  |  | 4
181 | TVS | 16 | VD1, VD2, VD3, VD4, VD5, VD6, VD7, VD8, VD10, VD11, VD12, VD13, VD14, VD15, VD16, VD17 | SOD323 | Sangdest Microelectronics | SD03LCC | Digi-Key | 1655-SD03LCCCT-ND | 19V Clamp 20A (8/20µs) Ipp Tvs Diode Surface Mount SOD-323 |  |  | 16
182 | SK36A | 5 | VD9, VD19, VD20, VD21, VD23 | SK32A-L_DIODE_DO-214AC | Micro Commercial Co | SK36A-LTP | Digi-Key | SK36A-LTPMSCT-ND | DIODE SCHOTTKY 60V 3A DO214AC | NF(VD9) | 1 | 4 | VD19 VD20 VD21 VD23
183 | SMAJ58A | 1 | VD18 | SMAJ58A_shottky_diode | Diodes Incorporated | SMAJ58A-13-F | Digi-Key | SMAJ58A-13-FDICT-ND | TVS DIODE 58V 93.6V SMA |  |  | 1
184 | SMBJ14A | 1 | VD22 | SMAJ12CA-13-F | Taiwan Semiconductor | SMBJ14A | Digi-Key | SMBJ14AFSCT-ND | 23.2V Clamp 25.9A Ipp Tvs Diode Surface Mount DO-214AA (SMB) | NF(VD22) | 1 | 0
185 | IRLML6244 | 2 | VT1, VT2 | SOT23-3 | Infineon Technologies | IRLML6244TRPBF | Digi-Key | IRLML6244TRPBFTR-ND | N-Channel 20V 6.3A (Ta) 1.3W (Ta) Surface Mount Micro3™/SOT-23 |  |  | 2
186 | FDMS86250 | 1 | VT3 | FDMS86250_NMOS_POWER56 | ON Semiconductor / Fairchild | FDMS86250 | Mouser | 512-FDMS86250 | MOSFET FET 150V 25.0 MOHM PQFN56 |  |  | 1
187 | BFT92,215 | 1 | VT4 | BFT92,215_PNP_STO23-3 | NXP Semiconductors | BFT92215 | Digi-Key | 568-1655-1-ND | RF TRANS PNP 15V 5GHZ TO236AB |  |  | 1
188 | U7475LF 30.72MHz | 1 | XO1 | AOCJYR-10.000MHz | Rakon | U7475LF 30.72MHz | Rakon | U7475LF | ROM9070SA 30.72MHz MERC+ 9x7 HOT RC2.5 3.3V PULL |  |  | 1
189 | E6245LF 30.72 MHz | 2 | XO2, XO7 | RAKON_RPT7050A | Rakon | E6245LF | Rakon | E6245LF | TCXO 30.72MHz, E6245LF | NF(XO2 XO7) | 2 | 0
190 | E5280LF 30.72MHz | 2 | XO3, XO8 | RAKON_TXCO | Rakon | E5280LF | Rakon | E5280LF | TCXO 30.72MHz, E5280LF | NF(XO3 XO8) | 2 | 0
191 | RTX5032A, 40.00MHz | 2 | XO4, XO9 | RAKON_RTX5032A | Rakon | RTX5032A | RAKON | RTX5032A | RTX5032A 40MHz, High performance TCXO, With VC, Filter Enabled, 10-pin 5mm x 3.2 mm x 1.65 mm package | NF(XO4 XO9) | 2 | 0
192 | ASVTX-12 38.4MHz | 2 | XO5, XO10 | CRYSTAL_4-LCC_2P5x2P0 | Abracon | ASVTX-12-A-38.400MHZ-H10-T | Digi-Key | 535-11790-1-ND | 38.4MHz VCTCXO Clipped Sine Wave Oscillator 3V 4-SMD, No Lead | NF(XO5 XO10) | 2 | 0
193 | U8073LF 10.0MHz | 1 | XO6 | AOCJYR-10.000MHz | Rakon | U8073LF | Rakon | U8073LF | ROM9070PA 10.0MHz MERC+ 9x7 HOT CMOS 3.3V PULL |  |  | 1
194 | 32.768kHz | 1 | XT1 | CRYSTAL_2PIN_RTC_RT3215 | Raltron Electronics | RT3215-32.768-12.5-TR-10PPM | Digi-Key | 2151-RT3215-32.768-12.5-TR-10PPMTR-ND | 32.768 kHz ±10ppm Crystal 12.5pF 70 kOhms 2-SMD, No Lead |  |  | 1
195 | 24MHz | 1 | XT2 | CRYSTAL_4-LCC | Abracon | ABM8-24.000MHZ-D1G-T | Digi-Key | 535-14395-1-ND | 24 MHz ±10ppm Crystal 18pF 50 Ohms 4-SMD, No Lead |  |  | 1
 |  |  |  |  |  |  |  |  |  |  | 200 | Total NF element number: 200
 |  |  |  |  |  |  |  |  |  |  |  | All NF elements in one row:
 |  |  |  |  |  |  |  |  |  |  |  | NF(BATT2 C18 C29 C31 C90 C95 C100 C115 C122 C130 C131 C143 C153 C159 C166 C173 C181 C182 C185 C186 C191 C193 C244 C245 C246 C247 C300 C30 C116 C121 C132 C133 C152 C167 C172 C183 C184 C6 C7 C8 C303 C312 C123 C174 C257 C262 C294 C283 C295 ESD34 R6 R241 R242 FR17 FR19 FR21 IC9 IC11 IC15 IC21 IC22 IC31 IC37 IC35 IC38 IC41 J5 J6 J25 J11 J17 J13 J18 J19 J27 J20 J29 J43 J58 JMP1 LED8 LED9 R1 R2 R4 R8 R9 R10 R11 R12 R13 R17 R18 R21 R22 R24 R28 R32 R75 R77 R79 R80 R84 R86 R88 R104 R106 R111 R114 R115 R128 R133 R140 R141 R144 R145 R147 R150 R152 R153 R155 R156 R159 R161 R169 R171 R172 R175 R177 R208 R210 R212 R215 R217 R218 R221 R222 R226 R228 R230 R231 R233 R234 R235 R236 R243 R244 R245 R246 R291 R317 R321 R87 R237 R238 R239 R240 R48 R49 R50 R66 R131 R135 R137 R190 R194 R199 R293 R295 R126 R278 R292 R44 R185 R196 R51 R170 R173 R176 R178 R179 R209 R213 R216 R267 R174 R214 R301 R306 R307 VD9 VD22 XO2 XO7 XO3 XO8 XO4 XO9 XO5 XO10)
 |  |  |  |  |  |  |  |  |  |  |  | All FIT elements in one row:
 |  |  |  |  |  |  |  |  |  |  |  | FIT(C1 C2 C9 C10 C11 C13 C14 C15 C17 C19 C20 C21 C23 C24 C27 C32 C33 C35 C36 C37 C38 C39 C40 C41 C42 C43 C44 C45 C46 C47 C48 C49 C50 C51 C52 C54 C56 C58 C60 C61 C63 C65 C67 C70 C71 C75 C77 C78 C79 C80 C81 C82 C84 C85 C88 C93 C97 C98 C99 C101 C102 C103 C104 C105 C106 C107 C108 C109 C112 C113 C114 C118 C125 C134 C135 C141 C147 C149 C160 C163 C164 C165 C169 C176 C192 C194 C195 C196 C202 C204 C224 C226 C240 C241 C242 C243 C250 C251 C275 C276 C279 C291 C299 C3 C16 C26 C34 C68 C69 C74 C76 C83 C87 C92 C96 C117 C124 C140 C168 C175 C188 C200 C201 C220 C221 C236 C237 C238 C239 C248 C249 C273 C274 C287 C296 C4 C5 C22 C25 C86 C89 C91 C94 C72 C73 C154 C155 C156 C158 C187 C28 C53 C55 C57 C59 C62 C64 C66 C301 C302 C304 C305 C306 C307 C308 C309 C310 C311 C259 C280 C284 C292 C261 C281 C282 C293 ESD1 ESD2 ESD3 ESD4 ESD5 ESD6 ESD7 ESD8 ESD9 ESD10 ESD11 ESD12 ESD13 ESD14 ESD15 ESD16 ESD17 ESD18 ESD19 ESD20 ESD21 ESD22 ESD23 ESD24 ESD25 ESD26 ESD27 ESD28 ESD29 ESD30 ESD31 ESD32 ESD33 ESD35 ESD36 ESD37 ESD38 F9 F10 R299 FR1 FR4 FR9 FR13 FR14 FR15 FR16 FR18 FR20 J38 J39 J40 J41 J42 J53 J24 J55 J56 JMP2 JMP3 JMP4 JMP5 JMP6 JMP7 JMP8 R3 R5 R7 R20 R39 R82 R90 R94 R96 R97 R98 R99 R100 R103 R105 R107 R108 R116 R119 R121 R125 R127 R129 R134 R142 R143 R146 R149 R154 R158 R165 R166 R167 R181 R186 R204 R205 R207 R211 R219 R223 R224 R225 R229 R232 R270 R296 R297 R313 R14 R83 R247 R248 R249 R250 R302 R309 R15 R23 R25 R27 R40 R46 R53 R54 R55 R56 R57 R58 R69 R74 R102 R109 R110 R113 R117 R118 R120 R123 R130 R1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
 |  |  |  |  |  |  |  |  |  |  |  | *NOTE: NF(R1 R2) means that elements R1 and R2 are unpopulated (NF)
