myriadrf/LimePSB-RPCM/hardware/1v0/Project Outputs for LimeKEY-RPCM_1v0/LimeKEY-RPCM_1v0_PCBspecs_r0.PDF

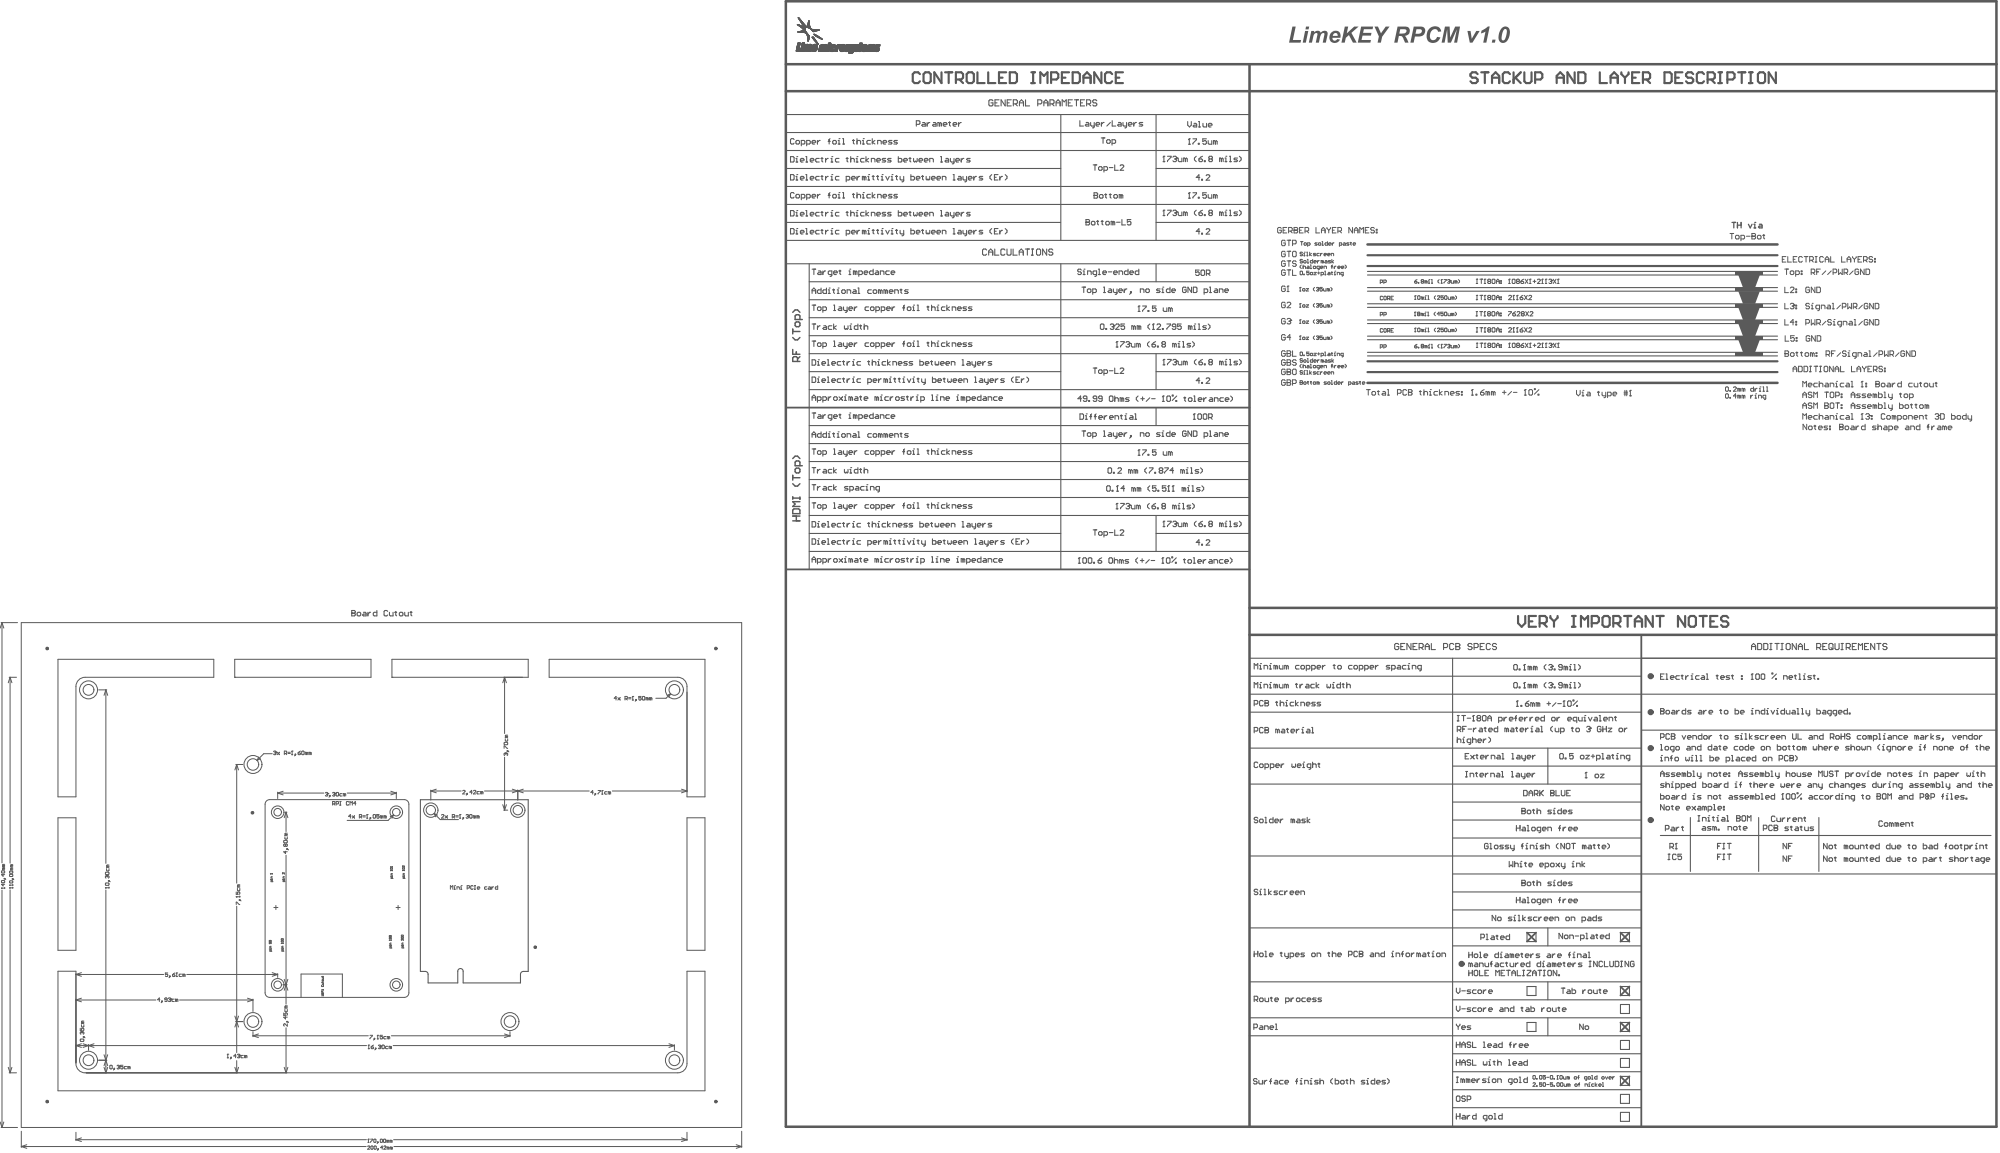
[picture p1: page 1]
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
