myriadrf/LimePSB-RPCM/(list of files, drawings)

Other design files:
hardware/1v0/LimeKEY-RPCM_1v0.PrjPcb
hardware/1v0/Schematics/01_Block_diag.SchDoc
hardware/1v0/Schematics/02_Power_diag.SchDoc
hardware/1v0/Schematics/03_Clock_diag.SchDoc
hardware/1v0/Schematics/04_RFFE_diag.SchDoc
hardware/1v0/Schematics/05_RPi_mPCIe.SchDoc
hardware/1v0/Schematics/06_Misc_1.SchDoc
hardware/1v0/Schematics/07_Misc_2.SchDoc
hardware/1v0/Schematics/08_USB.SchDoc
hardware/1v0/Schematics/09_Clock.SchDoc
hardware/1v0/Schematics/10_RFFE.SchDoc
hardware/1v0/Schematics/11_PoE_USB_PD.SchDoc
hardware/1v0/Schematics/12_Power.SchDoc
hardware/1v1/LimeKEY-RPCM_1v1.PrjPcb
hardware/1v1/Schematics/01_Block_diag.SchDoc
hardware/1v1/Schematics/02_Power_RFFE_diag.SchDoc
hardware/1v1/Schematics/03_Clock_diag.SchDoc
hardware/1v1/Schematics/04_USB_diag.SchDoc
hardware/1v1/Schematics/05_RPi_mPCIe.SchDoc
hardware/1v1/Schematics/06_Misc_1.SchDoc
hardware/1v1/Schematics/07_Misc_2.SchDoc
hardware/1v1/Schematics/08_USB.SchDoc
hardware/1v1/Schematics/09_Clock.SchDoc
hardware/1v1/Schematics/10_RFFE.SchDoc
hardware/1v1/Schematics/11_PoE_USB_PD.SchDoc
hardware/1v1/Schematics/12_Power.SchDoc
hardware/1v2/LimeKEY-RPCM_1v2.PrjPcb
hardware/1v2/LimePSB-RPCM_1v2.PrjPcb
hardware/1v2/Schematics/05_RPi_mPCIe.SchDoc
hardware/1v2/Schematics/06_Misc_1.SchDoc
hardware/1v2/Schematics/07_Misc_2.SchDoc
hardware/1v2/Schematics/08_USB_hub.SchDoc
hardware/1v3/LimePSB-RPCM_1v3.PrjPcb
hardware/1v4/LimePSB-RPCM_1v4.PrjPcb
hardware/1v5/LimePSB-RPCM_1v5.PrjPcb
hardware/1v5/Schematics/01_Block_diag.SchDoc
hardware/1v5/Schematics/02_Power_RFFE_diag.SchDoc
hardware/1v5/Schematics/03_Clock_diag.SchDoc
hardware/1v5/Schematics/04_USB_diag.SchDoc
hardware/1v5/Schematics/05_RPi_mPCIe.SchDoc
hardware/1v5/Schematics/06_Misc_1.SchDoc
hardware/1v5/Schematics/07_Misc_2.SchDoc
hardware/1v5/Schematics/08_FPGA.SchDoc
hardware/1v5/Schematics/09_USB_hub.SchDoc
hardware/1v5/Schematics/10_USB_HDMI.SchDoc
hardware/1v5/Schematics/11_Clock_1.SchDoc
hardware/1v5/Schematics/12_Clock_2.SchDoc
hardware/1v5/Schematics/13_RFFE.SchDoc
hardware/1v5/Schematics/14_RFPD_PoE_USB_PD.SchDoc
hardware/1v5/Schematics/15_Power.SchDoc
