myriadrf/LimePSB-RPCM/(commit log)

2022-10-20 Initial commit.
    [01_Block_diag.SchDoc, 02_Power_diag.SchDoc, 03_Clock_diag.SchDoc, 04_RFFE_diag.SchDoc, 05_RPi_mPCIe.SchDoc, 06_Misc_1.SchDoc, 07_Misc_2.SchDoc, 08_USB.SchDoc]
2023-03-10 Folder structure changed.
    [01_Block_diag.SchDoc, 02_Power_diag.SchDoc, 03_Clock_diag.SchDoc, 04_RFFE_diag.SchDoc, 05_RPi_mPCIe.SchDoc, 06_Misc_1.SchDoc, 07_Misc_2.SchDoc, 08_USB.SchDoc]
2023-03-10 Version 1v1 added.
    [01_Block_diag.SchDoc, 02_Power_RFFE_diag.SchDoc, 03_Clock_diag.SchDoc, 04_USB_diag.SchDoc, 05_RPi_mPCIe.SchDoc, 06_Misc_1.SchDoc, 07_Misc_2.SchDoc, 08_USB.SchDoc]
2024-02-22 Initial Altium project commit for v1.2 hardware
    [01_Block_diag.SchDoc, 02_Power_RFFE_diag.SchDoc, 03_Clock_diag.SchDoc, 04_USB_diag.SchDoc, 05_RPi_mPCIe.SchDoc, 06_Misc_1.SchDoc, 07_Misc_2.SchDoc, 08_USB.SchDoc]
2024-02-22 Removed local libraries
    [LimeKEY-RPCM_1v2.PrjPcb]
2024-02-22 Connected RPI_SYNC_IN_LS and RPI_FAN_TACHO to RPI_PIN16 via 0R resistors
    [05_RPi_mPCIe.SchDoc]
2024-02-22 Connected RPI_FAN_TACHO to 4-pin fan connector
    [07_Misc_2.SchDoc]
2024-02-22 Connected RPI_FAN_TACHO and RPI_FAN_PWM to 4-pin fan connector
    [07_Misc_2.SchDoc]
2024-02-22 Connected RPI_VBAT
    [05_RPi_mPCIe.SchDoc]
2024-02-22 Connected RPI_VBAT to coin cell via 0R
    [07_Misc_2.SchDoc]
2024-02-26 Added ESD fot INT_TO_EXT SMA connector
    [07_Misc_2.SchDoc]
2024-02-28 Added 0R for RPI_GLOBAL_EN (PMIC_ENABLE)
    [07_Misc_2.SchDoc]
2024-02-28 Connected RPI_PCIE_DET_nWAKE to mPCIe pin 1 via 0R resistor
    [05_RPi_mPCIe.SchDoc]
2024-02-29 Added library submodule to altium project
    [LimeKEY-RPCM_1v2.PrjPcb]
2024-02-29 Added temp sheet
    [13_Temp.SchDoc, LimeKEY-RPCM_1v2.PrjPcb]
2024-02-29 Added ESD note
    [13_Temp.SchDoc]
2024-02-29 Renamed HDMI0_HOTPLUG, HDMI1_HOTPLUG to HDMI0_HPD, HDMI1_HPD
    [05_RPi_mPCIe.SchDoc, 06_Misc_1.SchDoc, 13_Temp.SchDoc]
2024-02-29 Updated lib, Added dual USB3 socket
    [13_Temp.SchDoc]
2024-02-29 Connected RPI_USB3 ports 0 and 1 to CM5
    [05_RPi_mPCIe.SchDoc]
2024-02-29 Connected USB3 socket
    [13_Temp.SchDoc]
2024-02-29 Remove note for usb2 socket
    [08_USB.SchDoc]
2024-02-29 Connected power to USB3 socket
    [13_Temp.SchDoc]
2024-02-29 Added capacitor for PCIE_CLK
    [05_RPi_mPCIe.SchDoc]
2024-02-29 USB3 ESD note
    [13_Temp.SchDoc]
2024-03-05 Diagrams that do not conform to the scheme are marked
    [01_Block_diag.SchDoc, 02_Power_RFFE_diag.SchDoc, 03_Clock_diag.SchDoc, 04_USB_diag.SchDoc]
2024-03-20 Rename project files from LimeKEY-RPCM to LimePSB-RPCM, changed project structure
    [LimePSB-RPCM_1v2.PrjPcb]
2024-03-20 Added FUSB340TMX
    [13_Temp.SchDoc]
2024-03-20 Connected RPI_USB3 1 to FUSB
    [13_Temp.SchDoc]
2024-03-20 Added FSUSB42 for RPI_USB3_D1
    [13_Temp.SchDoc]
2024-03-20 Changed FSUSB42UMX connections
    [13_Temp.SchDoc]
2024-03-20 Cosmetic FSUSB42UMX
    [08_USB.SchDoc]
2024-03-20 Connected FSUSB42UMX HSD1 to USB hub
    [13_Temp.SchDoc]
2024-03-20 Connected USB3 socket lines
    [13_Temp.SchDoc]
2024-03-20 Renamed VCC5P0_USBE to VCC5P0_USBS
    [08_USB.SchDoc, 13_Temp.SchDoc]
2024-03-20 Fully connected USB3S_B
    [13_Temp.SchDoc]
2024-03-20 Added USB switches for USB3 socket
    [13_Temp.SchDoc]
2024-03-20 Added bypass option for USB_HUB_D0 and PCIE_USB port
    [08_USB.SchDoc]
2024-03-21 Added EN_CM5_USB3 note
    [13_Temp.SchDoc]
2024-03-21 Disconnected RPI_FAN_PWM
    [05_RPi_mPCIe.SchDoc]
2024-03-21 Disconnected RPI_FAN_TACHO
    [05_RPi_mPCIe.SchDoc, 07_Misc_2.SchDoc]
2024-03-21 Added fan note
    [13_Temp.SchDoc]
2024-03-21 page 10 IC32 and IC33 changed
    [10_RFFE.SchDoc]
2024-03-26 Added ESDs for Dual USB 3.0 socket
    [13_Temp.SchDoc]
2024-03-26 Removed Dual USB 2.0 (type A) socket and ESDs
    [08_USB.SchDoc]
2024-03-26 SYNC_IN_LS renamed to RPI_PIN16, SYNC_OUT_LS renamed to RPI_PIN18.
    [05_RPi_mPCIe.SchDoc]
2024-03-26 Added PTP_SYNC_SEL mux
    [13_Temp.SchDoc]
2024-03-27 Connected RPI_RUN_PG (PWR_Button) to J14 pin 10 instead GND. Added related note.
    [06_Misc_1.SchDoc]
2024-03-27 Connected EMC2301 fan controller
    [13_Temp.SchDoc]
2024-03-27 Deleted old fan control circuit
    [07_Misc_2.SchDoc]
2024-03-27 RPI_TVDAC renamed to CVIDEO
    [06_Misc_1.SchDoc]
2024-03-27 Connected analog mux 74LVC1G3157FZ4 between RPI_TVDAC and CVIDEO
    [13_Temp.SchDoc]
2024-03-27 Added jumper for CM4/CM5 ID
    [13_Temp.SchDoc]
2024-03-27 Added pull down for PTP_SYNC_SEL
    [13_Temp.SchDoc]
2024-03-27 Connected PTP_SYNC_SEL to SR1
    [07_Misc_2.SchDoc]
2024-03-27 Added dip switches
    [13_Temp.SchDoc]
2024-03-28 Reannotated and pushed to PCB
    [05_RPi_mPCIe.SchDoc, 07_Misc_2.SchDoc, 08_USB.SchDoc, 13_Temp.SchDoc]
2024-03-28 PCB updated, errors marked on page 13
    [13_Temp.SchDoc]
2024-03-29 pcb updated
2024-03-29 PCB and OutputJobs updated
2024-04-02 Reconnected USB3 ports
    [13_Temp.SchDoc]
2024-04-02 Added RPI_PIN18 - RPI_SYNC_OUT_LS, RPI_PIN16 - RPI_SYNC_IN_LS bypass option
    [13_Temp.SchDoc]
2024-04-02 Moved RPI_PIN16 - RPI_SYNC_IN_LS bypass option to other sheet.
    [05_RPi_mPCIe.SchDoc]
2024-04-02 Mirrored IC50
    [13_Temp.SchDoc]
2024-04-02 Renamed CVIDEO to RPI_TVDAC
    [06_Misc_1.SchDoc]
2024-04-02 J14 pin 11 connected to RPI_PIN11 instead RPI_TVDAC
    [06_Misc_1.SchDoc]
2024-04-02 Connected RPI_VBUS_EN IC24 as optional EN control source
    [08_USB.SchDoc]
2024-04-02 Connected RPI_VBUS_EN to IC50 B1 channel
    [13_Temp.SchDoc]
2024-04-02 Added ideas for 4 bit switch
    [13_Temp.SchDoc]
2024-04-02 Annotation updated and pushed to PCB
    [08_USB.SchDoc, 13_Temp.SchDoc]
2024-04-02 annotation updated
    [13_Temp.SchDoc]
2024-04-03 IC50 VCC connection fixed
    [13_Temp.SchDoc]
2024-04-03 USB3 net class added
    [13_Temp.SchDoc]
2024-04-03 USB3_RPI net class added
    [13_Temp.SchDoc]
2024-04-03 cosmetic on page 13_Temp
    [13_Temp.SchDoc]
2024-04-03 Renamed USB3 classes
    [13_Temp.SchDoc]
2024-04-03 Moved HDMI to other sheet
    [06_Misc_1.SchDoc]
2024-04-03 Moved HDMi ESD to other sheet
    [13_Temp.SchDoc]
2024-04-03 Added misc3
    [13_Temp.SchDoc, 14_Misc3.SchDoc, LimePSB-RPCM_1v2.PrjPcb]
2024-04-03 Moved RPI_PIN11 mux from temp sheet to RPi sheet
    [05_RPi_mPCIe.SchDoc]
2024-04-03 Moved RPI_SYNC mux from temp to clock sheet
    [09_Clock.SchDoc]
2024-04-03 Moved FAN control from temt to misc2 sheet
    [07_Misc_2.SchDoc]
2024-04-03 Connected RPI_VBUS_EN to VCC5P0_USBS power switch
    [08_USB.SchDoc]
2024-04-03 Moved buzzer rpi_btn
    [06_Misc_1.SchDoc]
2024-04-03 Moved dip switch
    [06_Misc_1.SchDoc]
2024-04-03 Cleaned sheet
    [14_Misc3.SchDoc]
2024-04-03 Moved HDMI
    [13_Temp.SchDoc]
2024-04-03 Changed project structure
    [08_Misc_3.SchDoc, 09_USB.SchDoc, 10_Clock.SchDoc, 11_RFFE.SchDoc, 12_PoE_USB_PD.SchDoc, 13_Power.SchDoc, 14_Misc3.SchDoc, LimePSB-RPCM_1v2.PrjPcb]
2024-04-03 PCB updated after project updates
2024-04-04 Added USB_C_RPI1 and USB_C_RPI2 net labels
    [08_USB_hub.SchDoc]
2024-04-04 Added net label USB_PD_I
    [12_PoE_USB_PD.SchDoc]
2024-04-04 Moved EN_CM5_USB3
    [09_USB_HDMI.SchDoc]
2024-04-04 Removed SW1, connnected 4 bit dip switch
    [06_Misc_1.SchDoc]
2024-04-04 Changed SYNC voltage converters VCCA from VCC1P8_RPI to VCC3P3
    [06_Misc_1.SchDoc]
2024-04-05 PCB cosmetic changes
2024-04-05 IC32 and IC33 symbol pin changes
    pin PAD (GND) type changed from output to passive
    [11_RFFE.SchDoc]
2024-04-08 Added todo for FSUSB42UMX
    [08_USB_hub.SchDoc]
2024-04-08 Changed SYNC voltage converters VCCA from VCC1P8_RPI to VCC3P3. Fited bypass resistors, NF other components.
    [06_Misc_1.SchDoc]
2024-04-08 PCB cosmetics
2024-04-08 Fitted ESDs or RF SMA conenctors
    [11_RFFE.SchDoc]
2024-04-09 Swapped SW bits 1 and 2
    [06_Misc_1.SchDoc]
2024-04-09 Swapped SW2 bits 1 and 2
    [06_Misc_1.SchDoc]
2024-04-10 Adding XO info
    [10_Clock.SchDoc]
2024-04-10 R257 NF
    [05_RPi_mPCIe.SchDoc]
2024-04-10 Changed VCC_FAN to VCC_INT (12V)
    [07_Misc_2.SchDoc]
2024-04-10 Changes R263 and R264 values
    [07_Misc_2.SchDoc]
2024-04-10 Reannotated whole project
    [01_Block_diag.SchDoc, 02_Power_RFFE_diag.SchDoc, 03_Clock_diag.SchDoc, 04_USB_diag.SchDoc, 05_RPi_mPCIe.SchDoc, 06_Misc_1.SchDoc, 07_Misc_2.SchDoc, 08_USB_hub.SchDoc]
2024-04-11 Changed FSUSB42UMX to NX3DV42GU,115 due stock absence.
    [08_USB_hub.SchDoc]
2024-04-11 Added XO info
    [10_Clock.SchDoc]
2024-04-11 Updated DIP switch notes
    [06_Misc_1.SchDoc]
2024-04-11 Updated sheet numbers and version
    [01_Block_diag.SchDoc, 02_Power_RFFE_diag.SchDoc, 03_Clock_diag.SchDoc, 04_USB_diag.SchDoc, 05_RPi_mPCIe.SchDoc, 06_Misc_1.SchDoc, 07_Misc_2.SchDoc, 08_USB_hub.SchDoc]
2024-04-11 Changed sheet title
    [05_RPi_mPCIe.SchDoc]
2024-04-11 Added VCC5P0_USBS no erc
    [09_USB_HDMI.SchDoc]
2024-04-11 Changed CM4/5 connector from DF40C-100DS-0.4V(51) to 10164227-1001A1RLF. New connector supports higher current (old 0.25A, new 0.3A per contact).
    [05_RPi_mPCIe.SchDoc]
2024-04-15 Updated RUN_PG note
    [05_RPi_mPCIe.SchDoc]
2024-04-15 Update LimePSB-RPCM_1v2.PCBDwf
    Imported updated PCB
2024-04-16 Fited 2.5V voltage reference
    [13_Power.SchDoc]
2024-04-16 Selected VCC2P5_VREF as source for XO DAC (R165 fit, R166, R172, C139, C140 NF)
    [10_Clock.SchDoc]
2024-04-16 Selected VCC2P5_VREF as source for ADC (R48 fit, R45, R49, C34, C35 NF)
    [07_Misc_2.SchDoc]
2024-04-16 J26 and JMP1 NF (dublicates function with dip switch)
    [08_USB_hub.SchDoc]
2024-04-16 J48 and JMP7 NF (dublicates function with dip switch)
    [12_PoE_USB_PD.SchDoc]
2024-04-16 Updated diagram
    [01_Block_diag.SchDoc]
2024-04-16 NFs updated
    [05_RPi_mPCIe.SchDoc, 06_Misc_1.SchDoc, 07_Misc_2.SchDoc, 08_USB_hub.SchDoc, 09_USB_HDMI.SchDoc, 10_Clock.SchDoc, 11_RFFE.SchDoc, 12_PoE_USB_PD.SchDoc]
2024-04-17 Updated diagrams
    [01_Block_diag.SchDoc]
2024-04-17 Imported PCB changes, hid designators
2024-04-17 Removed changes marking and notes
    [05_RPi_mPCIe.SchDoc]
2024-04-18 DFM generated
    [06_Misc_1.SchDoc, 13_Power.SchDoc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]
2024-08-28 Initial 1v3 commit
    [01_Block_diag.SchDoc, 02_Power_RFFE_diag.SchDoc, 03_Clock_diag.SchDoc, 04_USB_diag.SchDoc, 05_RPi_mPCIe.SchDoc, 06_Misc_1.SchDoc, 07_Misc_2.SchDoc, 08_USB_hub.SchDoc]
2024-09-02 Added temp sheet for FPGA
    [14_Temp.SchDoc, LimePSB-RPCM_1v3.PrjPcb]
2024-09-02 FPGA ideas
    [06_Misc_1.SchDoc]
2024-09-02 Update 07_Misc_2.SchDoc
    FPGA ideas
    [07_Misc_2.SchDoc]
2024-09-02 Change PoE?
    [12_PoE_USB_PD.SchDoc]
2024-09-02 Connecting FPGA power
    [14_Temp.SchDoc]
2024-09-02 Added VCC1P2 LDO
    [14_Temp.SchDoc]
2024-09-02 Added VCC2P5_FPGA power
    [14_Temp.SchDoc]
2024-09-02 Added VCC2P5 LDO
    [14_Temp.SchDoc]
2024-09-02 Connected LMK_CLK_OUT4 to FPGA GBIN
    [10_Clock.SchDoc]
2024-09-02 Added diode note and marked GBIN pins
    [14_Temp.SchDoc]
2024-09-02 Connected flash
    [14_Temp.SchDoc]
2024-09-04 Add PLL note
    [10_Clock.SchDoc]
2024-09-10 Updated schematic file (Missed 08_USB_hub sheet)
2024-09-10 Adding FPGA pins to sheet
    [14_Temp.SchDoc]
2024-09-11 Conected FPGA CDONE and CRESET
    [14_Temp.SchDoc]
2024-09-11 Added bypass option for RPI_PIN11
    [05_RPi_mPCIe.SchDoc]
2024-09-11 Added SR pins
    [14_Temp.SchDoc]
2024-09-13 FPGA pins
    [14_Temp.SchDoc]
2024-09-13 TDD control ideas
    [07_Misc_2.SchDoc]
2024-09-13 PCIE_UIM8 added
    [14_Temp.SchDoc]
2024-09-13 Disconnected RPI_RF_SW_TDD and PCIE_UIM8 from RF_SW_TDD and connected FPGA_RF_SW_TDD.
    [07_Misc_2.SchDoc]
2024-09-13 Added RPI_RF_SW_TDD free note
    [05_RPi_mPCIe.SchDoc]
2024-09-13 Added SPI interfaces info
    [14_Temp.SchDoc]
2024-09-13 Added RPI SS info
    [05_RPi_mPCIe.SchDoc]
2024-09-16 Removed shift registers
    [07_Misc_2.SchDoc]
2024-09-16 Changed shift registers to I2C I/O expander (MCP23017) because there was not enough SS pins on RPi
    [07_Misc_2.SchDoc]
2024-09-17 Corrected FAN controller I2C address note
    [07_Misc_2.SchDoc]
2024-09-18 Changed GNSS components IDs to ? and changed 10R 5% to 1%
    [14_Temp.SchDoc]
2024-09-18 Connected GNSS USB to USB HUB port 6 via 0R
    [08_USB_hub.SchDoc]
2024-09-18 RPI UART
    [14_Temp.SchDoc]
2024-09-18 Connected VCC_VBAT to coin cell
    [07_Misc_2.SchDoc]
2024-09-18 Connected VCC3P0_BATT to coin cell
    [07_Misc_2.SchDoc]
2024-09-18 Connected RPI_UART0 to GNSS_UART
    [14_Temp.SchDoc]
2024-09-19 Added new sheet (15_Temp)
    [LimePSB-RPCM_1v3.PrjPcb]
2024-09-19 Added 10 MHz OCXO + clk buff
    [15_Temp.SchDoc]
2024-09-19 Added analog mux
    [15_Temp.SchDoc]
2024-09-19 Renamed PTP XO to XO10 nets
    [15_Temp.SchDoc]
2024-09-19 TCXO DAC output disconnected from XO_VC and renamed to TCXO_DAC net
    [10_Clock.SchDoc]
2024-09-19 Added LMK10_CLK_OUT0 to CLK in group
    [14_Temp.SchDoc]
2024-09-19 Changed J34 layout, added LMK10_CLK_OUT3
    [10_Clock.SchDoc]
2024-09-19 Added TCXO_DAC mux for XO10_VC and XO_VC
    [15_Temp.SchDoc]
2024-09-19 J36 pin 1 instead RPI_SYNC_OUT conected to LMK10_CLK_OUT2
    [10_Clock.SchDoc]
2024-09-23 Added linear regulator for VCC3P3_CLK2
    [15_Temp.SchDoc]
2024-09-23 Changed VCC3P3_CLK to VCC3P3_CLK2
    [15_Temp.SchDoc]
2024-09-23 Updated RPi SS notes
    [05_RPi_mPCIe.SchDoc]
2024-09-23 Added FPGA VCCIO bank voltage rail info
    [14_Temp.SchDoc]
2024-09-23 Swapped FPGA_CFG_SPI_SCK and FPGA_CFG_SPI_CSN
    [14_Temp.SchDoc]
2024-09-23 Changed FPGA SPIs
    [14_Temp.SchDoc]
2024-09-23 Added MAsterSPI and Slave SPI configuration resistors
    [14_Temp.SchDoc]
2024-09-23 Changed SPI interfaces note
    [05_RPi_mPCIe.SchDoc]
2024-09-23 Disconnected ADF_MUXOUT from RPi GPIO3 and connected RPI_SPI1_SS2 (XO DAC SS)
    [05_RPi_mPCIe.SchDoc]
2024-09-23 Disconnected RPI_RF_SW_TDD from RPi GPIO6 and connected PCIE_LED_WWAN
    [05_RPi_mPCIe.SchDoc]
2024-09-24 Added FPGA_GPIOn net
    [14_Temp.SchDoc]
2024-09-24 Added EMC2301 CLK pull up for fan default drive setting decode
    [07_Misc_2.SchDoc]
2024-09-24 Added EMC2301 PWM pull up
    [07_Misc_2.SchDoc]
2024-09-24 Added BOM_VER, HW_VER
    [14_Temp.SchDoc]
2024-09-24 Conencted FPGA_GPIO0 and FPGA_GPIO1 to J10 pins 10 and 12 instead GND pins
    [06_Misc_1.SchDoc]
2024-09-24 Connected FPGA_I2C_SCL, FPGA_I2C_SDA to RPI_I2C0_SCL, RPI_I2C0_SDA via 0R resistors
    [14_Temp.SchDoc]
2024-09-24 Removed RPi and GNSS UART direct connections
    [14_Temp.SchDoc]
2024-09-24 Connected FPGA_CRESET to IO I2C expander
    [07_Misc_2.SchDoc]
2024-09-24 Updated divider for VCC2P5
    [14_Temp.SchDoc]
2024-09-24 Changed FPGA configuration mode to Slave SPI
    [14_Temp.SchDoc]
2024-09-24 Changed VCC1P2_FPGA 100R package to 0603
    [14_Temp.SchDoc]
2024-09-25 Updated VCC3P3_CLK2 net class
    [15_Temp.SchDoc]
2024-09-25 Moved Misc for FAN to temp sheet
    [13_Power.SchDoc]
2024-09-25 Moved Misc for FAN from power sheet
    [15_Temp.SchDoc]
2024-09-25 Moved LDOs from temp sheets
    [13_Power.SchDoc]
2024-09-25 Moved LDOs to power sheet
    [14_Temp.SchDoc]
2024-09-25 Moved GNSS to Temp2 sheet
    [14_Temp.SchDoc]
2024-09-25 Moved GNSS to Temp2 sheet from Temp 1
    [15_Temp.SchDoc]
2024-09-25 Parts fitted to PCB, layout updated
2024-09-25 Connected FPGA_CDONE to IO I2C expander
    [07_Misc_2.SchDoc]
2024-09-25 Connected VCCIO_0, VCCIO_1, VCCIO_2 to VCC3P3
    [14_Temp.SchDoc]
2024-09-25 Connected FPGA_CRESET, FPGA_CDONE to header
    [14_Temp.SchDoc]
2024-09-26 Changed RPI_SYNC_OUT to SYNC_OUT on J34 and J37
    [10_Clock.SchDoc]
2024-09-26 Added new header for RPI_SYNC_OUT/FPGA_SYNC_OUT path selection to SYNC_OUT
    [10_Clock.SchDoc]
2024-09-26 FPGA pinout updated
    [14_Temp.SchDoc]
2024-09-26 Updated FPGA pinout and layout
    [14_Temp.SchDoc]
2024-09-26 Connected XO DAC SPI to FPGA_SPI1
    [10_Clock.SchDoc]
2024-09-26 Renamed FPGA_SPI1 to FPGA_SPI0
    [10_Clock.SchDoc, 14_Temp.SchDoc]
2024-09-26 Connected IC3 pin 3 to FPGA_SPI0_SCLK_R
    [10_Clock.SchDoc]
2024-09-26 Connected XO DAC to FPGA_SPI0
    [10_Clock.SchDoc]
2024-09-26 Red line on diagrams
    [01_Block_diag.SchDoc, 02_Power_RFFE_diag.SchDoc, 03_Clock_diag.SchDoc, 04_USB_diag.SchDoc]
2024-09-26 20 pin header added, output jobs updated, initial DRC
    [08_USB_hub.SchDoc]
2024-09-27 Updated FPGA flash notes
    [14_Temp.SchDoc]
2024-09-27 Disconnected USB socket top from USB3 and connected to USB2
    [09_USB_HDMI.SchDoc]
2024-09-27 Connected USB3 header
    [08_USB_hub.SchDoc]
2024-09-27 USB2.0 header J27 was replaced with USB3.0 header. One USB3 port from dual USB3 socket was connected to new USB3 header. One USB2 port from old USB2.0 header was connected instead one USB3 on dual US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
    [09_USB_HDMI.SchDoc]
2024-09-27 Renamed VCC5P0_USBH to VCC5P0_USB3H Renamed USB3S_T_D_P/N to USB3H_1_D_P/N, USB3S_T_TX_P to USB3H_1_D_P/N, USB3S_T_RX_P to USB3H_1_D_P/N.
    [08_USB_hub.SchDoc]
2024-09-27 Renamed USB3S_T_D_P/N to USB3H_1_D_P/N, USB3S_T_TX_P to USB3H_1_D_P/N, USB3S_T_RX_P to USB3H_1_D_P/N.
    [09_USB_HDMI.SchDoc]
2024-09-27 PCB updated, local annotation
    [08_USB_hub.SchDoc, 10_Clock.SchDoc]
2024-09-30 Moved TCXO_DAC mux from 15_Temp to 10_Clock sheet
    [10_Clock.SchDoc, 15_Temp.SchDoc]
2024-09-30 Moved Misc for FANfrom 15_Temp to 14_Temp sheet
    [14_Temp.SchDoc, 15_Temp.SchDoc]
2024-09-30 Moved Clock config jumpers and RPI_SYNC mux from 10_Clock to 15_Temp sheet
    [10_Clock.SchDoc, 15_Temp.SchDoc]
2024-09-30 Moved RPI_SYNC level converters from 06_Misc_1 to 15_Temp sheet
    [06_Misc_1.SchDoc, 15_Temp.SchDoc]
2024-09-30 Changed project structure, Renamed sheet 14_Temp to 08_FPGA, Renamed sheet 15_Temp to 12_Clock2, Changed sheet numbers.
    Changed project structure
    Renamed sheet 14_Temp to 08_FPGA
    Renamed sheet 15_Temp to 12_Clock2
    Changed sheet numbers
    [08_FPGA.SchDoc, 09_USB_hub.SchDoc, 10_USB_HDMI.SchDoc, 11_Clock_1.SchDoc, 12_Clock_2.SchDoc, 13_RFFE.SchDoc, 14_PoE_USB_PD.SchDoc, 15_Power.SchDoc]
2024-09-30 Connected XO_VC_SEL instead FPGA_CDONE
    [07_Misc_2.SchDoc]
2024-09-30 Added rule
    [15_Power.SchDoc]
2024-09-30 Changed USB2.0 hub OCS and PRTPWR lines connections according to sapped USB poerts betweeen USB header and socket
    [09_USB_hub.SchDoc]
2024-09-30 marked USB3 header port1 and port2
    [09_USB_hub.SchDoc]
2024-10-01 IC61 clock buffer pin 5 NC (X)
    [12_Clock_2.SchDoc]
2024-10-01 (VC)TCXOs note
    [12_Clock_2.SchDoc]
2024-10-01 Renamed VCC3P3_LMK to VCC3P3_LMKRF and VCC3P3_LMK_VDDO to VCC3P3_LMKRF_VDDO
    [11_Clock_1.SchDoc]
2024-10-01 Fixed FPGA_CFG connections
    [08_FPGA.SchDoc]
2024-10-01 Added testpoints for FPGA_CFG
    [08_FPGA.SchDoc]
2024-10-01 CLKIN Note
    [08_FPGA.SchDoc]
2024-10-01 Renamed LMK_CLK_OUTn to LMKRF_CLK_OUTn
    [08_FPGA.SchDoc, 11_Clock_1.SchDoc, 12_Clock_2.SchDoc]
2024-10-02 Connected HW_VER
    [08_FPGA.SchDoc]
2024-10-02 FPGA pins 44, 3, 26 and 20 reconnected, layout updated
    [08_FPGA.SchDoc]
2024-10-02 Added SPI interfaces changes note
    [05_RPi_mPCIe.SchDoc]
2024-10-02 Renamed and fixed USB hub ports
    [09_USB_hub.SchDoc, 10_USB_HDMI.SchDoc]
2024-10-02 Layout updated, silkscreen cosmetics
2024-10-03 Updated VCC1P2 LDO voltage divider
    [15_Power.SchDoc]
2024-10-03 Added note for LDOs
    [15_Power.SchDoc]
2024-10-03 Added flash fotprint note
    [08_FPGA.SchDoc]
2024-10-03 PCB updated after reannotation. ERC, DRC clean
2024-10-03 Revision changed on all schematic sheets
    [01_Block_diag.SchDoc, 02_Power_RFFE_diag.SchDoc, 03_Clock_diag.SchDoc, 04_USB_diag.SchDoc, 05_RPi_mPCIe.SchDoc, 06_Misc_1.SchDoc, 07_Misc_2.SchDoc, 08_FPGA.SchDoc]
2024-10-03 Added FPGA flash part number
    [08_FPGA.SchDoc]
2024-10-03 R108 fit
    [08_FPGA.SchDoc]
2024-10-03 Updated FPGA configuration modes notes
    [08_FPGA.SchDoc]
2024-10-03 Changed FPGA configuration flash part number
    [08_FPGA.SchDoc]
2024-10-03 Changed C188 part number
    [12_Clock_2.SchDoc]
2024-10-07 Updated block diagram
    [01_Block_diag.SchDoc]
2024-10-07 Updated RFFE and power diagram
    [02_Power_RFFE_diag.SchDoc]
2024-10-07 Updated clock diagram
    [03_Clock_diag.SchDoc]
2024-10-07 Updated USB diagram
    [04_USB_diag.SchDoc]
2024-10-07 NFs added, schematic output job updated
    [05_RPi_mPCIe.SchDoc, 06_Misc_1.SchDoc, 07_Misc_2.SchDoc, 08_FPGA.SchDoc, 09_USB_hub.SchDoc, 10_USB_HDMI.SchDoc, 11_Clock_1.SchDoc, 12_Clock_2.SchDoc]
2024-10-08 Added 08_FPGA sheet to schematic output job
2024-10-08 Removed all changes markings
    [05_RPi_mPCIe.SchDoc, 06_Misc_1.SchDoc, 07_Misc_2.SchDoc, 09_USB_hub.SchDoc, 10_USB_HDMI.SchDoc, 11_Clock_1.SchDoc, 12_Clock_2.SchDoc, 15_Power.SchDoc]
2024-10-08 Imported PCB changes
2024-10-09 Updated DIP switch bit 4 note
    [06_Misc_1.SchDoc]
2024-10-09 Updated EN_CM5_USB3 note
    [10_USB_HDMI.SchDoc]
2024-10-09 NFs updated, sch with changes removed, BOM generated
    [12_Clock_2.SchDoc, 13_RFFE.SchDoc, LimePSB-RPCM_1v3_BOMr0.xls]
2024-10-09 Added XO VC DAC Mux label
    [11_Clock_1.SchDoc]
2024-10-09 BOM NFs checked
    [12_Clock_2.SchDoc]
2024-10-09 BOM created
    [LimePSB-RPCM_1v3_BOMr0.xls]
2024-10-09 Removed HW_VER0 from FPGA pin 39 and connected FPGA_LED_R to CDONE LED R via 330R resistor
    [08_FPGA.SchDoc]
2024-10-09 PCB checked for DB generation
    [LimePSB-RPCM_1v3_BOMr0.xls]
2024-10-10 Changed R65 from 10k to 1k (same as R71)
    [07_Misc_2.SchDoc]
2024-10-10 DFMr1 created
    rakon crystal thermal housing hole size increased from 0,9mm to 1,5mm. All new DFM files generated.
    [LimePSB-RPCM_1v3.GBL, LimePSB-RPCM_1v3.GBO, LimePSB-RPCM_1v3.GBP, LimePSB-RPCM_1v3.GBS, LimePSB-RPCM_1v3.GM1, LimePSB-RPCM_1v3.GTL, LimePSB-RPCM_1v3.GTO, LimePSB-RPCM_1v3.GTS]
2024-10-15 Fixed figure labels (board version changed to v1.1)
2024-10-15 Removed v1.1 board intro
2024-10-15 Added v1.1 board info from top level
2024-10-15 Changes board to boards
2024-10-24 Changed EEPROM_nWP note (R32 ID)
    [06_Misc_1.SchDoc]
2024-10-24 Updated sys header notes
    [06_Misc_1.SchDoc]
2024-10-24 Updated notes
    [05_RPi_mPCIe.SchDoc]
2024-10-24 Updated CM notes
    [06_Misc_1.SchDoc]
2024-10-28 Updated Board Key Features chapter
2024-10-28 Updated Board Overview
2024-10-28 Added Raspberry CM4/5 Connector chapter
2024-10-29 Added chapter Raspberry Pi CM4/5 Configuration
2024-10-29 DIP switch note update
    [06_Misc_1.SchDoc]
2024-10-29 Added chapter DIP Switch configuration
2024-10-29 Added chapter Mini PCIe x1 Socket
2024-10-29 Added SPI, I2C, UART Interfaces chapter
2024-10-29 Added Front Display Connector chapter
2024-10-29 HDMI connectors changed
    HDMI connectors changed to 2007435-3, footprint changed to a one with board lock option, PCB updated
    [10_USB_HDMI.SchDoc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]
2024-10-29 Added MIPI DSI Display and CSI Camera Connectors chapter
2024-10-29 Added GPIO Connector chapter
2024-10-29 Added Board Temperature Control chapter
2024-10-29 Added Power Distribution chapter
2024-10-29 Updated battery description
2024-10-29 Fixed FAN controller (EMC2301) I2C addr note
    [07_Misc_2.SchDoc]
2024-10-29 Fixed fan controller (EMC2301) I2C addr
2024-10-29 Initial 1v4 commit based on 1v3
    [01_Block_diag.SchDoc, 02_Power_RFFE_diag.SchDoc, 03_Clock_diag.SchDoc, 04_USB_diag.SchDoc, 05_RPi_mPCIe.SchDoc, 06_Misc_1.SchDoc, 07_Misc_2.SchDoc, 08_FPGA.SchDoc]
2024-10-29 Added LimeMicroAltiumLib submodule
    [LimePSB-RPCM_1v4.PrjPcb]
2024-10-29 Added AG5712-LPB
    [14_PoE_USB_PD.SchDoc]
2024-10-29 LimePSB-RPCM_1v3_DB_DFMr2 generated
    [LimePSB-RPCM_1v3.GBL, LimePSB-RPCM_1v3.GBO, LimePSB-RPCM_1v3.GBP, LimePSB-RPCM_1v3.GBS, LimePSB-RPCM_1v3.GM1, LimePSB-RPCM_1v3.GTL, LimePSB-RPCM_1v3.GTO, LimePSB-RPCM_1v3.GTP]
2024-10-29 LimePSB-RPCM_1v2_Schematic_r0.pdf generated
    Cosmetic changes to schematic
2024-10-30 Added AG5712-LPB module, changed output filter
    [14_PoE_USB_PD.SchDoc]
2024-10-30 Added DC isolation cap
    [14_PoE_USB_PD.SchDoc]
2024-10-30 Changed HW_VER from 0 to 1
    [08_FPGA.SchDoc]
2024-10-30 Changed revison from v1.3 to v1.4
    [01_Block_diag.SchDoc, 02_Power_RFFE_diag.SchDoc, 03_Clock_diag.SchDoc, 04_USB_diag.SchDoc, 05_RPi_mPCIe.SchDoc, 06_Misc_1.SchDoc, 07_Misc_2.SchDoc, 08_FPGA.SchDoc]
2024-10-30 Changes C261, C262 PN R273, R274 NF
    [14_PoE_USB_PD.SchDoc]
2024-10-30 Changed R273 PN
    [14_PoE_USB_PD.SchDoc]
2024-10-30 Added note
    [14_PoE_USB_PD.SchDoc]
2024-10-30 PCB layout finished
2024-11-07 Changed project name to "LimePSB RPCM Boards"
2024-11-14 Changed R135 from 1k to 330R
    [15_Power.SchDoc]
2024-11-14 C300 changed to fit
    [15_Power.SchDoc]
2024-11-14 NF on page 15 updated
    [15_Power.SchDoc]
2024-12-12 fix Board power sources list
2025-01-20 Marked HDMI sockets
    [10_USB_HDMI.SchDoc]
2025-01-20 Note for A/V socket
    [06_Misc_1.SchDoc]
2025-01-20 Added pull down resistor for RPI_PIN18 (2.2k) and RPI_PIN16 (2.2k NF).
    These pins are connected directly to the CM4/5 module's Ethernet PHY and appear to be used as bootstrap configuration pins, although such information is not provided in the CM4/5 documentation.
    Due to the connected unconfigured FPGA with internal pull ups, the levels of these lines change and the Ethernet phy no longer detected.
    It seems that the level of the RPI_PIN18 line for CM4/5 must be low, and also the level of the RPI_PIN16 line for CM4 must be low (not critical?) and high for CM5.
    [12_Clock_2.SchDoc]
2025-01-20 Added 2.2k NF pull down resistors on lines RPI_SYNC_OUT_LS and RPI_SYNC_IN
    [12_Clock_2.SchDoc]
2025-01-20 Added int to INT_TO_EXT2. Renamed INT_TO_EXT to INT_TO_EXT1.
    [07_Misc_2.SchDoc]
2025-01-20 Changed J28 part from Molex 87831-5920 to Amphenol ICC G823J201240BHR.
    Molex part has wrong housing, voided pin position (13) and too thick pins.
    [09_USB_hub.SchDoc]
2025-01-22 Changed tactile switch from 1825027-5 (L=3.86mm) to CT1102V6.85F160 (L=6.85mm)
    [06_Misc_1.SchDoc]
2025-01-22 Changed lightpipes from SLP3-200-100-F to SLP3-150-100-F to have similar center line with button on the front panel.
    SLP3-200-100-F: Center line (X)=0.200" (5.1mm), Protrusion (Y)=0.100" (2.54mm), Flat face
    SLP3-150-100-F: Center line (X)=0.150" (3.8mm), Protrusion (Y)=0.100" (2.54mm), Flat face
    [07_Misc_2.SchDoc]
2025-01-22 Added GNSS_RF_IN connection option to INT_TO_EXT2 via 0R.
    [07_Misc_2.SchDoc]
2025-01-22 Added 0R NF on GNSS_RF_IN net in series with U.FL connector, changed J44 to NF.
    [12_Clock_2.SchDoc]
2025-01-22 3D bodies updated
    J28, LED pipes, BTN1, SMA edge added
2025-01-22 SMA layout updated. New resistors connected
2025-01-22 Changed HDR_INT_TO_EXT2 header type (without lock)
    [07_Misc_2.SchDoc]
2025-01-22 Connected ESD34 to J44
    [12_Clock_2.SchDoc]
2025-01-22 RF layout finalized, BOM template updated
2025-01-23 Added optional function for BTN1: CM5 PWR_button.
    [06_Misc_1.SchDoc]
2025-01-27 Added Default variant
    [LimePSB-RPCM_1v4.PrjPcb]
2025-01-27 Updated parts fit information for Default variant (initial)
    [LimePSB-RPCM_1v4.PrjPcb]
2025-01-28 Added parameters: PROJECT_VERSION, SHEET_TOTAL
    [LimePSB-RPCM_1v4.PrjPcb]
2025-01-28 Added parameters to sheet parameters values
    Revision =PROJECT_VERSION
    SheetTotal =SHEET_TOTAL
    [01_Block_diag.SchDoc, 02_Power_RFFE_diag.SchDoc, 03_Clock_diag.SchDoc, 04_USB_diag.SchDoc, 05_RPi_mPCIe.SchDoc, 06_Misc_1.SchDoc, 07_Misc_2.SchDoc, 08_FPGA.SchDoc]
2025-01-28 Removed NF marks
    [05_RPi_mPCIe.SchDoc, 06_Misc_1.SchDoc, 07_Misc_2.SchDoc, 08_FPGA.SchDoc, 09_USB_hub.SchDoc, 10_USB_HDMI.SchDoc, 11_Clock_1.SchDoc, 12_Clock_2.SchDoc]
2025-01-28 Removed NF from Assembly Info fields
    [05_RPi_mPCIe.SchDoc, 06_Misc_1.SchDoc, 07_Misc_2.SchDoc, 08_FPGA.SchDoc, 09_USB_hub.SchDoc, 10_USB_HDMI.SchDoc, 11_Clock_1.SchDoc, 12_Clock_2.SchDoc]
2025-01-28 Added header for power switch
    [15_Power.SchDoc]
2025-01-28 Updated RGB pin note
    [08_FPGA.SchDoc]
2025-01-28 Updated GNSS module note
    [12_Clock_2.SchDoc]
2025-01-28 FPGA flash NF (IC18, C61)
    [LimePSB-RPCM_1v4.PrjPcb]
2025-01-28 Temperature sensors bypass capacitor (C29) fit
    [LimePSB-RPCM_1v4.PrjPcb]
2025-01-28 Added testpoints for RPI_I2C0_SCL and RPI_I2C0_SDA.
    [07_Misc_2.SchDoc]
2025-01-28 Updated Board SPI interfaces note
    [05_RPi_mPCIe.SchDoc]
2025-01-28 schematic template updated
    [01_Block_diag.SchDoc, 02_Power_RFFE_diag.SchDoc, 03_Clock_diag.SchDoc, 04_USB_diag.SchDoc, 05_RPi_mPCIe.SchDoc, 06_Misc_1.SchDoc, 07_Misc_2.SchDoc, 08_FPGA.SchDoc]
2025-01-29 Removed power switch header wir bypass resistor
    [15_Power.SchDoc]
2025-01-29 Added PROJECT_VERSION variable to new template Revision field
    [01_Block_diag.SchDoc, 02_Power_RFFE_diag.SchDoc, 03_Clock_diag.SchDoc, 04_USB_diag.SchDoc, 05_RPi_mPCIe.SchDoc, 06_Misc_1.SchDoc, 07_Misc_2.SchDoc, 08_FPGA.SchDoc]
2025-01-29 Removed from PROJECT_VERSION letter v
    [LimePSB-RPCM_1v4.PrjPcb]
2025-01-29 Renamed "Assembly Info" parameter to "Additional Info"
    [05_RPi_mPCIe.SchDoc, 06_Misc_1.SchDoc, 07_Misc_2.SchDoc, 08_FPGA.SchDoc, 09_USB_hub.SchDoc, 10_USB_HDMI.SchDoc, 11_Clock_1.SchDoc, 12_Clock_2.SchDoc]
2025-01-29 Updated note for 3.5mm A/V socket
    [06_Misc_1.SchDoc]
2025-01-29 INT_TO_EXT2 U.FL NF
    [LimePSB-RPCM_1v4.PrjPcb]
2025-01-29 Updated int to ext note
    [07_Misc_2.SchDoc]
2025-01-29 Renamed MCP23017 GPB7 IO net FAN_CTRL to EXP_GPB7
    [07_Misc_2.SchDoc]
2025-01-29 Added series 0R resistor for CDONE green LED
    [08_FPGA.SchDoc]
2025-01-29 Added EXP_GPB7 connection options to FPGA_CDONE and FAN_CTRL lines via 0R NF resistors.
    [07_Misc_2.SchDoc]
2025-01-29 EXP_GPB7 resistos to FPGA_CDONE and FAN_CTRL lines NF
    [LimePSB-RPCM_1v4.PrjPcb]
2025-01-29 FPGA_CDONE note
    [07_Misc_2.SchDoc]
2025-01-30 Added tespoint for EXP_GPB7.
    [07_Misc_2.SchDoc]
2025-02-06 Updated PoE note
    [14_PoE_USB_PD.SchDoc]
2025-02-06 Moved R321 from sheet 15 (Power) to sheet 08 (FPGA)
    [08_FPGA.SchDoc, 15_Power.SchDoc, LimePSB-RPCM_1v4.PrjPcb]
2025-02-06 Added 100R NF for TCXO_DAC_VREF line to have VCC2P5 power rail option
    [11_Clock_1.SchDoc, LimePSB-RPCM_1v4.PrjPcb]
2025-02-06 VCC2P5 circuit NF
    [LimePSB-RPCM_1v4.PrjPcb]
2025-02-06 Added VCC2P5 note
    [15_Power.SchDoc]
2025-02-06 Added testpoints for FPGA_I2C_SCL and FPGA_I2C_SDA.
    [08_FPGA.SchDoc]
2025-02-12 HDMI connectors added, PCB updated
    [10_USB_HDMI.SchDoc]
2025-02-19 Changed from Type A HDMI sockets to Type D(Micro) HDMI sockets
    [10_USB_HDMI.SchDoc]
2025-02-19 Updated HDMI symbol
    [10_USB_HDMI.SchDoc]
2025-02-20 Removed J38 and JMP3
    [12_Clock_2.SchDoc]
2025-02-20 Removed J35+JMP3 and replaced with analog mux for REF_CLK_IN line
    [11_Clock_1.SchDoc]
2025-02-20 Removed J39+JMP4 and replaced with analog mux for PCIE_PPS_IN line
    [12_Clock_2.SchDoc]
2025-02-20 Removed J42+JMP7 and replaced with analog mux for SYNC_OUT line
    [12_Clock_2.SchDoc]
2025-02-20 Removed J40+JMP5 and replaced with analog mux for RPI_SYNC_IN line
    [12_Clock_2.SchDoc]
2025-02-20 Removed J41+JMP6 and replaced with analog mux for RPI_SYNC_IN line
    [12_Clock_2.SchDoc]
2025-02-20 Removed J36+JMP2 and replaced with analog mux for EXT_SYNC_OUT line
    [12_Clock_2.SchDoc]
2025-02-20 Reverted IC13 MCP23017 GPB7 connection to FAN_CTRL
    [07_Misc_2.SchDoc]
2025-02-20 Moved FPGA_CRESET to new IO expander together with FPGA_CDONE line
    [07_Misc_2.SchDoc]
2025-02-20 Added new MCP23017 IO expander
    [16_Temp.SchDoc]
2025-02-20 Removed R3+R8 and replaced with analog mux for PCIE_PPS_OUT line
    [05_RPi_mPCIe.SchDoc, 16_Temp.SchDoc]
2025-02-21 Fixed 74LVC1G3157FZ4 pin 4 connections
    [11_Clock_1.SchDoc, 12_Clock_2.SchDoc, 16_Temp.SchDoc]
2025-02-21 Layout redesigned
    HDMI connected, new switches, muxes and expander routed, silkscreen and assembly updated. HDMI matching to be done after appropriate grouping added
2025-02-25 Connected FPGA_CDONE_LED to I/O expander
    [08_FPGA.SchDoc, 16_Temp.SchDoc]
2025-02-25 Moved MCP23017 additional IO expander from temp sheet to Misc_2 sheet
    [07_Misc_2.SchDoc, 16_Temp.SchDoc]
2025-02-25 FPGA_CDONE LED resistor NF
    [LimePSB-RPCM_1v4.PrjPcb]
2025-02-26 3D step model generated for case reference
2025-02-26 Renamed REF_ADF to ADF_RFIN, Renamed REF_CLK_IN to ADF_REFIN
    [07_Misc_2.SchDoc, 11_Clock_1.SchDoc]
2025-02-26 Moved R211 from Clock_2 sheet to RPi_mPCIEe sheet
    [05_RPi_mPCIe.SchDoc, 12_Clock_2.SchDoc]
2025-02-26 R2, R4 NF (fix?)
    [LimePSB-RPCM_1v4.PrjPcb]
2025-02-26 Cosmetic R211
    [05_RPi_mPCIe.SchDoc]
2025-02-26 Added 0R in series to PCIE_UIM4
    [05_RPi_mPCIe.SchDoc]
2025-02-26 Moved EXT_SYNC_OUT switch from Clock_2 to Clock_1 sheet
    [11_Clock_1.SchDoc]
2025-02-26 Moved switch frMoved switch from temp sheet to Clock_2 sheet, Moved EXT_SYNC_OUT switch from Clock_2 to Clock_1 sheet om temp sheet to Clock2, moved
    [12_Clock_2.SchDoc, 16_Temp.SchDoc]
2025-02-26 Removed temp sheet
    [16_Temp.SchDoc, LimePSB-RPCM_1v4.PrjPcb]
2025-02-26 Revert "Removed temp sheet"
    This reverts commit 6e5c8f1fc6c531be27720082a0b7045ab0f15ded.
    [16_Temp.SchDoc, LimePSB-RPCM_1v4.PrjPcb]
2025-02-26 Revert "Moved switch frMoved switch from temp sheet to Clock_2 sheet, Moved EXT_SYNC_OUT switch from Clock_2 to Clock_1 sheet om temp sheet to Clock2, moved"
    This reverts commit 3c4e187636c08b487bf9c7f2970e370b8e2d20de.
    [12_Clock_2.SchDoc, 16_Temp.SchDoc]
2025-02-26 Revert "Cosmetic"
    This reverts commit a659ed6c2a4442699479b516b0be6538c500a7e8.
    [11_Clock_1.SchDoc]
2025-02-26 Revert "Moved EXT_SYNC_OUT switch from Clock_2 to Clock_1 sheet"
    This reverts commit 80fbe637126efbfc0a0ca81bd223d76bd2bb66e8.
    [11_Clock_1.SchDoc]
2025-02-26 Parts with ? designators numbered
    [05_RPi_mPCIe.SchDoc, 06_Misc_1.SchDoc, 07_Misc_2.SchDoc, 08_FPGA.SchDoc, 11_Clock_1.SchDoc, 12_Clock_2.SchDoc, 16_Temp.SchDoc]
2025-02-26 imported from schematic step 1 - good
2025-02-26 Moved clock switches to temp sheet
    [12_Clock_2.SchDoc, 16_Temp.SchDoc]
2025-02-26 imported from schematic step 2 - good
2025-02-26 Moved clock switches tfrom temp sheet to Clock_2
    [12_Clock_2.SchDoc, 16_Temp.SchDoc]
2025-02-26 imported from schematic step 3 - good
2025-02-26 Connected PCIE_PPS_IN_SEL, SYNC_OUT_SEL to IO expanders
    [07_Misc_2.SchDoc]
2025-02-27 Added NC for IC65 pins
    [07_Misc_2.SchDoc]
2025-02-27 R266, R267 NF
    [LimePSB-RPCM_1v4.PrjPcb]
2025-02-27 Renamed XO_VC to XORF_VC
    [11_Clock_1.SchDoc]
2025-02-27 Added tetspoint for XO DACs outputs
    [11_Clock_1.SchDoc]
2025-02-27 NF: R332, R333, R276, R278, R270, R272, R269, R271, R275, R277
    [LimePSB-RPCM_1v4.PrjPcb]
2025-02-27 Mark for note
    [14_PoE_USB_PD.SchDoc]
2025-02-27 Removed NF information
    [05_RPi_mPCIe.SchDoc, 06_Misc_1.SchDoc, 07_Misc_2.SchDoc, 08_FPGA.SchDoc, 09_USB_hub.SchDoc, 10_USB_HDMI.SchDoc, 11_Clock_1.SchDoc, 12_Clock_2.SchDoc]
2025-02-27 Removed MCP_RESET and MCP2_RESET net names
    [07_Misc_2.SchDoc]
2025-02-27 Added net classes for HDMI
    [10_USB_HDMI.SchDoc]
2025-02-27 Reanotated whole schematic
    [05_RPi_mPCIe.SchDoc, 06_Misc_1.SchDoc, 07_Misc_2.SchDoc, 08_FPGA.SchDoc, 09_USB_hub.SchDoc, 10_USB_HDMI.SchDoc, 11_Clock_1.SchDoc, 12_Clock_2.SchDoc]
2025-02-27 Connected EXP2_GPB4, EXP2_GPB5 to GPIO header
    [06_Misc_1.SchDoc, 07_Misc_2.SchDoc]
2025-02-28 PCB checked for DFM
2025-02-28 Revert "Reannotated whole project"
    This reverts commit 78590c471c902f2a96a974975174cb3f4dab1652.
    [05_RPi_mPCIe.SchDoc, 06_Misc_1.SchDoc, 07_Misc_2.SchDoc, 08_FPGA.SchDoc, 09_USB_hub.SchDoc, 10_USB_HDMI.SchDoc, 11_Clock_1.SchDoc, 12_Clock_2.SchDoc]
2025-02-28 Moved RFFE components
    [13_RFFE.SchDoc]
2025-02-28 PCB updated step 1
    [LimePSB-RPCM_1v4_BOMr0.xls]
2025-03-02 Reverted RFFE ch B NF info
    [LimePSB-RPCM_1v4.PrjPcb]
2025-03-02 Updated USB PD 1.5A note
    [14_PoE_USB_PD.SchDoc]
2025-03-02 Updated FPGA configuration modes fit/NF notes
    [08_FPGA.SchDoc]
2025-03-02 Changed SW1 designator to DSW1
    [06_Misc_1.SchDoc]
2025-03-03 Removed red markings from HDMI
    [10_USB_HDMI.SchDoc]
2025-03-03 Updated lightpipes note
    [07_Misc_2.SchDoc]
2025-03-03 Updated IO expander change note
    [07_Misc_2.SchDoc]
2025-03-04 Added new sheet (RF_PD)
    [16_RF_PD.SchDoc, LimePSB-RPCM_1v4.PrjPcb]
2025-03-04 Added 2x LTC5587 RF powerdetectors
    [16_RF_PD.SchDoc]
2025-03-04 Added couplers and reannotated new components
    [13_RFFE.SchDoc, 16_RF_PD.SchDoc]
2025-03-04 power detector routed
2025-03-05 RPI GPIO temp notes
    [05_RPi_mPCIe.SchDoc]
2025-03-05 Disconnected EXP2_GPB4 and EXP2_GPB5 from EXP2 IO expander. Disconnected TP3 from EXP2_GPB6 and TP4 from EXP2_GPB7.
    [07_Misc_2.SchDoc]
2025-03-05 Disconnected PCIE_LED_WWAN, PCIE_LED_WLAN, PCIE_LED_WPAN from RPI and connected to I2C expander EXP2.
    [05_RPi_mPCIe.SchDoc, 07_Misc_2.SchDoc]
2025-03-05 Connected RPI_SPI0_SCLK and RPI_SPI0_MISO to power detectors
    [16_RF_PD.SchDoc]
2025-03-05 Connected RFPD1_CONV to RPI GPIO25 and RFPD2_CONV to RPI GPIO26
    [05_RPi_mPCIe.SchDoc]
2025-03-05 Connected RFPD_EN to EXP GPB3
    [07_Misc_2.SchDoc]
2025-03-05 Disconnected ADF_MUXOUT from RPI GPIo3 and connected to EXP2 GPB4.
    [05_RPi_mPCIe.SchDoc, 07_Misc_2.SchDoc]
2025-03-05 Connected RPI_GPIO3, RPI_GPIO6 to GPIO header
    [05_RPi_mPCIe.SchDoc, 06_Misc_1.SchDoc]
2025-03-05 Cosmetic for PoE
    [14_PoE_USB_PD.SchDoc]
2025-03-05 Moved RF PD from temp sheet to 14 sheet
    [14_PoE_USB_PD.SchDoc, 16_RF_PD.SchDoc]
2025-03-05 Removed RF_PD temp sheet
    [16_RF_PD.SchDoc, LimePSB-RPCM_1v4.PrjPcb]
2025-03-05 Renamed sheet 14_PoE_USB_PD to 14_RFPD_PoE_USB_PD
    [14_RFPD_PoE_USB_PD.SchDoc, LimePSB-RPCM_1v4.PrjPcb]
2025-03-05 R340, R342, R343 NF
    [14_RFPD_PoE_USB_PD.SchDoc, LimePSB-RPCM_1v4.PrjPcb]
2025-03-05 Renamed RFPD1_RFIN to RFPDA_RFIN, RFPD2_RFIN to RFPDB_RFIN, RFPD1_CONV to RFPDA_CONV, RFPD2_CONV to RFPDB_CONV
    [13_RFFE.SchDoc, 14_RFPD_PoE_USB_PD.SchDoc]
2025-03-05 RFPDA_CONV, RFPDB_CONV
    [05_RPi_mPCIe.SchDoc]
2025-03-05 Replaced 0R with inductor symbol
    [14_RFPD_PoE_USB_PD.SchDoc]
2025-03-05 Changed RFPD Cin capacitance
    [14_RFPD_PoE_USB_PD.SchDoc]
2025-03-06 Removed temp RPI SPI CS info
    [05_RPi_mPCIe.SchDoc]
2025-03-06 Updated GNSS_RF_IN change note
    [12_Clock_2.SchDoc]
2025-03-06 Added PoE change note
    [14_RFPD_PoE_USB_PD.SchDoc]
2025-03-06 Updated RFFE diagram
    [02_Power_RFFE_diag.SchDoc]
2025-03-10 Imported PCB. Callouts not updated!
2025-03-10 Replaced discontinued SKY13286-359LF RF switched with F2972NEGK
    [13_RFFE.SchDoc]
2025-03-10 Fixed RXB connections
    [13_RFFE.SchDoc]
2025-03-10 Swapped RF switches RF1 and RF2 ports
    [13_RFFE.SchDoc]
2025-03-10 RF switch changes synchronized. Layout to be done
2025-03-11 PCB routed, error fixed on page 13
    schematic error marked and fixed. DRC pass
    [13_RFFE.SchDoc]
2025-03-12 Updated RF switches change note
    [13_RFFE.SchDoc]
2025-03-12 R344, R348, R345, R349 NF
    [LimePSB-RPCM_1v4.PrjPcb]
2025-03-12 Added pull up for RF_SW_TDD and changed pull down to NF.
    [07_Misc_2.SchDoc, LimePSB-RPCM_1v4.PrjPcb]
2025-03-12 Updated F2972 symbol and reconnected
    [13_RFFE.SchDoc]
2025-03-12 Reannotation pushed to PCB, DRC pass
2025-03-12 Updated FPGA configuration modes parts notes
    [08_FPGA.SchDoc]
2025-03-12 Updated USB_PD_I note
    [14_RFPD_PoE_USB_PD.SchDoc]
2025-03-13 Updated power and RFFE diagrams
    [02_Power_RFFE_diag.SchDoc]
2025-03-13 INT_TO_EXT1 fix
    [07_Misc_2.SchDoc]
2025-03-13 Updated RTX5032A, 40.00MHz notes
    [11_Clock_1.SchDoc, 12_Clock_2.SchDoc]
2025-03-13 Removed all changes marks and notes
    [05_RPi_mPCIe.SchDoc, 06_Misc_1.SchDoc, 07_Misc_2.SchDoc, 08_FPGA.SchDoc, 09_USB_hub.SchDoc, 10_USB_HDMI.SchDoc, 11_Clock_1.SchDoc, 12_Clock_2.SchDoc]
2025-03-13 Placed specific No ERC for violations
    [14_RFPD_PoE_USB_PD.SchDoc, 15_Power.SchDoc]
2025-03-13 Fixed incorrect links between project variant and schematic components
    [LimePSB-RPCM_1v4.PrjPcb]
2025-03-13 DFM database generated
    [LimePSB-RPCM_1v4.GBL, LimePSB-RPCM_1v4.GBO, LimePSB-RPCM_1v4.GBP, LimePSB-RPCM_1v4.GBS, LimePSB-RPCM_1v4.GM1, LimePSB-RPCM_1v4.GTL, LimePSB-RPCM_1v4.GTO, LimePSB-RPCM_1v4.GTP]
2025-03-18 Updated RUN_PG note size
    [05_RPi_mPCIe.SchDoc]
2025-03-25 Updated USB3 socket J33 symbol (fixed incorrect Top Bottom marks). Updated notes accordingly. Renamed nets accordingly:
    Updated USB3 socket J33 symbol (fixed incorrect Top Bottom marks).
    Updated notes accordingly.
    Renamed nets accordingly:
    USB3S_B_D_N to USB3S_T_D_N
    USB3S_B_D_P to USB3S_T_D_P
    USB3S_B_RX_N to USB3S_T_RX_N
    USB3S_B_RX_P to USB3S_T_RX_P
    USB3S_B_TX_N to USB3S_T_TX_N
    USB3S_B_TX_P to USB3S_T_TX_P
    [06_Misc_1.SchDoc, 10_USB_HDMI.SchDoc, LimePSB-RPCM_1v4.PrjPcb]
2025-03-25 USB name changes imported from schematic
2025-03-25 schematic pdf refreshed
2025-03-25 Old schematic removed, new schematic renamed to (Default)
2025-03-26 Updated EN_CM5_USB3 notes
    [06_Misc_1.SchDoc, 10_USB_HDMI.SchDoc]
2025-03-26 Renamed RPI_PIN11 to RPI_PIN111
    [05_RPi_mPCIe.SchDoc, 06_Misc_1.SchDoc]
2025-03-26 Updated RPI_PIN111 notes
    [06_Misc_1.SchDoc, 10_USB_HDMI.SchDoc]
2025-03-26 Updated nRPIBOOT note
    [09_USB_hub.SchDoc]
2025-05-14 Updated ADC_USR_DIV note
    [07_Misc_2.SchDoc]
2025-05-20 Added EXP0 and EXP1 notes to MCP23017
    [07_Misc_2.SchDoc]
2025-06-02 Standoff nuts added, PCB updated, change log added
    [05_RPi_mPCIe.SchDoc]
2025-06-02 LimePSB-RPCM_1v4_(DB)_DFMr1 generated
    LimePSB-RPCM_1v4(_DB)_DFMr1:
    - schematic page 5 - mechanical spacers changed to parts with footprints
    - M.2 connector (J3) footprint changed to MiniPCIe_connector_XTRX_v2, which doesn't include mounting holes
    - DFM files refreshed: Top paste gerber layer, Assembly drawings PDF, Pick and Place files, schematic PDF
    [LimePSB-RPCM_1v4.GBL, LimePSB-RPCM_1v4.GBO, LimePSB-RPCM_1v4.GBP, LimePSB-RPCM_1v4.GBS, LimePSB-RPCM_1v4.GM1, LimePSB-RPCM_1v4.GTL, LimePSB-RPCM_1v4.GTO, LimePSB-RPCM_1v4.GTP]
2025-06-18 Fixed DC barrel J50 part fields
    [15_Power.SchDoc]
2025-06-19 Added LED7 FPGA LED for UI sheet
2025-06-19 Added I2C addr for USB hub and updated USB hub config note
    [09_USB_hub.SchDoc]
2025-06-19 Changed L2, L3 part number (wrong tolerance)
    [13_RFFE.SchDoc]
2025-06-19 Revert "Merge branch 'main' of https://github.com/myriadrf/LimePSB-RPCM"
    This reverts commit ce7727054845b0a217ee69d6ce25a5002dfbcd0b, reversing
    changes made to 7fa95ac772513e4d1c3d184a181295ab5f5a4f40.
    [13_RFFE.SchDoc]
2025-06-19 R153, R154 NF (disconnected USB hub SMBus from RPI_I2C0)
    [LimePSB-RPCM_1v4.PrjPcb]
2025-06-20 mPCIe conn. additional info added, Solder top and ASM top updated
    [05_RPi_mPCIe.SchDoc]
2025-06-20 LimePSB-RPCM_1v4(_DB)_DFMr2 generated
    LimePSB-RPCM_1v4(_DB)_DFMr2:
    - Schematic changes:
    > Changed L2, L3 part number (wrong tolerance)
    > R153, R154 NF (disconnected USB hub SMBus from RPI_I2C0)
    > J3 - added additional info parameter and its value
    > Fixed DC barrel J50 part fields
    - PCB changes:
    > GND thermal pad added under miniPCIe on top soldermask and silkscreen
    > LED light pipe mounting hole radius reduced from 1.3 mm to 1 mm
    - DFM:
    > Schematic pdf generated
    > Gerber files and Drill files generated
    > BOM renamed to r2, skipping r1 name to match database
    > BOM updated - L2, L3 position P/N and info, removed R153, R154, J3 - added additional info parameter and its value
    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
    [05_RPi_mPCIe.SchDoc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]
2025-06-23 R103 NF (BOM_VER = 1) and added BOM_VER = 1 note
    [08_FPGA.SchDoc, LimePSB-RPCM_1v4.PrjPcb]
2025-06-23 Added thermalpad note for mPCIe
    [05_RPi_mPCIe.SchDoc]
2025-06-25 Updated thermal pad note
    [05_RPi_mPCIe.SchDoc]
2025-06-30 LimePSB-RPCM_1v4_(DB_)DFMr2 refreshed
    after BOM_VER change - BOM updated, PŲP refreshed, change log updated
    [LimePSB-RPCM_1v4_BOMr2_(Default).xls, Pick Place for LimePSB-RPCM_1v4(Default).csv]
2026-06-19 Initial commit made from v1.4
    [01_Block_diag.SchDoc, 02_Power_RFFE_diag.SchDoc, 03_Clock_diag.SchDoc, 04_USB_diag.SchDoc, 05_RPi_mPCIe.SchDoc, 06_Misc_1.SchDoc, 07_Misc_2.SchDoc, 08_FPGA.SchDoc]
2026-06-19 Changed PROJECT_VERSION from 1.4 to 1.5
    [LimePSB-RPCM_1v5.PrjPcb]
2026-06-19 Changed from HW_VER = 1 [0 1] to HW_VER = 2 [1 0]
    [08_FPGA.SchDoc]
2026-06-19 Changed from BOM_VER = 1 [0 0 1] to BOM_VER = 0 [0 0 0]
    [08_FPGA.SchDoc, LimePSB-RPCM_1v5.PrjPcb]
2026-06-19 Added new LC filter for VCC3P3_RF rail (for new RF switches)
    [13_RFFE.SchDoc]
2026-06-19 Replaced F2972NEGK with BGS12WN6 duo to obsolete part status.
    [13_RFFE.SchDoc]
2026-06-19 Moved VCC3P3_RF LC filter from sheet 13 to 15
    [13_RFFE.SchDoc, 15_Power.SchDoc]
2026-06-19 NF RF_SW_TDD caps
    [13_RFFE.SchDoc, LimePSB-RPCM_1v5.PrjPcb]
2026-06-22 Update 13_RFFE.SchDoc
    Swapped BGS12WN6 RF switch RF1 and RF2. The polarity of the control signal changed (inverted).
    [13_RFFE.SchDoc]
2026-06-22 Replaced fan ME80151V1-000U-A99 with MF80151V2-1000U-A99 duo to obsolete part status.
    [08_FPGA.SchDoc]
2026-06-22 Variant fix
    [LimePSB-RPCM_1v5.PrjPcb]
2026-06-22 PCB updated, output jobs updated, BOM added
    [LimePSB-RPCM_1v5_BOMr0_(Default).xlsx]
2026-06-22 Due to changed RF_SW_TDD polarity changed pull up to NF and changed pull down to fit.
    [07_Misc_2.SchDoc, LimePSB-RPCM_1v5.PrjPcb]
2026-06-22 updates pushed to pcb
2026-06-23 Removed marked changess
    [07_Misc_2.SchDoc, 08_FPGA.SchDoc, 13_RFFE.SchDoc, 15_Power.SchDoc]
2026-06-23 Generated schematic pdf
2026-06-23 LimePSB-RPCM_1v5(_DB)_DFMr0 generated
    [LimePSB-RPCM_1v5.GBL, LimePSB-RPCM_1v5.GBO, LimePSB-RPCM_1v5.GBP, LimePSB-RPCM_1v5.GBS, LimePSB-RPCM_1v5.GM1, LimePSB-RPCM_1v5.GTL, LimePSB-RPCM_1v5.GTO, LimePSB-RPCM_1v5.GTP]
2026-07-14 Updated J1, J2 Part Description and comment (=Part Description)
    [05_RPi_mPCIe.SchDoc]
